ciniml/fpga_samples/README.md

# FPGA Samples

GOWIN LittleBeeなどの小規模FPGA向けのサンプルやライブラリ

## 内容

### rtl

SystemVerilogで記述したモジュール

### src/main/scala

Chisel3で記述したモジュール

### src/test/scala

Chisel3で記述したモジュールのテスト

## ライセンス

Boost Software License 1.0
