ciniml/fpga_samples/rtl/displayport/doc/edp_typec_altmode.md

# eDP 対応 / USB Type-C DP Alt Mode 対応の検討

現行資産 (DP 1.2 Source, RBR 1.62Gbps / 1レーン, Tang Primer 25K + Pmod DP,
FemtoRV32 FW によるリンクポリシー) を出発点に、(1) eDP パネル直結、
(2) USB Type-C DP Alternate Mode ソース、それぞれに必要な回路上の課題と
論理回路構成の変更を整理する。

---

## 1. eDP 対応

eDP はプロトコル的には DP のサブセット+拡張であり、メインリンク/AUX/8b10b/
フレーミングはそのまま流用できる。差分は主に「パネルは常時接続の既知デバイス」
であることに由来する。

### 1.1 回路上の課題

| 項目 | 内容 |
|---|---|
| コネクタ | eDP パネルは 30/40 ピン FPC (I-PEX 20453/20455 系など)。Pmod DP からの変換基板が必要。レーン数/ピン配置はパネルデータシート依存 |
| 電源シーケンス | パネル VDD (3.3V) → AUX/メインリンク → バックライトの順序と T1〜T12 タイミング制約 (eDP 規格 §T-parameters)。違反するとパネルが応答しない/劣化する。電源イネーブル用 FET スイッチと GPIO 制御が必要 |
| バックライト | LED ドライバ (昇圧、定電流) が別途必要。調光は PWM ピンまたは AUX (DPCD 0x720 系 backlight control) |
| 信号振幅 | eDP は低振幅スイング (200mV 級) が既定。現行 TLVDS_OBUF の振幅 (約350mV) はレシーバ耐性的には通常問題ないが、パネルによっては上限確認が必要 |
| HPD | パネルの HPD は「パネル準備完了」通知 (ホットプラグではない)。プルダウン/レベルは現行回路のままで可 |
| AUX プルアップ/ダウン | 現行 Pmod と同じ (AUX は 1Mbps Manchester、変更なし) |

### 1.2 論理回路 (RTL) の変更

1. **ASSR (Alternate Scrambler Seed Reset)** — 最重要。多くの eDP パネルは
   ASSR 必須 (eDP セキュリティ要件)。SR 受信時のスクランブラシード初期値を
   0xFFFF → **0xFFFE** に切り替える。
   - `scrambler.veryl`: シード定数を入力ポート化 (1 ビット選択で十分)
   - `main_link_tx_lane` 経由で CPU レジスタ (MAIN_LINK CTRL の空きビット) に接続
   - FW: DPCD 0x0000D (eDP_CONFIGURATION_CAP) を読み、0x0010A
     (eDP_CONFIGURATION_SET) bit0 で ASSR 有効化してからトレーニング
   - CDC: 準静的 (トレーニング前に設定) なので既存の 2FF 同期+false path 方式
2. **Fast Link Training / No-AUX training (任意)** — パネルが
   NO_AUX_HANDSHAKE_LINK_TRAINING に対応する場合、AUX 応答を待たず固定時間で
   TPS1→TPS2→通常動作に遷移できる。RTL 変更は不要 (パターン切替は既存レジスタ)
   で、FW のシーケンス追加のみ
3. **中間リンクレート (任意)** — eDP 1.4 の 2.16/2.43/3.24Gbps 等は PLL/OSER の
   再設計になるため当面対象外。RBR/1 レーンで一般的な HD 未満のパネルを駆動する
   場合は変更不要 (帯域: RBR 1 レーンで 1366x768@60 8bpp は不可、1024x600@60 等
   は可 — パネル選定に制約)
4. **バックライト/電源 GPIO** — cpu_io_out の空きビットをトップレベルで
   パネル電源/バックライトイネーブルに割当て (RTL は配線のみ)。PWM 調光を
   FPGA で行うなら小さな PWM モジュールを追加

### 1.3 FW の変更

- 電源シーケンサ (T1〜T12 のタイマ、GPIO 制御)
- ASSR 設定 → (Fast) リンクトレーニング → 映像有効化
- EDID が無いパネルへの対応 (タイミングを FW 定数で保持 — 現行の
  VideoConfig 方式そのままで適合)
- バックライト制御 (PWM duty または DPCD 0x720 系)

### 1.4 まとめ (eDP)

RTL 差分は実質 **ASSR のシード切替 1 点**。残りは基板 (電源シーケンス、
バックライト、コネクタ) と FW。現行アーキテクチャの半レートモード
(27Mpix) / フルレート (54Mpix) の制約内で駆動できるパネルを選ぶのが現実的。

---

## 2. USB Type-C DP Alternate Mode (ソース側)

Alt Mode は「DP 信号を Type-C コネクタのピンに載せ替える」仕組みで、
メインリンク/AUX のプロトコル自体は不変。課題のほぼ全てが
**USB PD (Power Delivery) ネゴシエーションと物理的なレーン切替** にある。

### 2.1 回路上の課題

| 項目 | 内容 |
|---|---|
| PD PHY | CC ライン上の BMC 変調 PD 通信は FPGA 直結不可 (1.2V 系アナログ)。PD PHY チップが必須。選択肢: (a) FUSB302B (I2C, PD スタックはホスト側=FW 実装)、(b) CYPD3125/STUSB4500 系スタンドアロン PD コントローラ (Alt Mode VDM まで自律処理する品種は限られる)、(c) TI TPS65982 等フル機能 PD+mux 統合 (BGA、入手性難) |
| 表裏反転 (orientation) | Type-C は表裏どちらでも挿せる。DP レーンを CC 判定結果に応じて物理的に入れ替える **SS mux (例: TI HD3SS460, PI3USB30532)** が必要。FPGA の出力ピンを 2 組用意して論理側で切り替える案は、82ns 級の高速差動を 2 系統引き回すことになり基板設計負荷が大きい → mux チップ推奨 |
| ピンアサイン | DP Alt Mode Pin Assignment C (4 レーン DP) / D (2 レーン DP + USB3)。現行 1 レーンでも「C の Lane0 のみ駆動」で成立する (シンク側は Configure で通知されたアサインの Lane0 から使う) |
| AUX の配線 | Type-C では AUX は SBU1/SBU2 に割当て。orientation で SBU も入れ替わるため、SS mux か専用 SBU スイッチ (例: HD3SS3220 内蔵、または FSA4159 級アナログ SW) が必要 |
| HPD | 物理ピンが存在しない。シンク→ソースの HPD/IRQ は **PD の Attention/Status Update VDM** で通知される。PD コントローラ経由で FW に伝える |
| VBUS/VCONN | ソースとして最低 5V VBUS 供給 (Rp 提示)。VCONN (E-Marker ケーブル給電) も規格上必要 |

### 2.2 論理回路 (RTL) の変更

1. **メインリンク/AUX: 変更ほぼ不要**。1 レーン RBR のままなら信号は現行と同一。
   将来 2 レーン (Pin Assignment D) に広げる場合はレーン複製 (roadmap の
   マルチレーン項目) が先行課題
2. **HPD の仮想化** — 現行 `hpd_in` は物理ピン前提。Alt Mode では PD
   コントローラからの通知 (I2C 読出し or 割込み) を FW が受け、
   仮想 HPD として扱う必要がある。
   - 案: SYSTEM レジスタに「FW が書ける仮想 HPD ビット」を追加し、
     `aux_ch_subsystem` の HPD 検出器の入力を `hpd_in | hpd_virtual`
     (または選択 mux) にする — 小規模な RTL 変更
   - HPD パルス幅分類 (IRQ/unplug) は PD の Attention メッセージ側で
     判別済みなので、仮想 HPD では分類器をバイパスするレジスタ経路が素直
3. **I2C マスタ** — PD PHY (FUSB302 等) 制御用。FemtoRV32 のレジスタ空間に
   I2C マスタペリフェラルを追加 (ソフト I2C を cpu_io_out の GPIO ビットで
   実装する手もあり、PD のタイミング要件的には HW マスタ推奨)
4. **レーン極性/順序反転 (保険)** — mux チップを使わず基板で反転を吸収する
   構成を選ぶ場合、10b シンボルのビット順反転・P/N 反転オプションを
   シリアライザ手前に入れる (数行の組合せ回路)。HD3SS460 採用なら不要

### 2.3 FW の変更 (最大の作業項目)

- **USB PD スタック**: Source ポリシー (Rp 提示、Source Capabilities、契約成立)
- **VDM シーケンス**: Discover Identity → Discover SVIDs (0xFF01 = DisplayPort)
  → Discover Modes → Enter Mode → DP Status Update → **DP Configure**
  (ピンアサイン C を指定) → mux/orientation 設定 → 以降は通常の DP ブリングアップ
- Attention 受信 → 仮想 HPD/IRQ_HPD への反映
- FUSB302 採用時は PD スタックを自前実装 (数千行規模、ただし
  ソース固定・Alt Mode 固定に絞れば大幅に削減可能)。
  スタンドアロン PD コントローラ採用ならレジスタ設定のみに縮む

### 2.4 段階案

1. **Step 0 (回路PoC)**: 市販の「Type-C → DP 変換基板 (シンク方向)」を逆用は
   不可 (方向が逆) — ソース用には PD コントローラ+mux 搭載の自作基板か、
   Alt Mode ホスト評価ボードが必要。まず FUSB302B + HD3SS460 + Type-C
   レセプタクルの小基板を起こすのが現実的
2. **Step 1**: 仮想 HPD レジスタ + I2C マスタを RTL に追加 (eDP とは独立、
   シミュレーションで検証可能)
3. **Step 2**: PD スタック FW (Source 固定、PD2.0 レベルで可) + VDM
4. **Step 3**: 実機で Configure 後に既存 DP ブリングアップへ接続

### 2.5 まとめ (Type-C)

RTL 差分は **仮想 HPD と I2C マスタの追加程度**で小さい。支配的なのは
(a) PD PHY / SS mux を載せた回路 (Pmod では完結しない、専用基板が必要) と
(b) PD/VDM の FW スタック。スタンドアロン PD コントローラを選べば FW も
大幅に軽くなるが、Alt Mode ソースを自律処理できる石の選定が鍵。

---

## 3. 共通の示唆

- どちらも**メインリンク RTL は現行のまま通用**する (eDP は ASSR のみ追加)。
  現在の 480p 半レートモード/タイミングクローズ資産はそのまま活きる
- 先行して入れておくと両対応が楽になる RTL 変更:
  1. スクランブラシード選択 (ASSR) — 1 ビット
  2. 仮想 HPD レジスタ経路 — SYSTEM レジスタ 1 ビット+mux
  3. I2C マスタペリフェラル (PD PHY 用、eDP でも外部 EEPROM/センサ流用可)
- 帯域は RBR×1 レーンが上限 (有効 1.296Gbps ≒ 54Mpix @24bpp)。eDP パネルや
  Alt Mode モニタで実用解像度を出すにはマルチレーン化 (roadmap 既載) が
  中期課題になる

---

## 4. 4レーン対応後の再評価 (2026-07-20 追記)

RBR×4レーン (コミット 1f6a060 で実機1080p60動作確認済み) を前提に、
両対応の見通しを更新する。

### 4.1 帯域とモードの整理

| 構成 | 有効帯域 | 24bpp での上限例 |
|---|---|---|
| RBR×1 | 162 MB/s | 480p/576p (27MHz) |
| RBR×2 | 324 MB/s | ~1600x900RB (97.75MHz=293MB/s) |
| RBR×4 | 648 MB/s | 1080p60 (148.5MHz) 実証済み |

### 4.2 「整数モードフィッティング」— eDPパネル駆動の鍵

現アーキテクチャの制約は「TU充填数 tu_active が整数」かつ
「line_symbols = htotal × LS/pclk が整数」。これは任意の tu_active =
k (1..64) に対して

    pclk = 162MHz × lanes × k / (64 × 3)

の**離散グリッド**のピクセルクロックをサポートすることを意味する:

- 4レーン: 3.375 MHz 刻み (k=42 → 141.75MHz, k=44 → 148.5MHz, ...)
- 2レーン: 1.6875 MHz 刻み
- 1レーン: 0.84375 MHz 刻み

eDPパネルは native タイミング固定ではなく、データシートに pclk と
ブランキングの許容範囲を持つ (典型: pclk ±5〜10%、htotal/vtotal に
min/max)。グリッド刻みが十分細かいため、**ほぼ任意のパネルを
「範囲内の整数フレンドリな pclk + htotal 調整 (LS/pclk = N/D の D の
倍数に選ぶ)」で駆動できる**。分数TU充填 (M/N計測ハードウェア) を
実装しなくても実用になる見込み。LINE_SYMBOLS/ACTIVE_WINDOW が
FWレジスタ化済みなので、この適合計算は全てFW側で完結する。

例: 1080p eDPパネル (pclk許容 130〜150MHz):
k=42 → pclk 141.75MHz、LS/pclk = 8/7 → htotal を7の倍数 (例 2058)、
vtotal 2058×?…refresh = 141.75M/(htotal×vtotal) を60Hz近傍に調整。

### 4.3 新たに見えた作業項目

1. **2レーンモード (中規模RTL)** — 現在 1/4 レーンのみ。eDPパネルの
   多数派 (30ピン2レーン品) と Type-C Pin Assignment D に必要。
   - フレーマ: ヘッダ (VB-ID,Mvid,Maud)×2/レーン、MSA 2レーン配置
     (21シンボル/レーン、Fig 2-18 — 仕様抽出済み)
   - ピクセルステアリング: pixel 2N→lane0, 2N+1→lane1
   - FIFO: quad の 2ピクセル語版 (または quad を2レーン読みに縮退)
   - 検証は quad TB の流用で低リスク
2. **ASSR (小規模RTL)** — スクランブラシード 0xFFFF→0xFFFE 切替 1ビット。
   共有LFSR化済みなので変更箇所は1定数+レジスタ1ビットのみ
3. **仮想HPDレジスタ (小規模RTL)** — Type-CのHPD-over-PD用
4. **I2Cマスタ (小規模RTL)** — PD PHY (FUSB302B) 制御用
5. (任意) 分数TU充填 — 4.2 の適合で足りないパネルが出た場合のみ

### 4.4 Type-C 側の更新

- **Pin Assignment C (4レーンDP) が実力で使える**ようになったため、
  USB-Cモニタへの1080p60出力は基板 (PD PHY + HD3SS460 mux + SBU SW +
  VBUS) と PD/VDM FW だけが残作業
- Assignment D (2レーンDP+USB3) は上記 2レーンモード実装後に対応可
- 4 OSER10 + 810MHz クロック網はタイミングクローズ済み構成をそのまま
  流用できる (162.3MHz)

### 4.5 推奨着手順序

1. ASSR + 仮想HPD + I2Cマスタ (すべてシミュレーションのみで検証可能、
   基板不要)
2. 2レーンモード (RTL+TB、基板不要)
3. Type-C 小基板設計 (FUSB302B + HD3SS460 + Type-Cレセプタクル) と
   PD Source FWスタック
4. eDPパネル選定 (40ピン4レーン品 or 2レーン品+2レーンモード) と
   変換基板・電源シーケンス回路

---

## 5. Type-C基板 具体構成案 (2026-07-21)

**採用方針: FUSB302B (PD PHY) + TI HD3SS460 (Alt Mode mux) の2チップ構成。**
HD3SS460は4レーンSSクロスポイントとSBU低速クロスポイントを1チップに
内蔵し、制御もピン(AMSEL/POL/EN)のみでFW負荷が最小。価格も安く、
FUSB340×2+SBUスイッチの分担構成(下記5.1〜、比較のため残す)より
部品点数・配線とも簡単になる。

### 5.0 HD3SS460構成

```
FPGA ML0..3 --100nF AC結合--> HD3SS460 (4レーンSS + SBUクロス) --> USB-C
FPGA AUX± (TLVDS_IOBUF+バイアス) --> HD3SS460 SBU側低速ポート
FPGA I2C <---> FUSB302B <---> CC1/CC2 (+VCONN)
FPGA GPIO: HD3SS460 {AMSEL(4レーンDPモード固定可), POL(向き), EN} + VBUS EN
5V --> 電流制限ロードスイッチ --> VBUS
```

- AMSELは4レーンDP固定でよい (Assignment C専用機として設計)。将来
  Assignment D対応時にFW制御へ昇格
- POLはFUSB302Bの向き判定結果をFWがGPIOで反映
- 追加部品はVBUSロードスイッチ・ESD・AC結合・AUXバイアスのみ
  (SBUスイッチ不要)

### 5.1 (比較対象) FUSB340×2の役割と個数

### 5.1 FUSB340の役割と個数

FUSB340はUSB3.1向けの表裏反転スイッチで、コモン側2差動ペア↔コネクタ側
4差動ペア(TX1/RX1/TX2/RX2)の2:1muxを1個で構成する。**DP Alt Mode
Assignment C (4レーン) にはSSペア4組すべてにDPレーンを載せる**ため、
2個使いにする:

- FUSB340 #A: コモン側 = ML0, ML1 → 正転時 TX1/RX1、反転時 TX2/RX2
- FUSB340 #B: コモン側 = ML2, ML3 → 正転時 TX2/RX2、反転時 TX1/RX1
- 両者のSELをFW GPIOで相補制御 (CC判定結果に従う)

パッシブ双方向muxなので「RX位置にソースのTXを流す」DPの使い方でも
問題ない。帯域10Gbps級でRBR 1.62Gbpsは余裕。

### 5.2 ブロック図

```
FPGA ML0..3 --100nF AC結合×4ペア--> FUSB340 x2 --> USB-C SS1/SS2ペア
FPGA AUX± (TLVDS_IOBUF+バイアス) --> SBUクロスバSW --> SBU1/SBU2
FPGA I2C (実装済みマスタ) <--------> FUSB302B <---> CC1/CC2 (+VCONN)
FPGA GPIO(cpu_io_out) ------------> FUSB340 SEL x2 / SBU SW SEL / VBUS EN
5V --> 電流制限ロードスイッチ --> VBUS
```

### 5.3 追加で必要な部品

| 部品 | 役割 | 候補 |
|---|---|---|
| SBUクロスバスイッチ | AUX±をSBU1/2へ、反転時は入替え | TS3USB221 / FSUSB42 / NX3L2267 等 (1MHz Manchesterなので低速品で可) |
| VBUSロードスイッチ | ソースとして5V供給 (電流制限付き) | AP22653, TPS25200 等 |
| ESD保護 | SS/SBU/CC | TPD4E05U06 等 |
| AC結合コンデンサ | MLレーン4ペア (DP規格必須) | 100nF 0201/0402 ×8 |
| AUXバイアス | AUX+ 100kΩプルダウン / AUX- 100kΩプルアップ (ソース側規定) | — |

### 5.4 FUSB302B側の留意点

- Rp提示・アタッチ検出・BMC PD送受・VCONN供給まで1チップで担える
- INT_Nは配線しておくが、FWは当面**I2Cポーリング**で十分 (現RTLに
  入力GPIOが無いため。必要になればSYSTEMレジスタに入力ビットを追加)
- HPDは物理線なし: PDのAttention/Status VDMをFWが受けて**実装済みの
  仮想HPDレジスタ (SYSTEM HPD bit4)** に反映する

### 5.5 FWドライバの作業分解 (FUSB302B)

1. 初期化: SW_RES → 電源/測定ブロック設定 → Rp提示 (Source)
2. アタッチ検出: CC測定 → 向き判定 → FUSB340 SEL/SBU SEL設定
3. PD契約: Source_Capabilities (5V固定で可) → Request受理 → Accept →
   PS_RDY
4. VDM: Discover Identity → Discover SVIDs (0xFF01確認) →
   Discover Modes (**UFP_DピンアサインマスクでC対応を確認**) →
   Enter Mode → DP Status Update → DP Configure (Assignment C, 4レーン)
5. Attention受信 → 仮想HPD更新 → 以降は既存のDPブリングアップへ合流
6. (省略可) SOP'ケーブルe-marker確認、PD3.0対応、Sink役割

### 5.6 未決事項

- 基板はPmod 2口分の高速ピンを使うか、専用ドーターか (MLペア4+AUX+
  I2C+GPIO×4+5Vで、現Pmod DPのピン割当を流用しつつ拡張が必要)
- USB2.0 D+/D-は未接続で可 (映像専用。Billboardデバイス非搭載だと
  Alt Mode失敗時にホスト側へ通知されないが、ソース用途では不問)

## 実機開通記録 (2026-08-06)

Tang Primer 25K + 自作Type-C基板(FUSB302B+HD3SS460) → XREAL Air 2 で
1080p60表示に成功。ブリングアップで確定した要点:

1. HD3SS460のEN/AMSEL/POLは3値ピン(H≥VCC-0.4V)。2.5Vバンクからは
   オープンドレイン駆動+基板10kプルアップ(3.3V)でHを作る(top.svは
   明示IOBUF)。4レーンDP = AMSEL=H, EN=H, POLは向き
2. シンクがプラグ(AMA/キャプティブケーブル)の場合、Mode VDOのピン
   アサインはbits15:8を読む(bit6=receptacle判定)
3. SourceCapは5V/3A広告(0.9AではCapability Mismatchでパネル起動保留)
4. Enter Mode NAK時はExit Mode→再Enter(前セッションのモード残留対策)
5. HPDはConfigure後のAttention/Status VDOで受ける。Air 2は約20秒かかる
   ので必ず待つ(HPD前にリンクを張るとレシーバが巻き込まれ停止)
6. **Air 2は映像アクティブ中にAUXが約1秒無通信だとHPDを落として切断**
   (キープアライブ)。モニタループは100ms間隔でstatusポーリング
