ciniml/fpga_samples/eda/csi_capture/hw/Pmod_RPiCamera/fab/Pmod_RPiCamera_schematic.pdf

1 | 2 | 3 | 4 | 5 | 6
1 | 2 | 3 | 4 | 5 | 6

AB

C

D

AB

C

D Date: 2026-10-12

Size: A4 | Rev: A
KiCad E.D.A. 10.0.6 | Id: 1/1

## Title: Pmod RPi Camera (MIPI CSI-2)

File: Pmod_RPiCamera.kicad_sch

Sheet: /

fpga_samples / eda/csi_capture

Raspberry Pi Camera v2 (IMX219) and other 15-pin 2-lane CSI-2 cameras GND

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
J1 Pmod (host) | GND 1 | D0_N 2 | D0_P 3 | GND 4 | D1_N 5 | D1_P 6 | GND 7 | CLK_N 8 | CLK_P 9 | GND 10 | CAM_GPIO 11 | CAM_CLK 12

SCL 13
SDA 14
3V3 15 | MP MP

J2

SFW15R-1STE1LF R2

2.2k | +3V3R3

10k +3V3 R1

2.2k +3V3 | GND

# GND +3V3 PWR_FLAG

PWR_FLAG | +3V3

F1
500mA hold GND

C1

10u | +3V3 +3V3_CAM CAM_SDA | CAM_GPIO

CSI_CLK_P

CAM_SDA | CAM_SCL | CSI_D1_N

CAM_SCL +3V3_CAM

GND

# CAM_SDA GND +3V3

CSI_CLK_N

CSI_D0_N +3V3 GND

CSI_D1_N | +3V3_CAM

CSI_D0_P

GND

GND

CSI_CLK_N +3V3 | CAM_GPIO

CAM_SCL CSI_CLK_P

GND

CSI_D1_P

CSI_D1_P

CSI_D0_P
GND

CSI_D0_N

CAM_GPIO (camera power enable) pulled up: the camera powers with the Pmod. CAM_CLK not used. J2: Amphenol SFW15R-1STE1LF (bottom contact, pin 1 as in FCI JSA95855), the same part as J1 of the Camera Module 2. The standard RPi camera cable has its contacts on opposite faces at the two ends: pin n meets pin n. F1 limits a wrong cable. Soft D-PHY receiver: FPGA LVDS inputs with on-chip 100R termination, no LP receivers

(eda/csi_capture, rtl/csi2). Lanes are DC coupled: no series R, no AC coupling, no bias. CSI pairs: 100 ohm differential, routed on F.Cu over solid B.Cu ground, no vias. Pmod RPi Camera: Raspberry Pi camera (15-pin FFC, 2-lane MIPI CSI-2) on one Pmod. | GND

J2
SFW15R-1STE1LF GND 1 | D0_N 2 | D0_P 3 | GND 4 | D1_N 5 | D1_P 6 | GND 7 | CLK_N 8 | CLK_P 9 | GND 10 | CAM_GPIO 11 | CAM_CLK 12

SCL 13
SDA 14
3V3 15 | MP MP
