ciniml/fpga_samples/eda/ethernet_hub75/README.md

# ethernet_hub75 — Ethernet / UDP 映像入力 → HUB75 LED マトリクス (Veryl)

PC から UDP で送った映像 (RGB565) を受けて HUB75 パネルに表示する。RTL はすべて Veryl で書いた。
プロトコルは Chisel 版 (`eda/ethernet_video`、`EthernetVideoSystem`) と互換で、送信側は既存の
`util/udpvideosend` / `util/play_video.sh` をそのまま使う。

| ボード | PHY | パネル | 状態 |
|---|---|---|---|
| Tang Primer 20K (Dock) | RTL8201F、RMII 100M | HUB75 ×2 系統 (各 64x64 ×2 枚のチェーン) = 128x128 | シミュレーション・配置配線 OK、実機未確認 |
| DK_LED-RXCARD_GW3A-LV20UG324S_V2.1 (Arora III) | RTL8211E、RGMII 10/100/1000M | HUB75 J4〜J9 に 64x64 を 1 枚ずつ、横 2 × 縦 3 = 128x192 (`PANEL_ROWS=2` で上 4 枚 128x128)。DDR2 版は J4〜J19 の 16 枚 (横 4 × 縦 4 = 256x256) まで | ソフト版 6 枚 / 4 枚、DDR2 フレームバッファ版 6 枚は実機で表示 OK (1000M)。GMT 版 (4 枚) と 16 枚構成はシミュレーション・配置配線 OK、実機未確認 |

```
PC (udpvideosend) ── UDP 10004 ──► PHY ─ RmiiRx ─ EthRxMac ─(PktFifo: PHY clk → sys)─► EthService ─► UdpVideoWriter
                 ◄── 0xdeadbeef ──      RmiiTx ─ EthTxMac ◄─(PktFifo: sys → PHY clk)──┘   ARP / ICMP     │ 色テーブル
                                                                                                         ▼ lane / addr / RGB666
                                                       Hub75Lanes: ダブルバッファ (sys 書き込み / 表示読み出し)、6 bit BCM
                                                                                                         ▼
                                                                                         HUB75 ×N レーン (CLK / LAT / OE / A–E 共通)
```

## ソースの構成

| 場所 | モジュール | 内容 |
|---|---|---|
| `rtl/eth_mac` | `Crc32Pkg` `PktFifo` | riscv-veryl から無変更でコピー (Tang Primer 20K の実機で動作済み)。`PktFifo` はデュアルクロックのストア＆フォワード FIFO で、受信は FCS の正しいフレームだけを読み手に見せる |
| | `EthRxMac` `EthTxMac` | PHY に依存しない MAC の受信 / 送信。riscv-veryl の `EthMac` の RX / TX エンジンを、CPU バスのレジスタ部を外して切り出した。PHY アダプタとは「SFD 後のバイト列」と「バイト要求 (`i_ce`)」でつなぐ |
| | `RmiiRx` `RmiiTx` | RMII アダプタ (100M) |
| | `RgmiiRx` `RgmiiTx` | RGMII アダプタ (10/100/1000M)。DDR の入出力レジスタ (ベンダのプリミティブ) はボードのトップに置き、その出力 / 入力だけを扱う。送信は全速度を 125 MHz 1 本で回す |
| | `RgmiiSpeedMeter` `MdioMaster` | RXC の周波数からリンク速度を判定 (MDIO のポーリング不要) / clause 22 の MDIO |
| `rtl/hub75` | `Hub75Lanes` | `Hub75` (dvi_hub75 と共通) の BCM 走査をそのまま使い、データ側を N レーン + デュアルクロックのフレームバッファにしたもの。`Hub75` 自体は変更していない |
| | `Hub75Planes` | `Hub75Lanes` のフレームバッファをビットプレーン形式 (1 ワード = 1 色 1 プレーンの 32 画素分) にしたもの。GMT 版で使う |
| | `Hub75RowLanes` | `Hub75Lanes` のフレームバッファを、レーンごとのピンポン行バッファ (2 × 64 画素) と「次の行をくれ」のハンドシェイクにしたもの。DDR2 版で使う |
| `rtl/ddr2` | `Ddr2Ctrl` `Ddr2PhyGw3a` | DDR2 コントローラ (x16、BL8、開いた行 1 本、読出の自動キャリブレーション) と GW3A の IOLOGIC (OSER8 / IDES8) による PHY。`rtl/ddr2/README.md` |
| `src/common` | `EthService` | ARP 応答、ICMP echo (TX FIFO に入る大きさまで)、UDP の振り分け。映像の送信元を覚えておき、表示切り替えのたびに ack を返す |
| | `UdpVideoWriter` | オフセット付きのバイト列 → 画素 → 色テーブル → レーン / アドレス。フレームの最終バイトで表示切り替えを要求する |
| | `GmtCornerTurn` | GW3A の GMT ハードブロック (`GMT_DB`) で 32 画素 × RGB666 を転置し、プレーンワードにして `Hub75Planes` に書く |
| | `DdrFb` `FbAfifo` | DDR2 版のフレームバッファ: UDP のバイト列を 16 B のワードにして DDR2 クロックへ渡し (async FIFO)、表示側の行要求に応じて DDR2 から行を読み、色テーブルを通して行バッファに書く。起動時のメモリテストとクリアもここ |
| | `EthernetHub75Core` | 上をつないだボード非依存のコア。クロックは PHY 受信 / PHY 送信 / システム / 表示の 4 系統 (同じでもよい)、DDR2 版はそれに DRAM の系統。`HUB75_IMPL` で出力段を選ぶ (0 = `Hub75Lanes`、1 = `GmtCornerTurn` + `Hub75Planes`、2 = `DdrFb` + `Hub75RowLanes`) |
| `src/tangprimer20k` | `TangPrimer20kTop` | PLL (27 → 49.5 MHz)、リセット、RMII アダプタ、ピン、LED |
| `src/dk_led_rxcard_gw3a20` | `DkLedRxcardTop` `Rtl8211eInit` | PLLB (50 → 125 / 50 / 333.3 MHz)、RGMII (IDDR / ODDR / IODELAY)、PHY の RGMII 遅延設定 (MDIO)、DDR2 (コントローラ + PHY)、ステータス、ピン、LED |

Veryl のプロジェクトはこのディレクトリ (`Veryl.toml`) で、`rtl/eth_mac`、`rtl/hub75`、`rtl/ddr2` をパス依存で取り込む
(生成される SV のモジュール名は `eth_mac_EthRxMac` のように依存先の名前が前に付く)。

## プロトコル (Chisel 版と互換)

- **映像:** UDP 宛先ポート 10004。ペイロード = 2 バイトのバイトオフセット (ビッグエンディアン) + データ。
  データは RGB565 リトルエンディアン、画面全体を行優先 (128x128 なら 32768 B。udpvideosend は 1024 B ずつ 32 パケット)
- **64 KB を超えるフレーム (追加):** 256x256 (128 KB) などではオフセットを 2 バイト単位で数える (最大 128 KB)。
  受信側はフレームの大きさから自動で切り替え、udpvideosend / `tools/testcards.py` も同じ規則で送る。64 KB 以下は元のまま
- **表示切り替え:** フレームの最終バイト (オフセット 32767) を書いたら切り替えを要求し、パネルの次のフレーム境界で切り替える
  (ティアリングなし)。切り替わったら、最後に映像を送ってきた送信元 (MAC / IP / ポート) に 4 バイトの `de ad be ef` を返す。
  udpvideosend はこの返信でペースを取る (返信がなければ 100 ms で次へ進む)。切り替え待ちの間に届いた映像データは捨てる
- **アドレス:** 192.168.10.2、MAC 11:22:33:44:55:66 (どちらも Chisel 版と同じ既定値、`EthernetHub75Core` のパラメータ)。
  この MAC は先頭バイトのグループ (マルチキャスト) ビットが立っている。Chisel 版ではこれで動いていたので互換のために残したが、
  PC 側で ARP が解決しないときは `02:…` などのローカル管理アドレスに変える
- **ARP / ICMP:** ARP 要求 (宛先ブロードキャストまたは自分) に応答、ICMP echo に応答 (`ping 192.168.10.2`)
- **色テーブル (追加):** UDP 宛先ポート 10005。ペイロード = チャネルマスク 1 バイト (bit0 R、bit1 G、bit2 B) + 8 bit 値
  (エントリ 0 から。R / B は RGB565 の 5 bit 値で引く 32 エントリ、G は 6 bit 値で引く 64 エントリ)。上位 `COMPONENT_BITS` bit を使う。
  リセット後は恒等 (ビット複製で 6 bit に伸ばす = Chisel 版と同じ見え方)。ホストからは `tools/send_lut.py gamma 2.2` など
- **ステータス (追加):** UDP 宛先ポート 10006 に何か送ると、送信元へ 48 バイトの状態を返す (DDR2 の初期化・キャリブレーション・
  読出位置の調整結果、メモリテストのエラー数 (パス別・ビット別)、リンク速度、表示したフレーム数など。中身は
  `src/dk_led_rxcard_gw3a20/top.veryl` の冒頭)。ホストからは `tools/fbstat.py`
- **制御 (追加、DDR2 版の診断用):** UDP 宛先ポート 10007。DDR2 の読出位置の上書きとメモリテストの再実行 (フレームバッファは
  消える)。`tools/ddr2sweep.py` は RD_LAT × RD_SEL を総当りして読出の目を測る
- **Chisel 版からの変更点:** 表示切り替えの 20 Hz 上限をなくした (パネルのフレーム境界で切り替え)。ポート 10000 (ループバック)、
  10001 (GPIO)、10002 / 10003 (音声) は持たない。色テーブルのポート 10005 を足した

帯域は 128x128 × 16 bit × 60 fps でペイロード 15.7 Mbps、ヘッダ込みで約 16.5 Mbps なので、100M で足りる。
udpvideosend は 1 フレーム分 (32 パケット) を間を空けずに送るので、GbE では受信側がワイヤレート (125 MB/s) で
処理し続ける必要がある。Arora 版はそのためシステムクロックを 125 MHz にしている (1 バイト / クロック)。
オフセットが 16 bit なので、元の形式で送れるのは 64 KB (128x256 相当) まで。それより大きいフレームは上の 2 バイト単位で送る。

## Tang Primer 20K

- **PHY:** Dock の RTL8201F (RMII)。50 MHz の基準クロックは PHY から来る (`rmii_txclk` = A9)。PHY はリセット中に
  クロックを止めるので、PHY のリセットピンはシステムクロック側で約 21 ms 駆動し、RMII 側のリセットはクロックが
  動き出してから外れるよう、その倍の時間かける
- **パネル:** `mod/pmod_hub75` + `mod/pmod_hub75_2` (eda/ethernet_video と同じピン)。2 系統は CLK / LAT / OE / A–E が共通で、
  各系統に 64x64 パネルを 2 枚チェーン (128x64、1/32 スキャン)。レーン 0–3 = 系統 1 の R1 / R2、系統 2 の R1 / R2 で、
  表示の行 0–31 / 32–63 / 64–95 / 96–127 に当たる
- **クロック:** システム・表示とも 49.5 MHz (27 MHz × 11 / 6)。HUB75 CLK = 49.5 / 3 = 16.5 MHz (Low 2 + High 1 クロック、
  dvi_hub75 の実機で通った 16.7 MHz とほぼ同じ)
- **LED (Active Low):** 0 = パネルのフレームごとに点滅 (約 1.4 Hz)、1 = 映像パケット受信、2 = ARP / ICMP 応答、
  3 = FCS 不良フレーム、4 = 表示切り替え、5 = PLL ロック

### 結果 (Gowin 1.9.12.03、GW2A-LV18PG256C8/I7)

| 項目 | 値 |
|---|---|
| 論理 | 2923 / 20736 (15%) — LUT 2440、ALU 273、SSRAM 35 |
| レジスタ | 1426 / 16173 (9%) |
| BSRAM | 44 / 46 — フレームバッファ 36 (レーンごとに 8K×2 bit ×9)、MAC の FIFO 8 (受信 8 KB、送信 2 KB) |
| Fmax | RMII 50 MHz 系 123.3 MHz、システム 49.5 MHz 系 119.9 MHz (違反なし。Arora 向けのレジスタ段追加後) |
| パネルのリフレッシュ | 356 Hz (6 bit BCM、16.5 MHz、シミュレーションで測定) |

BSRAM はほぼ埋まっている。パネルを大きくするなら、BCM のビット数を落とすか、フレームバッファを RGB565 のまま持って
読み出し側で色テーブルを引く形にする必要がある。

## ビルド

```
cd eda/ethernet_hub75
make                     # TARGET=tangprimer20k (既定)。veryl build → Gowin の合成 / 配置配線
make run                 # openFPGALoader で SRAM に書き込み (make deploy でフラッシュ)
make TARGET=dk_led_rxcard_gw3a20                  # Arora III、ソフト版 6 枚 128x192 (build/dk_led_rxcard_gw3a20)
make TARGET=dk_led_rxcard_gw3a20 PANEL_ROWS=2     # Arora III、ソフト版 上 4 枚 128x128 (build/dk_led_rxcard_gw3a20_4p)
make TARGET=dk_led_rxcard_gw3a20 HUB75_IMPL=gmt PANEL_ROWS=2   # Arora III、GMT 版 4 枚 (build/dk_led_rxcard_gw3a20_gmt_4p)
make TARGET=dk_led_rxcard_gw3a20 HUB75_IMPL=ddrplane PANEL_COLS=4 PANEL_ROWS=4   # 16 枚 256x256、8 bit (build/dk_led_rxcard_gw3a20_ddrplane_16p_c8)。展示で使っている構成
make TARGET=dk_led_rxcard_gw3a20 [...] run        # Gowin programmer_cli で SRAM に書き込み (変数はビルドと同じに)
make TARGET=dk_led_rxcard_gw3a20 CONN_ID=1         # 配線確認用: J4〜J19 にコネクタごとの単色 (build/dk_led_rxcard_gw3a20_connid)
make sim                 # テストベンチ (Verilator、Tang Primer 20K)
make -C test rxcard IMPL=soft|gmt|ddr|ddrplane|... [PROWS=2] [PCOLS=4 PROWS=4] [TXS=1]   # テストベンチ (Arora III、PROWS=2 は 4 枚、PCOLS=4 PROWS=4 は 16 枚、TXS=1 は TXC_SHIFTED 版)
```

gw_sh が PATH にないときは `make GW_SH="env LD_LIBRARY_PATH=$HOME/gowin/1.9.12.03/IDE/lib QT_QPA_PLATFORM=offscreen $HOME/gowin/1.9.12.03/IDE/bin/gw_sh"`
(1.9.12.03 の gw_sh は `IDE/lib` を先に読ませないと Qt のプラグインで落ちる)。Arora III のターゲットは
`eda/targets/dk_led_rxcard_gw3a20/target.mk` で 1.9.12.03 の gw_sh を直接指定している (GW3A-20A に対応するのは 1.9.12.03 のみ)。
`HUB75_IMPL` はビルドディレクトリに書き出すパッケージ `ethernet_hub75_cfg` 経由でトップのパラメータになる。
配置オプションは環境変数 `GW_PLACE_OPTION` / `GW_ROUTE_OPTION` で変えられる (Arora III の既定は place 2)。

## シミュレーション (Tang Primer 20K)

`make sim` (`test/tb_tp20k.sv`、Verilator 5): ボードのトップ (`TangPrimer20kTop`) をそのまま使い、RMII の向こう側の
ホストと HUB75 パネルモデルをつなぐ (PLL はシミュレーション用の置き換え、PHY リセットは短縮)。

1. ARP 要求 → 応答のフィールドを照合
2. ICMP echo 64 B / 1000 B → チェックサム (IP / ICMP)、ペイロード、長さを照合
3. FCS を壊したフレーム → 応答しない (捨てる)
4. 映像 1 フレーム (udpvideosend と同じ 32 パケット、乱数の画素) → ack を照合 → パネルモデルの 2 フレーム後の表示を全画素照合
5. 色テーブルを書き換えてから 2 フレーム目 → テーブルどおりの値になっているか全画素照合
6. もう一度 ARP (映像のあとも応答するか)

パネルモデルは CLK の立ち上がりでシフト、LAT ごとにビットプレーンを取り込み (行が変わったら MSB から)、
各プレーンの OE パルス長 (2 × 16 × 2^bit クロック) も検査する。チェーンの向きを反転させたビルドでは全画素が
不一致になることを確認済み (検査が効いていることの確認)。

## 実機の確認手順 (Tang Primer 20K)

1. HUB75 の配線は eda/ethernet_video と同じ (Dock の Pmod に HUB75 ベースボード 2 枚、各系統に 64x64 を 2 枚チェーン)
2. `make run` で書き込む。LED 5 (PLL ロック) が点灯、LED 0 が約 1.4 Hz で点滅すること
3. PC の有線 LAN を 192.168.10.1/24 にして Dock の RJ45 とつなぐ。`ping 192.168.10.2` が返り (LED 2 が点灯)、
   `ip neigh` に 11:22:33:44:55:66 が載ること
4. テストパターン: `cd util/udpvideosend && RUST_LOG=debug cargo run --release -- --width 128 --height 128 --test-pattern`。
   横縞のグラデーションが流れ、LED 1 と 4 が点灯していること。ログの fps が 100 を大きく超えていれば ack でペースが
   取れている (ack が返らないと 1 フレームごとに 100 ms 待つので、10 fps 前後に落ちる)
5. 動画: `cd util && VIDEO_FILE=<動画ファイル> ./play_video.sh` (128x128 に縮小して 20 fps で送る。同時に送られる音声
   (ポート 10002) は受け手がないので捨てられる)
6. 向きの確認: 左右が逆なら `CHAIN_REVERSE` を 1 に (トップのパラメータ)、上下や系統の入れ替わりはレーンの割り当てを見直す
7. ガンマ: `tools/send_lut.py gamma 2.2` / `tools/send_lut.py identity`

## Arora III (DK_LED-RXCARD_GW3A-LV20UG324S_V2.1)

資料: DBUG1298 (このボードのユーザーガイド、中国語版のみ)、DS1351、UG1353 / UG1354 (ピン)、UG311 (GMT)、UG313 (UBM)、
UG317 (クロック)、UG318 (GPIO)。いずれも `https://cdn.gowinsemi.com.cn/<文書番号>.pdf` (英語版は末尾に `E`) から
ログインなしで取れる。回路図そのものは公開されていない。

- **PHY:** RTL8211E ×2 (RGMII)。使うのは U43 ("PHY1": RXC が GCLKT_15 の H4、RXD は IODELAY のあるバンク 6)。
  U42 ("PHY2") の RXC は K4 = GCLKC_13 (相補側) なので使わない。どちらの RJ45 が U43 かは資料に書かれていない
- **RGMII の遅延:** RXDLY / TXDLY のストラップ抵抗が不明なので、起動時に MDIO で全アドレスを走査し、RTL8211E
  (PHY ID 1 = 0x001C) が見つかったら拡張ページ 0xa4 レジスタ 0x1c の bit 13:11 を 111 (強制 + RX / TX 遅延オン) にして
  オートネゴシエーションをやり直す (`Rtl8211eInit`、Linux の realtek ドライバと同じレジスタ。ドライバの定義とコメントで
  bit 12 / 11 のどちらが RX かが食い違っているので、両方を同じにしている)。PHY が遅延を入れるので、TXC は TXD と同じ
  ODDR から位相そろえで出し、受信は RXC で IDDR に直接取り込む。予備として PLL の 270° 出力で TXD を遅らせる版 (`TXC_SHIFTED`) と
  受信データの IODELAY (`RX_DELAY`) をパラメータで用意してある
- **速度:** 10/100/1000M に対応。RXC の周波数 (125 / 25 / 2.5 MHz) で速度を判定し、送信は 125 MHz のまま
  1000M = 毎クロック 1 バイト (DDR)、10/100M = 50 / 5 クロックごとに 1 ニブル (TXC はニブルの中央で立ち上がる)
- **パネル:** HUB75 コネクタ 1 つに 64x64 を 1 枚ずつ (チェーンなし)、横 `PANEL_COLS` (2 / 4) × 縦 `PANEL_ROWS` 枚を
  左上から行優先に J4、J5、… の順で割り当てる。既定は横 2 × 縦 3 で、上段 J4 (左) / J5 (右)、中段 J6 / J7、下段 J8 / J9
  = 128x192。`PANEL_ROWS=2` は上 4 枚 (J4〜J7) で 128x128。`PANEL_COLS=4 PANEL_ROWS=4` は J4〜J7 / J8〜J11 / J12〜J15 /
  J16〜J19 の 16 枚で 256x256 (DDR2 版のみ)。使わないコネクタは 0 (黒) を出す。レーンは幅 64 × 32 行で、表示を行優先に
  切ったもの。パネル (段 p、列 c) の R1 / R2 はレーン 2·PANEL_COLS·p + c / 2·PANEL_COLS·p + PANEL_COLS + c。
  コネクタは 2 組 (J4〜J11、J12〜J19) で、それぞれ CLK / LAT / OE / A–E を 1 本ずつ共有する。2 組目は 9 枚以上のとき 1 組目と
  同じ信号を出し、それ以外は OE を High にして消灯。HUB75 は 74HC245 経由。ピンは DBUG1298 の表 3-6〜3-21
  (J12〜J19 の一部は SSPI / CPU / I2C 兼用ピンなので、`project.tcl` で GPIO として使う設定にしている)
- **クロック:** 50 MHz (B16) → PLLB (VCO 1000 MHz) → システム / RGMII 送信 125 MHz、表示 50 MHz
  (HUB75 CLK = 50 / 3 = 16.7 MHz、dvi_hub75 の実機で通った値)
- **LED (Active Low):** LED1 = PLL ロック中、パネルのフレームごとに点滅 (約 1.4 Hz)。LED2 = 映像 / ARP / ICMP の受信で点灯、
  MDIO で RTL8211E が 1 つも見つからなかったときは速い点滅。ボタン (J6) はリセット

### HUB75 向けハードブロック: GMT

GW3A の「LED 向け」ブロックは HUB75 のドライバそのものではなく、次の 2 つ (どちらも GW3A-20 に 1 個):

- **GMT (Generic Matrix Transpose、プリミティブ `GMT_DB`、UG311):** 32 × 32 ビットの行列転置器 ×4 コンポーネント。
  各コンポーネントにピンポンバッファ 2 面。書き込みは 1 クロック 1 行 (`WADDR[5]` = 面、`WADDR[4:0]` = 行、`WDATA0..3`、`WEN0..3`)、
  読み出しは 1 クロック 1 列 (`RADDR`、データは次のクロック)。書き込みクロック最大 250 MHz、同じアドレスの書き→読み 5 ns 以内。
  書き込み行の付け替え表 (remap、mDRP で設定) あり。パラメータは `WADDR_REMAP_EN`、`COMP_EN`
- **UBM (Universal Bit Mapping、`UBM_DB`、UG313):** 32 ビットの任意ビット並べ替え ×4。GMT の出力をそのまま入力にできる
  (`BIT_REMAP_EN`、`USE_GMT_CLK`)。出力ピンの並びを合わせる用途

LED 受信カードでは「画素ごとのデータ (階調値) → ビットプレーンごとのデータ」への変換 (コーナーターン) を GMT で行う。
32 画素の階調値を 32 行として書くと、列 k を読んだ 32 ビットが「32 画素のビット k」= そのままシフトアウトできる形になる。

### ソフト版と GMT 版

| | ソフト版 (`HUB75_IMPL=soft`) | GMT 版 (`HUB75_IMPL=gmt`) |
|---|---|---|
| フレームバッファ | レーンごとに 1 画素 = RGB666 18 bit のワード | レーン × 色ごとに 1 ワード = 1 プレーンの 32 画素 |
| 書き込み | 画素ごとに 1 ワード | 32 画素を GMT に書き、18 列 (6 プレーン × 3 色) を読み出してワード書き込み |
| 表示 (シフトアウト) | 画素ワードからプレーンのビットを選ぶ (レーン × 3 本の 6:1) | ワードから x % 32 のビットを選ぶ (レーン × 3 本の 32:1) |
| 走査・BCM・タイミング | 共通 (`Hub75` と同じエンジン) | 共通 |

結果 (Gowin 1.9.12.03、GW3A-LV20UG324SC1/I0、place option 2。どちらも Ethernet 部込みの全体)。以下の表は J4 / J6 に 2 枚チェーンを
2 本つないだ最初の構成 (レーン 4 本 × 幅 128) のもの。今のパネル構成 (レーン幅 64) の結果はその下:

| 項目 | ソフト版 | GMT 版 |
|---|---|---|
| LUT / ALU | 2749 / 327 | 3142 / 331 |
| レジスタ | 1723 | 1873 |
| CLS | 2278 / 11520 (20%) | 2633 / 11520 (23%) |
| BSRAM | 84 / 120 — フレームバッファ 72 (レーンごと 18)、MAC の FIFO 12 | 108 / 120 — フレームバッファ 96 (12 メモリ × 8)、FIFO 12 |
| GMT | 0 | 1 (コンポーネント 0 のみ) |
| Fmax (制約) | RXC 225 (125)、システム 125.4 (125)、表示 85.5 (50) MHz | RXC 225 (125)、システム 125.3 (125)、表示 89.0 (50) MHz |
| リフレッシュ | 359.5 Hz (シミュレーションで測定) | 359.5 Hz (同じ) |
| 階調 | 6 bit BCM (RGB666、色テーブル経由) | 同じ |
| 最大シフトクロック | 表示 Fmax / 2 = 42 MHz (`CLK_LOW_EXTRA=0`)、既定は / 3 = 16.7 MHz | 同じ (表示 Fmax / 2 = 44 MHz) |
| 最大パネル (ダブルバッファ、6 bit) | 128x128 (BSRAM で決まる。256x128 には 144 個必要) | 128x128 (256x128 には 192 個必要) |

今のパネル構成 (64x64 を 1 枚ずつ、レーン幅 64):

| 構成 | LUT / ALU | レジスタ | BSRAM | Fmax システム / 表示 (MHz) | リフレッシュ |
|---|---|---|---|---|---|
| ソフト版 6 枚 128x192 (12 レーン) | 3186 / 327 | 1839 | 120 / 120 (100%) | 126.8 / 77.0 | 489.2 Hz |
| ソフト版 4 枚 128x128 (8 レーン) | 2942 / 327 | 1777 | 84 / 120 | 128.0 / 93.1 | 489.2 Hz |
| GMT 版 4 枚 128x128 (8 レーン) | 3635 / 331 | 1991 | 108 / 120 | 125.7 / 89.1 | 489.2 Hz |
| GMT 版 6 枚 | — | — | 入らない (下記) | — | — |

チェーンが 128 → 64 に短くなったので、リフレッシュは 359.5 → 489.2 Hz に上がる (行ごとの固定の待ちがあるので 2 倍にはならない)。
ソフト版 6 枚は BSRAM をすべて使っていて余裕がない。GMT 版はプレーンのメモリ (レーン × 色ごとに 6 プレーン × 128 ワード = 768 ワード)
が 1024 ワード = BSRAM 4 個に切り上げられるので、6 枚では 12 × 3 × 4 = 144 個必要になり入らない (合成がメモリを LUT に回して
リソース超過になる。make はこの組み合わせをエラーにしている)。プレーンを 2 枚ずつ 256 ワードのメモリに分ければ 3 個ずつ = 108 個
(FIFO と合わせて 120 個) にできる見込み

- **このデザインでは GMT 版のほうが重い。** フレームバッファを内蔵 BSRAM に置き、レーンごとに別のメモリを持つ構成では、
  ソフト版は書き込みが画素単位のまま済み、表示側のプレーン選択も 6:1 のセレクタで済むので、転置そのものが要らない。
  GMT 版は転置の制御 (グループ単位の書き出し、表示切り替えの保留) と 32:1 のビット選択が増え、LUT が約 400、FF が約 150 多い
- **BSRAM の差 (+24) はメモリの深さの端数。** プレーンメモリは 1 つ 1536 ワード (6 プレーン × 2 面 × 32 行 × 4 ワード) で、
  Gowin が 2048 ワード分 (8 個) を割り当てる。ビット数はソフト版と同じ (589,824 bit) なので、プレーン数を 8 にそろえる
  (階調 8 bit) か色をまとめたアドレス割り付けにすれば 72 個まで減らせる見込み。リフレッシュ・階調・シフトクロックは
  同じエンジンなので差がない
- **GMT が効くのは、画素データを外部メモリ (このボードの DDR2) に置く構成。** DDR から行単位で画素を読み、GMT でプレーン形式に
  変えて小さな行バッファに置けば、BCM の各プレーンのたびにフレームバッファを読み直さずに済み、パネルの大きさが BSRAM で
  決まらなくなる。そのとき同じ転置をソフトでやると、32 × 32 ビットの転置 1 組に約 1000 個の FF とセレクタが要る。
  4 コンポーネントで 16 本の出力 (このボードは 1 組あたり 48 本、計 96 本) を並列に作れる。今回は内蔵 BSRAM の構成のまま
  比べたので、この利点は数字に出ていない
- 1000M のワイヤレート処理のため、MAC / FIFO / `EthService` に 125 MHz 向けのレジスタ段を足した
  (`PktFifo` のポインタのグレイ→バイナリ変換、残りバイト数、`EthService` の判定、ack のチェックサム)。
  余裕はほぼない (システム 125.3〜125.4 MHz)。place option 1 / 3 では 1 ns 弱届かない

### DDR2 フレームバッファ版 (`HUB75_IMPL=ddr`)

フレームバッファをボードの DDR2 (U46 W9725G6KB、256 Mbit x16、バンク 2 / 3 の 1.8 V) に置く版。コントローラは Gowin の IP を使わず
`rtl/ddr2` に新しく書いた (riscv-veryl の DDR3 コントローラと同じスロットベクタ方式の PHY 境界。詳細は `rtl/ddr2/README.md`)。

```
EthService ─ 映像バイト列 ─ DdrFb: 16 B ワード + フリップ印 ─ FbAfifo (sys 125 MHz → mclk 83.3 MHz) ─┐
                                                                                                  ├─ Ddr2Ctrl ─ Ddr2PhyGw3a ─ DDR2
   Hub75RowLanes ◄─ 行バッファ書き込み ◄─ 色テーブル ◄─ 1 px/clk 展開 ◄─ 読み出し FIFO ◄─ 行フェッチ ──┘   (OSER8 / IDES8、
   (disp 50 MHz)      (レーン × 2 × 64 px)                                                                 fclk 333.3 MHz)
```

- **フレームバッファ:** RGB565 (受け取ったバイト列そのまま) の 2 面。面 b はバーストアドレス b × 4096 (64 KB) から。書き込みは
  16 B ワード単位 (DM が FPGA に繋がっていないため)。udpvideosend は 1024 B ずつ送るので問題ない
- **表示切り替え:** フレームの最終ワードにフリップの印を付けて同じ FIFO を通すので、書き込みとの順序が保たれる。表示側が次の
  フレームの行 0 を要求したときに面を切り替え、ack を返す。切り替え待ちの間の映像を捨てるのも含め、ソフト版と同じ振る舞い
- **行フェッチ:** 走査行 r の表示中に次の行を読む。レーンごとに 64 画素 = 8 バースト (DRAM の同じ行) をまとめて読み、BSRAM の
  32 ワード FIFO に入れてから 1 画素 / クロックで色テーブルを通して行バッファへ。12 レーン分 768 画素で約 9.3 µs、1 行の表示時間
  (約 64 µs) に十分収まる。DRAM の帯域は書き込み (最大 125 MB/s) + 読み出し (約 24 MB/s) に対しピーク 667 MB/s
- **起動時:** DDR2 の初期化とキャリブレーションの後、32 MB 全体を 2 パス (アドレス由来のデータ / その反転・回転、後者は 2 回
  読む) 書いて読み比べ、フレームバッファ 2 面を黒でクリアしてから表示を始める (約 0.2 s)。それまでパネルは黒
- **読出位置の調整 (`DdrReadTune`):** PHY は 1 ビート (3 ns) を 2 回サンプルするだけで、キャリブレーション (1 パターン) は
  一致した 2 サンプルのうち前を選ぶ。実機ではその前のサンプルがデータの切り替わり際にあり、32 MB のテストで数百語化けた。
  そこで最初のメモリテストにエラーがあれば、1 スロット後ろでもう一度テストし、偶数 / 奇数ビートごとにエラーの少ない方を採る
  (同数なら他方に合わせる。どちらも同じ fclk のエッジでサンプルしているため)。結果を確かめる 3 回目のテストで終わる (計約 0.6 s)
- **LED1:** メモリテストが通ると約 1.4 Hz で点滅、メモリテストかキャリブレーションが失敗すると速い点滅
- **クロック:** PLLB の clkout3 = 333.3 MHz (fclk、CK 166.7 MHz)、CLKDIV / 4 = 83.3 MHz (mclk、コントローラと `DdrFb`)

結果 (6 枚 128x192、Ethernet 部込みの全体):

| 構成 | LUT / ALU | レジスタ | BSRAM | Fmax システム / 表示 / mclk (MHz) | リフレッシュ |
|---|---|---|---|---|---|
| ソフト版 6 枚 (BSRAM、ステータスポート込み) | 3455 / 375 | 2103 | 120 / 120 | 125.1 / 77.7 / — | 489.2 Hz |
| DDR2 版 6 枚 | 6459 / 640 | 4004 | 32 / 120 | 127.4 / 124.8 / 87.6 (mclk 83.3) | 489.0 Hz (シミュレーション) |

BSRAM は行バッファ、読み出し FIFO と映像 FIFO (各 4、どちらも 128 bit 幅で決まる)、MAC の FIFO (受信 8 + 送信 4)。
行バッファは最初レーンごとに 1 個 (12 個、1 個あたり 2304 bit しか使わない) だったが、6 bit 階調では 2 レーンを 1 個にまとめた
(書き込み 18 bit / 読み出し 36 bit の幅違い BSRAM を Gowin が RTL から推論する) ので 6 個、全体で 26 個
(この変更後: LUT 6988、レジスタ 4908、Fmax システム 125.1 / 表示 175.2 / mclk 92.1 MHz、実機でメモリテスト・表示とも OK)。
8 bit 階調は 2 画素が 48 bit で BSRAM の最大幅 36 bit を超えるのでレーンごとのまま。プレーン形式の行バッファ (DDR2 + GMT 版) は
表示側が 36 本 × 32 bit を同時に読むので、読み出し幅の点で 32 個より減らせない。フレームバッファが BSRAM から出たので、
パネルの大きさは BSRAM で決まらなくなった (行バッファは 1 レーン 1 個)。上限は 1 行の表示時間内に行を読み切ることで、
プロトコルのオフセット 16 bit (64 KB) は 2 バイト単位に広げた (16 枚の節)。LUT はコントローラ (読み出しの窓・書き込みの並べ替え) とフレームバッファの
データ路 (128 bit) の分だけ増える。最初は DDR3 版と同じ 64 スロット (8 pclk) の履歴から任意の位置を選んでいたが、DDR2 では
読み出しが固定遅延で返るので、粗い位置を RD_LAT (pclk 単位) に任せて窓を 3 pclk に縮め、コントローラの LUT を 4300 → 2200、
レジスタを 2540 → 1250 に減らした (そのときの mclk の Fmax は 84.7 → 99.6 MHz。ステータスポートを足した最終版は 87.6 MHz)。

### DDR2 版に GMT を入れた比較 (`HUB75_IMPL=ddrgmt`)

DDR2 版と同じパラメータ (6 枚 128x192、12 レーン × 64、6 bit) のまま、行フェッチで出てくる画素 (1 px / clk) を
`GmtCornerTurn` (GMT_DB 1 個) でプレーンワードに転置し、プレーン形式の行バッファ `Hub75RowPlanes` (レーン × 色ごとに
{プレーン, バッファ, x / 32} の 32 bit ワード) から出す版。最後の 32 画素分は最終画素の約 20 クロック後に GMT から
出てくるので、行の完了通知を 32 クロック遅らせている。シミュレーションは DDR2 版と同じ検査 (`+ddr_marginal` 含む) で PASS、
リフレッシュも同じ 489.0 Hz。実機は未確認。

配置配線 (同じソース、place option 2):

| | DDR2 版 (`ddr`) | DDR2 + GMT 版 (`ddrgmt`) | 差 |
|---|---|---|---|
| LUT / ALU (全体) | 7387 / 875 | 8121 / 879 | +734 LUT |
| レジスタ (全体) | 5301 | 5469 | +168 |
| CLS | 6206 (54%) | 6896 (60%) | +690 |
| BSRAM | 32 / 120 | 56 / 120 | +24 |
| GMT | 0 | 1 | |
| 出力段 (行バッファ + 表示エンジン) | `Hub75RowLanes`: REG 189、LUT 631、BSRAM 12 | `GmtCornerTurn` REG 62、LUT 15 + `Hub75RowPlanes` REG 288、LUT 1228、BSRAM 36 | |
| Fmax システム / 表示 / mclk (MHz) | 125.0 / 133.6 / 112.2 | 125.2 / 110.9 / 113.3 | 表示 −17% |

- **このパラメータでは GMT 版のほうが重い。** 転置そのもの (GMT 側) は LUT 15 個で済むが、表示側が「画素ワードから
  プレーンのビットを選ぶ 6:1 × 36 本」から「プレーンワードから x % 32 のビットを選ぶ 32:1 × 36 本」に変わり、LUT が倍になる。
  表示クロックの Fmax が下がったのも、BSRAM の出力からこの 32:1 選択までの経路が長くなったためと見ている (余裕が大きく、
  レポートの上位経路に出てこないので推定)。50 MHz の制約には十分間に合う
- **BSRAM の +24 は深さの端数。** プレーン形式の行バッファはレーン × 色で 36 個のメモリになり、どれも 24 ワード
  (6 プレーン × 2 面 × 2 ワード) しかないのに BSRAM を 1 個ずつ使う。ビット数は画素形式 (12 個) と同じ
- **転置の速さは効いていない。** 行フェッチは 1 px / clk で 1 行 768 画素を約 9 µs で書き、1 行の表示時間 (約 64 µs) より
  ずっと短い。ソフト版でも画素形式のまま行バッファに置けば転置が要らないので、GMT の 32 画素 / 18 クロックの処理能力を
  生かす場面がない。GMT が効くのは、プレーン形式でしか間に合わない構成 (階調を 8 bit 以上にして BCM のプレーン数が増える、
  チェーンを長くする、シフトクロックを上げて表示側の 32:1 ではなくワード単位の出力が必要になる、外部メモリ自体を
  プレーン形式で持つ、など)

### 行バッファなし: DDR2 にプレーン形式で置く版 (`HUB75_IMPL=ddrplane` / `ddrplanesoft`)

画素を書き込むときに転置して DDR2 にビットプレーン形式で置き、表示は走査行の 1 プレーンずつ DDR2 から取り出す版。
行バッファ (BSRAM) はなく、1 プレーン分のピンポン (2 × 2304 bit) を分散 RAM に持つだけ。

```
EthService ─ UdpVideoWriter (色テーブル) ─ GmtCornerTurn (GMT、プレーン順に B, G, R) ─ バースト ─ FbAfifo ─┐
                                                                                                  ├─ Ddr2Ctrl
   Hub75PlaneStream ◄─ プレーンバッファ (分散 RAM、レーンごと 24 bit × 16) ◄─ ニブル展開 ◄─ 読み出し FIFO ◄─┘
```

- **DDR2 の配置:** 1 バースト = ある走査行 r、レーン l、ワード w (= x / 32)、プレーン p の R / G / B 3 ワード + 空き 4 B。
  アドレス {面, r, l, w, p}。32 画素のグループを転置した 6〜8 バーストは同じページに連続して書ける (DM がないので
  ワード単位で書けず、1 / 4 は空き)。表示の 1 プレーン = 24 バースト (3 ページ)
- **表示:** `Hub75PlaneStream` は `Hub75RowLanes` のエンジンのまま、フェッチの単位を「行」から「行の 1 プレーン」に変えたもの。
  プレーン p を出している間に次のプレーンを要求し、DdrPlaneFb が 24 バーストを読んで 2 ニブル (8 画素分) ずつ書く
  (4 クロック / バースト、約 1.2 µs。プレーンのシフトは 3.84 µs。最初は 1 ニブルずつ (8 クロック / バースト) だったが、
  16 枚 (64 バースト) で間に合わないので広げた。下の表は 1 ニブル版の値)。シフトのたびに 12 bit を読み、2 bit で 1 本を選ぶだけ
- **書き込み:** 色テーブルを通した画素を GMT に入れ、列をプレーン順 (B, G, R) に読み出してバーストにする。フリップは最後の
  グループの後に「書き込みなしの印」として FIFO を通す。転置はシステムクロック (125 MHz) 側
- `ddrplanesoft` は転置を FF 配列で作る比較用 (`USE_GMT=0`)

配置配線 (6 枚 128x192、同じソース、place option 2) と DDR2 版 (画素形式の行バッファ) との比較:

| 構成 | 階調 | LUT / ALU | FF | CLS | BSRAM | SSRAM | Fmax システム / 表示 / mclk (MHz) | リフレッシュ |
|---|---|---|---|---|---|---|---|---|
| DDR2 (画素形式の行バッファ) | 6 bit | 6988 / 876 | 4908 | 5962 | 26 | 35 | 125.1 / 175.2 / 92.1 | 489.0 Hz |
| **プレーン形式・GMT** | 6 bit | 7059 / 863 | 4856 | 6152 | **19** | 107 | 125.1 / 141.3 / 113.1 | 488.3 Hz |
| プレーン形式・ソフト転置 | 6 bit | 7815 / 863 | 6040 | 7210 | 19 | 107 | 125.0 / 139.1 / 114.6 | 488.3 Hz |
| DDR2 (画素形式の行バッファ) | 8 bit | 7319 / 875 | 4958 | 6141 | 32 | | 126.1 / 116.2 / 95.8 | 432.7 Hz |
| **プレーン形式・GMT** | 8 bit | 6846 / 863 | 4862 | 5991 | **19** | 107 | 125.2 / 163.4 / 110.3 | 431.9 Hz |
| プレーン形式・ソフト転置 | 8 bit | 8228 / 865 | 6430 | 7620 | 19 | 107 | 125.1 / 150.7 / 94.5 | 431.9 Hz |

- **行バッファがなくなり BSRAM は 19 個** (MAC の FIFO 12、映像 FIFO 4、読み出し FIFO 3)。プレーンバッファは分散 RAM 72 個
  (SSRAM 35 → 107)。8 bit でも同じ (画素形式は 8 bit で行バッファが 2 レーンまとめられず 32 個に増える)
- **ロジックは画素形式とほぼ同じ (6 bit で +71 LUT、8 bit では −473 LUT)。** 書き込み側に転置とバースト組み立てが増えるが、
  表示側は「12 bit を読んで 2 bit で選ぶ」だけになり、画素形式の 6:1 / 8:1 プレーン選択と行フェッチの色テーブル (DDR2 側に
  2 系統目のテーブル読み出し) がなくなる
- **GMT とソフト転置の差は FF +1184 / +1568、LUT +756 / +1382、CLS +1058 / +1629。** ここでは転置が 125 MHz 側にあるので、
  ソフト版はシステムクロックの配置がより厳しくなる (今回は option 2 で通ったが、最初のビルドは 1 / 3 が要った)
- **DDR2 の読み出し帯域は約 36 MB/s** (24 バースト × 6 プレーン × 32 行 × 489 Hz)。画素形式の行バッファ版 (約 24 MB/s) と同程度で、
  表示のたびに読み直す方式でも帯域は問題にならない
- **実機:** 6 bit / GMT 版で、メモリテスト・テスト画像・udpvideosend (20 秒で 9714 フレーム = 約 486 fps) とも動作
  (2026-11-01)。シミュレーションは 6 枚 / 4 枚、6 / 8 bit、`+ddr_marginal` とも全画素一致で PASS

### 16 枚 (横 4 × 縦 4 = 256x256、J4〜J19)

ボードの HUB75 コネクタ 16 個すべてに 64x64 を 1 枚ずつつなぐ構成 (`PANEL_COLS=4 PANEL_ROWS=4`)。フレームバッファは
256x256 × 18 bit × 2 面 = 2.4 Mbit で BSRAM (120 × 18 Kbit = 2.1 Mbit) に入らないので、DDR2 版だけで作れる。

**見積もり (6 枚からの変化):**

- **リフレッシュ:** レーンは並列にシフトするので、チェーン長 (64) が同じなら変わらない (6 bit 488 Hz / 8 bit 432 Hz)。
  ただしプレーン形式では 1 プレーンのフェッチが 24 → 64 バーストに増える。1 ニブル / クロックの展開では 512 mclk = 6.1 µs で
  シフト時間 3.84 µs を超えるので、2 ニブル / クロック (256 mclk = 3.1 µs) にし、読み出し FIFO を 1 プレーン分 (64 バースト) に
  深くして読み出しを一気に出すようにした。画素形式の行バッファ版は 1 行 2048 画素 = 24.6 µs で 1 行の表示時間 64 µs に収まる
- **DDR2 の帯域:** プレーン形式の読み出しは 64 バースト × 6 プレーン × 32 行 × 488 Hz × 16 B = 96 MB/s (8 bit は 113 MB/s)、
  書き込みは 488 fps で 96 MB/s。合計でピーク 667 MB/s の約 3 割。画素形式は読み・書きとも約 64 MB/s
- **Ethernet:** 1 フレーム 128 パケット = ヘッダ込み約 140 KB で、GbE で 1.12 ms。パネルの 1 フレーム (2.05 ms) に収まるので、
  映像もリフレッシュと同じ約 488 fps まで出る
- **リソース:** 増えるのはレーンごとの部分 (プレーンバッファ = 分散 RAM、画素形式なら 2 レーン 1 個の BSRAM) と出力ピン
- **プロトコル:** 1 フレーム 128 KB でオフセット 16 bit (64 KB) を超えるので、64 KB を超えるフレームはオフセットを 2 バイト単位に
  した (上のプロトコルの節)
- **電源:** パネルの電流はボードの外の話だが、64x64 は全白で 1 枚数 A なので、16 枚では 5 V で数十 A になる

**結果 (配置配線、Gowin 1.9.12.03):**

| 構成 | 枚数 | 階調 | LUT / ALU | FF | CLS | BSRAM | SSRAM | I/O | Fmax システム / 表示 / mclk (MHz) | リフレッシュ (sim) |
|---|---|---|---|---|---|---|---|---|---|---|
| プレーン形式・GMT (2 ニブル展開) | 6 | 6 bit | 6841 / 863 | 4866 | 6057 | 19 | 107 | 116 | 125.2 / 152.7 / 113.8 | 488.3 Hz |
| **プレーン形式・GMT** | **16** | 6 bit | 7256 / 866 | 4938 | 6769 | **19** | 227 | 171 | 125.2 / 133.5 / 123.5 | 488.3 Hz |
| プレーン形式・GMT | 16 | 8 bit | 7277 / 866 | 4944 | 6902 | 19 | 227 | 171 | 125.0 / 145.8 / 103.9 (place 1) | 431.9 Hz |
| プレーン形式・ソフト転置 | 16 | 6 bit | 8215 / 867 | 6122 | 7950 | 19 | 227 | 171 | 125.1 / 103.5 / 104.6 (place 1) | 488.3 Hz |
| 画素形式の行バッファ (`ddr`) | 16 | 6 bit | 7510 / 875 | 5044 | 6288 | 36 | 35 | 171 | 125.5 / 119.4 / 105.5 | 489.0 Hz |

- **16 枚にしても LUT は +415、FF は +72、BSRAM は増えない (プレーン形式)。** 増えるのはプレーンバッファの分散 RAM
  (レーン 20 本分で SSRAM +120) で、ロジック全体は 42 % (9484 / 23040)。GW3A-20 にはまだ余裕がある
- 画素形式の行バッファ版は 16 枚で BSRAM 36 (行バッファ 16 個)。8 bit では 2 レーンまとめられず 52 個の見込み
- I/O は 171 / 238。J12〜J19 の一部 (R3、R5、T3、N5、P7、U5、V5、N6) は SSPI / CPU / I2C 兼用ピンで、`project.tcl` で GPIO として
  使う設定にした (設定は JTAG で書くので影響なし)
- 8 bit とソフト転置は place option 2 でシステムクロックがわずかに足りず (−0.018 ns / −34 ns)、option 1 で通った
- **シミュレーション:** 16 枚で 6 / 8 bit、GMT / ソフト転置、`+ddr_marginal`、画素形式とも全 65536 画素一致で PASS。
  既存の構成 (ソフト / GMT 4 枚 / ddr / ddrgmt / ddrplane 6 / 8 bit、Tang Primer 20K) も PASS
- **実機 (2026-11-01、パネルは 6 枚のまま):** 16 枚のビルドを書き込み、メモリテスト 0、udpvideosend 256x256 で 20 秒 9759 フレーム
  (約 488 fps、映像の取りこぼし 0)、`tools/testcards.py 256 256` も ack あり。4 × 4 の配置では J4〜J7 が上段、J8 / J9 が 2 段目の
  左 2 枚になる。パネルを J4 J5 / J8 J9 / J12 J13 につなぎ変えて 256x256 の左上 128x192 が想定どおり見えることを確認 (2 組目の
  J12 / J13 も動作)。J10 / J11 / J14〜J19 は未確認
- **デモ:** `tools/demo16.py [秒] [fps] [比較画面の秒]` は 256x256 で次の 4 画面を順に送る (既定 10 秒ずつ、比較画面は 25 秒)。
  左上 6 枚だけつないだ状態で、16 枚構成のデザインの一部を動かしていることが分かる
  1. 16 枚全面: パネル番号 1〜16、全面を横切る虹の帯とボール
  2. 左上 2 × 3 枚だけ: 128x192 のプラズマと枠、その中で跳ねるボール
  3. フレームレート: ack が返りしだい次を送り、実測 fps・フレーム番号・1 フレーム 1 マス進む印を出す。Python の送信では
     約 415〜435 fps (描画を ack 待ちの間に済ませても、ときどきパネルの 1 フレームを逃す。udpvideosend では 488 fps)
  4. GMT とソフト転置の比較: 16 枚・6 bit の LUT / FF / システムクロックの Fmax (この節の表の値)

### GMT とソフト転置の比較 (`HUB75_IMPL=ddrsoftturn`)

DDR2 + GMT 版と同じ構成で、`GmtCornerTurn` の GMT_DB だけをファブリックの同じ動作 (2 面 × 32 行 × 画素幅の FF 配列に行を
書き、列を 1 クロック遅れで読む、`USE_GMT=0`) に置き換えた版。転置器以外は同一なので、差がそのまま GMT が肩代わりしている分。
シミュレーションは表示タイミングまで GMT 版と同じで PASS。

| 階調 | 転置器 | LUT | FF | CLS | BSRAM | Fmax システム / 表示 / mclk (MHz) | システムが通った place option |
|---|---|---|---|---|---|---|---|
| 6 bit | GMT | 7987 | 5118 | 6683 | 56 | 125.2 / 109.7 / 112.2 | 2 (既定) |
| 6 bit | ソフト | 8764 (+777) | 6302 (+1184) | 7932 (+1249) | 56 | 125.2 / 97.4 / 97.8 | 1 (2 は −20 ns) |
| 8 bit | GMT | 7866 | 5126 | 6758 | 56 | 125.5 / 97.5 / 93.0 | 1 (2 は −0.03 ns) |
| 8 bit | ソフト | 8841 (+975) | 6694 (+1568) | 7900 (+1142) | 56 | 127.4 / 121.0 / 95.8 | 3 (2 / 1 は −3.2 / −0.8 ns) |

- FF の差 (+1184 / +1568) は FF 配列 (64 × 18 / 64 × 24 bit) そのもの、LUT の差は列を選ぶ 32:1 のセレクタ 32 本
- いちばん効くのは配置: CLS が約 1200 (全体の 1 割) 増え、余裕のないシステムクロック (125 MHz、Ethernet 側) が既定の
  place option では大きく外れる。転置器は mclk 側にあるが、場所を取ることで 125 MHz 側が崩れる
- ソフトの転置をメモリとして素直に書くと、Gowin は 32 行を同時に読むために同じメモリを 32 個複製して BSRAM を 32 個使う。
  FF にするには `syn_ramstyle="registers"` が要る
- 転置器 1 個 (GMT の 1 コンポーネント) でこの差なので、4 コンポーネントを全部使う規模ではファブリックの負担は約 4 倍。
  ただしこのパネル構成では、画素形式の行バッファ (DDR2 版、LUT 6988 / FF 4908 / BSRAM 26) がどちらのプレーン形式よりも小さい

### 階調 8 bit 版 (`COLOR_BITS=8`)

`COLOR_BITS` (6 / 7 / 8) で BCM のプレーン数を変える。既定は DDR2 版 (`ddr` / `ddrgmt` / `ddrsoftturn` / `ddrplane` /
`ddrplanesoft`) で 8、BSRAM 版 (soft / gmt) と Tang Primer 20K で 6 (ビルドディレクトリ名は 6 以外のとき `_c<n>`)。色テーブルの 8 bit 値の上位 `COLOR_BITS` bit を使う
(恒等テーブルは 5 / 6 bit 値のビット複製)。OE の単位 `BASE_OE_CYCLES` は 16 >> (`COLOR_BITS` − 6) にして、OE の合計
(= 明るさ) とリフレッシュをほぼ保つ (8 bit: LSB プレーンの OE は 8 表示クロック = 160 ns)。BSRAM にフレームバッファを置く
ソフト版 / GMT 版は 8 bit だと 6 枚に入らないので 4 枚 (`PANEL_ROWS=2`) で比べた (make はその組み合わせをエラーにする)。
シミュレーションは 4 方式とも全画素一致で PASS、リフレッシュは 6 bit の 489 Hz に対し 432.8 Hz (シフトのプレーン数が増える分)。
**実機 (2026-11-02):** 16 枚・プレーン形式・GMT の 8 bit (`build/dk_led_rxcard_gw3a20_ddrplane_16p_c8`) で、メモリテスト 0、
表示 OK。暗い部分の階調が 6 bit より目に見えて滑らかなので、DDR2 版の既定を 8 bit にした。udpvideosend の実測は 431.8 fps
(シミュレーションの 431.9 Hz どおり。SRAM に書き込んだ直後の 1 回目は 418.7 fps だったが、フラッシュから起動し直した後は
この値)。フラッシュへは `make TARGET=dk_led_rxcard_gw3a20 HUB75_IMPL=ddrplane PANEL_COLS=4 PANEL_ROWS=4 deploy`
(外付け SPI フラッシュ、programmer_cli の操作 9。ftdi_sio が掴んでいるときは先に外す)。ガンマは色テーブルで 8 bit の値を引く形にすると効く
(`util/hub75_games` は起動時にガンマ 1.5 のテーブルを送る)。

配置配線 (同じソース、place option 2。DDR2 + GMT の 8 bit だけ option 1 — option 2 で sys が 0.03 ns 足りなかった):

| 方式 | 枚数 | 階調 | LUT / ALU | レジスタ | BSRAM | Fmax システム / 表示 / mclk (MHz) | リフレッシュ |
|---|---|---|---|---|---|---|---|
| ソフト (BSRAM) | 4 | 6 bit | 3205 / 375 | 1996 | 84 | 128.8 / 80.3 / — | 489.2 Hz |
| ソフト (BSRAM) | 4 | 8 bit | 3164 / 375 | 2004 | 108 | 125.8 / 105.3 / — | 432.8 Hz |
| GMT (BSRAM) | 4 | 6 bit | 3822 / 379 | 2210 | 108 | 125.4 / 92.7 / — | 489.2 Hz |
| GMT (BSRAM) | 4 | 8 bit | 3836 / 379 | 2218 | 108 | 125.9 / 91.9 / — | 432.8 Hz |
| DDR2 | 6 | 6 bit | 7172 / 875 | 4950 | 32 | 125.2 / 123.2 / 107.6 | 489.0 Hz |
| DDR2 | 6 | 8 bit | 7319 / 875 | 4958 | 32 | 126.1 / 116.2 / 95.8 | 432.7 Hz |
| DDR2 + GMT | 6 | 6 bit | 7987 / 879 | 5118 | 56 | 125.2 / 109.7 / 112.2 | 489.0 Hz |
| DDR2 + GMT | 6 | 8 bit | 7866 / 879 | 5126 | 56 | 125.5 / 97.5 / 93.0 | 432.7 Hz |

(6 bit の数字は、48 バイトのステータスを `hdr` に積まず送信時に `i_status` から直接出すように直した後のもので、上の表より
少し小さい。この変更でシステムクロックの違反がなくなった)

- **ロジックはどの方式もほぼ変わらない (±150 LUT 程度、配置ごとの揺れと同じ大きさ)。** 階調はデータ幅 (18 → 24 bit) と
  BCM のプレーン数に効くだけで、制御は同じ。GMT の転置も 24 列 (8 プレーン × 3 色) になるだけで GMT 1 個に収まる
- **BSRAM が増えるのはソフト版 (BSRAM) だけ (84 → 108)。** 画素ワードが 18 → 24 bit になり、レーンごとのメモリの幅が
  増えるため。GMT 版 (BSRAM) はプレーンメモリが 6 プレーン × 256 ワード = 1536 → 8 × 256 = 2048 ワードになるが、もともと
  2048 ワード (BSRAM 4 個) に切り上げられていたので増えない (= 端数がちょうど埋まった)。DDR2 の 2 方式は行バッファが小さく
  (画素形式 128 × 24 bit、プレーン形式 32 ワード)、どちらも 1 メモリ 1 BSRAM のまま
- **6 枚で 8 bit を出せるのは DDR2 の 2 方式だけ。** BSRAM の方式は 6 枚 6 bit でもう満杯 (ソフト 120 / 120、GMT は入らない)
- **Fmax は配置の揺れが大きく、8 bit で必ず下がるわけではない。** どれも制約 (システム 125、表示 50、mclk 83.3 MHz) を満たす。
  mclk は 8 bit で 96〜93 MHz に下がった (行フェッチの色テーブルが 8 bit 出力になる分) が、まだ 10% 以上の余裕がある
- **このボードの構成では 8 bit でも GMT の利点は出ない。** GMT が効くには、表示側の 32:1 の選択がボトルネックになる
  (シフトクロックを上げる) か、外部メモリ側の帯域が足りなくなる構成が要る

### 音声出力 (I2S、`AUDIO=1`、既定)

UDP で送った音声を、J19 (16 番目の HUB75 コネクタ) のピンから I2S で出す。M5Stack Atom SPK Base (NS4168、I2S 入力の
モノラル D 級アンプ) をつなぐ想定。このボードには汎用の拡張ヘッダがなく (MCU との SPI 4 本は基板内で MCU に直結)、
HUB75 コネクタの R1〜B2 はコネクタごとの専用ピンなので、J19 の 3 本を使う。J19 にはパネルを出さなくなる
(16 枚構成の右下 1 枚。`AUDIO=0` で元どおり、ビルドディレクトリに `_noaud`)。

| J19 のピン | 元の信号 | FPGA | I2S | Atom SPK Base (回路図の番号) |
|---|---|---|---|---|
| 1 | R1 | U16 | BCLK (1.536 MHz) | P3/P4 の 2 番 (P1 の 2 番) |
| 2 | G1 | V16 | LRCK (48 kHz) | P3/P4 の 3 番 (P2 の 1 番) |
| 3 | B1 | U15 | DATA | P3/P4 の 1 番 (P2 の 2 番) |
| 4 | GND | — | GND | P2 の 4 番 |
| J23 の 1 番 | 3.3 V | — | 電源 | P3/P4 の 4 番 (+3.3V) |
| J23 の 9 番 | GND | — | GND | P2 の 4 番 |

- Atom SPK Base にはレギュレータがなく、NS4168 の VDD と CTRL は +3.3V (普段は Atom 本体から来る)。5 V (P2 の 3 番) は
  Base 上ではどこにもつながっていないので不要。3.3 V はボードの J23 (MCU の AT-LINK) の 1 番から取る
- 信号は 74HC245 を通る。74HC245 の電源 (= High レベル) は資料にないので、つなぐ前に J19 の 1 番の High を測ること
  (3.3 V なら直結、5 V なら分圧。NS4168 は 3.3 V 動作)
- **実機 (2026-11-02):** 直結では鳴るが正弦波がノイジーで、J19 と Base の間にレベル変換 (3.3 V 側へ) を入れたら
  きれいになった (NS4168 の入力の絶対最大定格は VDD = 3.3 V。J19 の 74HC245 は 5 V 振幅と見てよい)。I2S の形式は
  NS4168 のデータシートどおり (標準 I2S、LRCK 0 が左、BCLK 立ち上がりで取り込み、CTRL = 3.3 V なので右チャンネルを鳴らす)。
  上の配線で音階と 440 Hz が鳴った。振幅によらず同じ音量で鳴る症状は配線 (信号の入れ替わり) が原因だった。
  2026-11-03 にこの音声付きビルド (16 枚、8 bit、J19 は音声) をフラッシュに書き込み、フラッシュからの起動で表示と音声を確認。
  切り分けは、無音で DATA が 0 V、値 -1 を送り続けると DATA だけ 3.3 V (BCLK / LRCK は約 1.6 V) になるのをテスターで見る。滝のデモ (60 fps) と同時に送っても映像・音声とも落ちず、
  返事のバッファ量は平均 1908/2048、送信ペースは 48 kHz
- **プロトコル (Chisel 版と互換):** UDP 宛先ポート 10002、ペイロード = 16 bit ステレオ (リトルエンディアン、左が先)、48 kHz。
  受信側は送信元を覚え、パケットごとと再生 256 フレームごとに 5 バイト {5, バッファ量 (2 バイト), 最大 2048 (2 バイト)}
  (ビッグエンディアン) を返す。`util/udpaudiosend` はこれを見て、空きがあるときだけ送る
- **FPGA 側 (`AudioI2s`、システムクロック 125 MHz):** 2048 フレームの FIFO (BSRAM 4)、1024 フレームたまったら再生開始、
  空になったら無音にして再びためる。満杯のときに来たフレームは捨てる。BCLK = 32 fs は 125 MHz の位相アキュムレータで作る
  (分周比 81.4 の端数は 8 ns の揺れになるだけで、平均は 48 kHz ちょうど。NS4168 は MCLK 不要で BCLK に同期する)。
  I2S (Philips 形式、LRCK Low が左、MSB は LRCK の変化の 1 BCLK 後、16 bit スロット (ESP32 が Atom SPK に送るのと同じ。LSB は LRCK の変化と同時))。NS4168 は片側の
  スロットしか鳴らさないので、両スロットに (L + R) / 2 を出す
- **送り方:** `ffmpeg -i <音声ファイル> -f s16le -ar 48000 -ac 2 - | util/udpaudiosend/target/release/udpaudiosend`、
  試験音は `udpaudiosend --frequency 440` (のこぎり波)。`util/play_video.sh` も 48 kHz ステレオに変換して送るようにした
- **シミュレーション:** `make -C test rxcard IMPL=ddrplane CBITS=8 AUD=1` は、音声パケット 6 個 (1536 フレーム、乱数) を
  送って返事の中身 (長さ、ポート、バッファ量、最大値) を照合し、J19 の I2S を受ける模型で全フレームが順番どおり
  ((L + R) / 2) 出ることと、再生中の定期報告を確かめる

### DDR2 版の実機の結果 (2026-11-01)

- DDR2 の初期化・キャリブレーション成功 (RD_LAT 11、RD_SEL 0 / 奇数 2)。ところが最初のメモリテストで数百〜千語の
  エラーが出た。パス 0 は 0、パス 1 と同じデータの読み直し (パス 2) で件数が変わる (515 / 413) ので読出側、化けるのは
  ほぼ奇数ビートの 1 拍目 (beat 1) で、残りは beat 3 / 7 の DQ0
- `ddr2sweep.py` (RD_LAT 10〜12 × RD_SEL 0〜9) でエラー 0 になったのは RD_LAT 11 / RD_SEL 1 (奇数 3) だけ。RD_SEL 0 は
  境界 (3 パスで約 1400 語)、それ以外は全滅。1 ビートの 2 サンプルのうち後ろが目の中、前がデータの切り替わり際
- キャリブレーション値 (0 / 2) のまま 20 回テストすると、奇数を 3 に直しても偶数 (beat 0 の DQ0) が 13 語化けた。
  1 / 3 では 20 回 (約 1.3 億語) で 0
- 読出位置の調整を入れた版: 起動時に 1 回目 1088 語 → 1 / 3 に移動 → 確認テスト 0。その後さらに 20 回でエラー 0
- 表示: `testcards.py` (パネル番号・カラーバー・格子・ボール) と udpvideosend のテストパターンがソフト版と同じに出る。
  udpvideosend は 10 秒で 4888 フレーム (488.8 fps = パネルのリフレッシュ)。約 3 分流し続けて映像ワードの取りこぼし 0
- 配置配線 (最終版): LUT / ALU 7387 / 875、レジスタ 5301、BSRAM 32 / 120、Fmax システム 125.0 / 表示 133.6 / mclk 112.2 MHz
  (診断ポートと読出調整の分だけ上の表より増えた。メモリテストの比較は 2 段にパイプライン化)

### シミュレーション (Arora III)

`make -C test rxcard IMPL=soft|gmt` (`test/tb_rxcard.sv`): GW3A のプリミティブ (PLLB、IDDR / ODDR、IODELAY) と `GMT_DB` は
`test/gw3a_sim.sv` の振る舞いモデル (`GMT_DB` は Gowin がモデルを出していないので UG311 の記述から書いた)。
RTL8211E 役の MDIO スレーブ (アドレス 1) と、RGMII の向こう側のホスト (PHY の遅延込みのタイミング) をつなぎ、

1. MDIO: PHY が 1 個見つかり、拡張ページ 0xa4 / 0x1c が bit 13:11 = 111 (他のビットは保持)、ページが 0 に戻り、BMCR が 1 回書かれること
2. 1000M (RXC 125 MHz) で Tang Primer 20K と同じ 1〜6 (ARP、ICMP 64 / 1000 B、FCS 不良、映像 2 フレームの全画素照合、色テーブル、ARP)。
   映像はフレーム間 12 バイトの詰めた送り方 (ワイヤレート)
3. RXC を 25 MHz にして速度判定が 100M に切り替わり、ARP と ICMP がニブル形式で通ること

`TXS=1` は `TXC_SHIFTED=1` のトップに対して、PHY 役が TX 遅延なし (TXC のエッジで TXD を取る) で同じ検査をする。

`IMPL=ddr` は DDR2 の PHY を `test/ddr2_phy_sim.sv` (`rtl/ddr2/test/ddr2_model.sv` をスロットベクタに直接つないだもの) に
置き換え、電源投入の待ちを 20 µs、起動時のメモリテストを 4096 バーストに縮めて同じ検査をする。メモリテストとクリアの完了、
キャリブレーション成功、最初のフレームまでパネルが黒であることも確かめる。どの構成でもステータスポート (10006) の返信を検査し、
DDR2 版では制御ポート (10007) で読出位置を上書きしてメモリテストを再実行する。`MARG=1` (`+ddr_marginal`) はモデルが各ビートの
前のサンプルをときどき化けさせ (実機と同じ状況)、読出位置の調整が後ろのサンプルに移ることを確かめる。

ソフト版・GMT 版 (それぞれ 6 枚 / 4 枚)・TXS=1 (ソフト版)・DDR2 版 (6 枚 / 4 枚) とも PASS (6 枚は 128x192 = 24576 画素、48 パケット)。GMT 版では最初、GMT 側の保留が解けてから `Hub75Planes` が busy を出すまでの 1 クロックに busy が
落ち、ack が 2 回出ていた (検査で見つかり修正済み)。

### 実機の結果 (Arora III、2026-10-31)

ソフト版、64x64 ×6 枚 (J4〜J9) と上 4 枚 (`PANEL_ROWS=2`):

- リンク 1000M 全二重。既定の `PHY_DLY=on` (RTL8211E の RX / TX 遅延を MDIO で強制オン) のまま ping・ARP が通った
  (RTT 0.17 ms)。`TXC_SHIFTED` / `RX_DELAY` の切り分けビルドは不要だった
- udpvideosend のテストパターン: 4 枚 (128x128、32 パケット)、6 枚 (128x192、48 パケット) とも 489 fps で、パネルの
  リフレッシュ (489.2 Hz) と一致 (毎フレーム ack が返り、パネルのフレーム境界で切り替わっている)
- `tools/testcards.py` (パネル番号・矢印、カラーバーと 32 段グレー、8 px 格子とパネル境界、跳ねるボール) で、並び・向き・
  色の順・パネル間の位置ずれがないことを確認。ボールは送信側 (Python で描画) の速さで約 162 fps
- 右列が映らなかった最初の不具合はケーブルのつなぎ間違いだった。切り分けに使った `CONN_ID=1` のビルドは、J4〜J11 に
  コネクタごとの単色 (J4 赤、J5 緑、J6 青、J7 黄、J8 シアン、J9 マゼンタ、J10 白、J11 上赤 / 下青) を出す
- 書き込み: ボードの USB-JTAG は FT232H (0403:6014)。Linux の `ftdi_sio` が掴んでいると `programmer_cli` が
  `Cable failed to open via the channel` で失敗する。`sudo modprobe -r ftdi_sio` (make run が実行) で外すか、
  `openFPGALoader -c ft232 --detect` を一度実行すると (GW3A は未対応でエラーになるが) その際にドライバが外れて書き込めるようになる。
  充電専用の USB ケーブルでは FT232H 自体が見えない

### 実機の確認手順 (Arora III)

1. パネル: 64x64 を J4〜J9 に 1 枚ずつ、上段 J4 (左) / J5 (右)、中段 J6 / J7、下段 J8 / J9。4 枚だけなら J4〜J7 で
   `PANEL_ROWS=2` のビルドを使う
2. ボードの Type-C (J20) を PC に。`make TARGET=dk_led_rxcard_gw3a20 run` (4 枚は `PANEL_ROWS=2`、GMT 版は 4 枚のみで
   `HUB75_IMPL=gmt PANEL_ROWS=2`) で SRAM に書き込む。
   `programmer_cli` が FT232 を掴めないときは `ftdi_sio` を外す (make run が自動で外す)。ケーブルの指定が要るときは
   `PROGRAMMER_CABLE=...` (`make scan-cables` で確認)
3. LED1 が約 1.4 Hz で点滅すること (PLL ロックとパネル走査)。パネルは起動直後は黒 (フレームバッファの初期値)
4. LED2 が速く点滅し続ける場合は MDIO で PHY が見つかっていない (遅延設定が入っていない)。その場合は知らせてほしい
5. PC の有線 LAN を 192.168.10.1/24 にして、どちらかの RJ45 とつなぐ。リンク LED が点かない / ping が通らなければ反対側の
   RJ45 に差し替える (U43 がどちらか資料にない)。`ping 192.168.10.2` が返り、`ip neigh` に 11:22:33:44:55:66 が載ること。
   `ethtool <if>` でリンク速度 (1000Mb/s が期待値) も見てほしい
6. テストパターン / 動画 / 向き / ガンマは Tang Primer 20K の 4〜7 と同じだが、6 枚では画面サイズを 128x192 にする:
   `cargo run --release -- --width 128 --height 192 --test-pattern`、動画は `VIDEO_WIDTH=128 VIDEO_HEIGHT=192 VIDEO_FILE=... ./play_video.sh`
   (4 枚は 128x128 のまま)。静止画のテストは `tools/testcards.py [幅] [高さ] [秒] [周回]` (既定 128 192 8 秒)。各パネルの左右が逆なら `CHAIN_REVERSE`、パネルの位置が入れ替わっていればつなぎ先を知らせてほしい。
   GbE では udpvideosend の fps が Tang Primer 20K より上がるはず (上限はパネルのフレーム境界での切り替え待ち)
7. 4 枚構成で、ソフト版と GMT 版の表示が同じであること
8. DDR2 版: 次の節
9. ping が通らない場合は、RGMII のタイミングを変えたビルドを順に試す (make 変数、既定以外の値はビルドディレクトリ名に付く)。
   各ビルドで ping と `ethtool -S <if>` の受信エラー (rx_crc_errors など)、`ip -s link` の RX/TX カウンタを見てほしい

   | 変数 | 値 | 意味 |
   |---|---|---|
   | `PHY_DLY` | `on` (既定) | PHY の RX / TX 遅延を MDIO で強制オン (拡張ページ 0xa4 レジスタ 0x1c bit 13:11 = 111) |
   | | `strap` | 強制を外し、ボードのストラップ抵抗の設定に任せる (bit 13 = 0) |
   | | `off` | RX / TX 遅延を強制オフ (FPGA 側の受信はこれに対応していないので切り分け用) |
   | | 4 桁の 16 進 | bit 13:11 を直接指定。`3000` / `2800` はどちらか片方の遅延だけオン (どちらが RX かはドライバの記述が食い違う) |
   | `TXC_SHIFTED` | `1` | TXD / TX_CTL を PLL の 270° 出力の ODDR から出し、TXC がデータより 2 ns 遅れる形にする (GW3A のファブリックには立ち下がりの FF がないので TXC 側は動かさない)。PHY の TX 遅延がオフのときに使う |
   | `RX_DELAY` | 0〜255 | 受信の RXD / RX_CTL に IODELAY (1 段 12.5 ps) を入れる。PHY の RX 遅延がオンで微調整したいとき |

   試す順番の目安:
   1. `make TARGET=dk_led_rxcard_gw3a20 PHY_DLY=strap run` (MDIO の書き込み自体が悪さをしている場合)
   2. `make TARGET=dk_led_rxcard_gw3a20 PHY_DLY=3000 TXC_SHIFTED=1 run`
   3. `make TARGET=dk_led_rxcard_gw3a20 PHY_DLY=2800 TXC_SHIFTED=1 run`
      (2 と 3 は「RX 遅延だけ PHY、TX は FPGA 側でずらす」の 2 通りの解釈)
   4. ping の応答はあるが取りこぼす / 受信エラーが出る場合は `RX_DELAY=40` (0.5 ns)、`RX_DELAY=80` (1 ns) を足す

### DDR2 版の実機確認手順

1. パネルとケーブルはソフト版と同じ (6 枚)。`make TARGET=dk_led_rxcard_gw3a20 HUB75_IMPL=ddr run`
   (4 枚は `PANEL_ROWS=2` も付ける)。ビルドは `build/dk_led_rxcard_gw3a20_ddr`
2. 書き込み後 0.2 s ほどで LED1 が約 1.4 Hz の点滅になれば、DDR2 の初期化・キャリブレーション・32 MB のメモリテストが通っている。
   速い点滅はメモリテストかキャリブレーションの失敗、消えたままは初期化が終わっていない
3. `python3 tools/fbstat.py` で状態を読む (返ってこなければ ping から)。`calibrated yes`、`memory test errors 0` (調整後の
   最終テスト)、`memory test runs` (調整が働くと 3)。読出の目を測るときは `python3 tools/ddr2sweep.py 10 12`
4. パネルは起動直後は黒。`tools/testcards.py` と udpvideosend のテストパターン (`--width 128 --height 192`) がソフト版と同じに
   見えること、udpvideosend が 489 fps 前後で回ること
5. しばらく (数分) 動画かボールを流し続けて、表示の乱れ (ノイズ・ずれ) がないこと。その後もう一度 `fbstat.py` で
   `video words lost` が 0 のままか見る
