ciniml/fpga_samples/eda/dvi_loopback/README.md

# dvi_loopback — Tang Primer 25K DVI 1080p60 TX→RX ループバック

1 枚の Tang Primer 25K で DVI を送受信し、1920x1080p60 (ピクセルクロック 148.5MHz、
1.485Gbps/レーン) で `rtl/dvi_in` がビットパーフェクトに受けられるかを確かめる。

## 接続

Pmod を 2 枚使い、HDMI ケーブルでつなぐ。スロット名は `eda/targets/tangprimer25k/pmod_ports.csv` の番号
(ボードのシルクと食い違うことがあるので、FPGA ピン名で確認する)。

| 役割 | スロット | ピン (P 側、N は +6) | 備考 |
|---|---|---|---|
| RX | pmod0 | CLK=H5, D0=H8, D1=G7, D2=F5 | LVDS25 + 内蔵 100Ω 終端 (バンク 1) + CTLE。**FPGA 側にバイアス抵抗のある Pmod DVI** を挿す |
| TX (`TX_SLOT=PMOD1`、動作確認済み) | pmod1 | CLK=L5, D0=K11, D1=E11, D2=A11 | ELVDS_OBUF、LVPECL33E DRIVE=16。送信専用の Pmod HDMI (バイアス抵抗なし) で可 |
| TX (既定) | pmod2 | CLK=C11, D0=B11, D1=D11, D2=G11 | 同上 |
| dbg | TX に使っていない方 (pmod1 / pmod2) | pin1〜4 | [0] 不一致フレーム (約 110us パルス), [1] デコードエラー, [2] RX DE, [3] RX VSYNC |

送信専用の Pmod HDMI (バイアス抵抗なし) を RX 側に使うと、720p でもレーン 1/2 で孤立ビットが落ちる。

- LED: B2 = ワードロック、C2 = 直近約 0.1 秒に不一致フレームかデコードエラーあり
- UART: USB Debugger (FT2232 if01)、115200 8N1
- TX と RX は別の HCLK グループ (バンク 6/7 とバンク 1) なので、FCLK はそれぞれ独立

## 構成

```
50MHz ─ pll_27 ─ 27MHz ─ pll_tx_1080p ─ 148.5 / 742.5MHz
          loop_pattern → dvi_out → OSER10 x4 → ELVDS_OBUF → PMOD2 ──HDMI──┐
                 └ frame_sum (TX 基準)                                     │
PMOD0 → TLVDS_IBUF ─ CLK → pll_rx_1080p (148.5 → 148.5 / 742.5MHz)  ←──────┘
                    └ D0-2 → dvi_in_phy (IODELAY + IDES10 + dvi_in, dvi_capture と共用)
                                 → loop_check (frame_sum を TX 基準と比較、カウンタ)
                                 → loop_report (UART、50MHz ドメイン)
```

- PLL: DS1103 Table 3-36 の制約 (PFD ≤ 87.5MHz、VCO 700〜1400MHz) により、
  TX は 27MHz × 27.5 (分数 MDIV)、RX はケーブルクロック ÷2 × 10 で、どちらも VCO = 742.5MHz、ODIV1 = 1
- パターン (`loop_pattern.sv`) は座標だけで決まる静的画像。3 チャネルがすべてのバイト値を
  別々の並びで通るので、TMDS データシンボルと DC バランスの両分岐を使い、R/G を入れ替えると和が変わる
- `frame_sum`: 1 フレームのアクティブ画素について s1 += 画素、s2 += s1 と画素数を計算する。
  RX はフレームごとに TX の値と比べる。CRC32 は 148.5MHz で閉じなかったので加算型にした

## 実機結果 (2026-09-26、`TX_SLOT=PMOD1`)

| 構成 | 結果 |
|---|---|
| `RATE=720P CTLE=OFF` | ビットパーフェクト (B=0、E=0、N=000E1000) |
| 1080p `CTLE=HIGH`、共通オフセットのみ | 画素 BER 1.4e-4 (O=28)。データのアイは 1〜3 タップ幅 |
| 1080p `CTLE=HIGH`、O=5C + レーン別トリム (B 0 / G 0 / R −7) | 30 秒 (1740 フレーム) で B = 5.8e-8、G = 4.5e-6、R = 2.8e-5、ロック喪失 0。まだ全フレームに誤りがある |
| 1080p `RX_TERM=OFF` (CTLE HIGH / MEDIUM) | レーン 0 の窓がどの位相にもない (内蔵終端は必要) |
| 1080p `CTLE_D2=MEDIUM` | R の最小 3.0e-5、窓 6 タップ (HIGH は 2.7e-5、9 タップ)。改善なし |
| 1080p `CTLE=MEDIUM` / `LOW` / `OFF` | どの位相でもほぼ全画素が不一致 |
| 1080p TX `LVCMOS33D_16` / `LVPECL33E_8` | 最良 8.8e-4 / 全滅 |

- アイの周期は約 0x34 タップ (= 1 UI)。良い位相は O = 28, 5C, F8 付近
- レーンごとに最適位相が違う (R だけ −7 タップずれる)。R のアイが最も小さく、全体の BER を決めている
- `dvi_in` は同期シンボルを「前後どちらかの隣接ワードと一致したとき」だけ採用する。
  CTRL_01 と CTRL_11 は bit 9 だけが違うので、1 ビットの誤りで偽の VSYNC が出て 1 フレーム丸ごと
  ずれていた (3 レーン同時に約 200 万画素の誤りとして見えた)
- デコードエラー (E) はブランキング (0101 交番) しか見ておらず、データのアイより広く見える。
  評価は画素 BER (X / Y / Z) で行う。CTLE=HIGH が最良なのも画素 BER での判断
- 真の LVDS 出力 (`TLVDS_OBUF` / LVDS25) は Pmod 経由ではロックしなかった (振幅不足)
- TX の LVCMOS33D DRIVE=8 は 1.485Gbps で孤立ビットが落ちる。LVPECL33E DRIVE=16 と RX CTLE=HIGH は
  `eda/easycdr_bert` の 1.4875Gbps 測定の結果に合わせた

## 変種

| 変数 | 値 | 内容 |
|---|---|---|
| `RATE` | `720P` | 1280x720p60 (74.25MHz / 742.5Mbps)。ループバック自体の確認用 |
| `TX_SLOT` | `PMOD1` | TX を pmod1 に置き、dbg を pmod2 に移す |
| `CTLE` | `OFF` / `LOW` / `MEDIUM` / `HIGH` (既定) | RX イコライザ |
| `TX_IO` | `<IO_TYPE>_<DRIVE>` (既定 `LVPECL33E_16`) | TX パッド |
| `TX_CLK` | `ODDR` | クロックレーンを OSER10 でなく ODDR (ピクセルクロック) で出す |
| `RX_TERM` | `OFF` | RX の内蔵 100Ω 差動終端を外す |
| `CTLE_CLK` / `CTLE_D0` / `CTLE_D1` / `CTLE_D2` | `OFF` / `LOW` / `MEDIUM` / `HIGH` | ペア単位で CTLE を上書きする |

ビルドディレクトリは `build/tangprimer25k_<変種>` に分かれる。

## ビルド・書込み

```sh
DISPLAY= QT_QPA_PLATFORM=offscreen make GW_SH=~/gowin/1.9.12/IDE/bin/gw_sh
make run OPENFPGA_LOADER_DEVICE_OVERRIDE="--busdev-num <bus:dev>"
make sim    # 論理ループバックのシミュレーション (Verilator、PHY はモデル化しない)
```

`rtl/dvi_in` と `rtl/dvi_out` の Veryl は Makefile が必要に応じて `veryl build` する。
合成結果 (Gowin 1.9.12): tx_pclk 180.6MHz、rx_pclk 179.8MHz (制約 148.5MHz)、LUT 10%。

## UART

1 秒ごとに累積カウンタを出す。

```
R L1 F00000E10 B00000000 E00000000 E0000000 E1000000 E2000000 U0001 N001FA400 O20 P1 C8D2F3A10
```

| 欄 | 意味 |
|---|---|
| L | ワードロック (1/0)。RX クロックが無い (スナップショットに応答しない) ときは X |
| F / B | TX と比較したフレーム数 / うち不一致 |
| E | デコードエラーのあったクロック数 |
| U | ワードロック喪失の回数 |
| N | 最後に比較したフレームのアクティブ画素数 (1080p は 001FA400 = 2073600) |
| O | IODELAY オフセット (DLYSTEP = 24 + O) |
| E0 / E1 / E2 | レーン別のデコードエラー (下位 24 bit) |
| X / Y | パターンと違った画素数 / 誤りビット数。BER = Y / (F × N × 24) |
| Z0 / Z1 / Z2 | レーン別の誤りビット数 (0 = B、1 = G、2 = R)。レーン BER = Zn / (F × N × 8) |
| K / T | レーン別トリム (レーン 0, 1, 2 の順に 1 バイトずつ) / 調整対象 (a = 共通、0〜2 = レーン) |
| P / C | RX 復元 PLL のロック / RX クロックの累積サイクル数 (行ごとの差分が周波数) |

R 行の全体:

```
R L1 F… B… E… E0… E1… E2… U… N… O… P… C… X… Y… Z0… Z1… Z2… K… T…
```

合わせ込みの手順: 共通オフセットを `s` で粗く見て、レーン 0 (B) の誤りが最小の点に置く
→ `2` `s`、`2` `f` でレーン 2 のトリムを詰める → レーン 1 も同様。

コマンドは受信 FIFO (16 文字) に入り、行の送信中に届いたものも失われない。
コマンド (1 文字): `a` / `0` / `1` / `2` で調整対象を選ぶ (共通オフセット / レーン別トリム)。
`+` / `-` で対象 ±4、`>` / `<` で ±1、`d` でオフセットを既定値 (0x20) にしトリムを 0 に戻す、
`c` でカウンタクリア、`s` で対象の粗いスキャン (0x00〜0xFC、4 刻み)、`f` で対象 −16〜+15 の 1 刻みスキャン、生ワード (3 レーン × 12 個、16 進、bit 0 = 最初に届いたビット) は `w` がレーン 0 のコントロールシンボルから、
`v` がランの開始 (コントロール → データ) の 6 ワード前から、`x` がレーン 0 はコントロールなのにレーン 1/2 が
そうでないワードの 6 ワード前から、`e` が dvi_in のレーン 1/2 デコードエラーの周辺。
`G<mask><512 桁の 16 進>` / `i` は色テーブルの更新 / 恒等化 (eda/dvi_hub75 用、他では何もしない)。
ホスト側スクリプトは `host/loopctl.py` (`status` / `scan` / `fine` / `words` / `send`)。
スキャンは O = 00, 04, … FC の各点で 60ms 待ってから
250ms (約 15 フレーム) 計測し、差分を `S` 行で出す。終わるとオフセットを元に戻す。

1.485Gbps の 1UI は約 48 タップ (約 14ps/タップ)。720p で求めた既定値 0x20 (実効 56) が
そのまま使えるとは限らないので、最初にスキャンしてアイの位置を確かめる。GW5A の IODELAY は
遅延を大きくするほど付加ジッタで悪化したので (dvi_capture での知見)、クリーンな区間が
複数あるときは最も小さい値を選ぶ。

## 判定の目安

- `N001FA400` かつ `B` が増えない: 画素・DE・レーン順すべて一致
- `F` が増えない: ロックはしているのに VSYNC が取れていない (レーン 0 と 2 の取り違えなど)
- `B` が毎フレーム増える: 系統的なずれ (R/G の取り違え、ビット順など)
- `E` だけが増える: ブランキング中のシンボル誤り (720p では無終端バンクの ISI がこの形で出た)
