ciniml/fpga_samples/eda/easycdr_bert/README.md

# EasyCDR BERT (Tang Primer 25K)

ExtEasyCDR モジュール + USB-C ケーブルの 1Gbps リンク用ビット誤り率テスタ。
`rtl/bert` のコアを EasyCDR IP (生データ 16bit) と OSER8 に接続し、
ブラウザ (`host/bert.html`, Web Serial/WebUSB) から制御・表示する。

| 項目 | 内容 |
|---|---|
| TX | PrbsGen 8bit @125MHz → 非同期 FIFO → OSER8 (専用 PLL 500MHz, BANK1) → G7/G8 (pmod0 L1) |
| RX | G11/G10 (pmod2 L0) → **自前 CDR** (`oscdr_phy_gw5a.v`: TLVDS_IBUF → OSIDES32 (DELAY 0/21 **静的**、DYN_DLY_EN=FALSE 必須、DHCE ゲート) → `rtl/oscdr` OsCdr → ギアボックス) → PrbsChk。`USE_EASYCDR_IP=1 make -B synthesis` で純正 IP 版 (どちらも RX bit-reverse OFF) |
| アイスキャン | EXT_CTRL0 (0x30): bit0 = RX 位相凍結, bit1 = TX PLL PSDIR, bit2 = PSPULSE (125ps/パルス)。`host/eyescan.py` またはブラウザの Eye scan |
| ホスト | UART C3/B3 115200 → BertHost。ブラウザ UI は 1 秒毎に SNAP → 24 バイト読出し |
| 観測ピン | B2 = PRBS ロック、C2 = 誤りパルス (~8ms 引き伸ばし)、E1 = RX 活性 |

## 2 ボード構成 (Tang Nano 9K 送信源、別水晶)

`TARGET=tangnano9k_pmod` は PRBS7 を 999Mbps (27MHz 水晶 → rPLL 499.5MHz) で pmod0 L1 (26/25) に
送る TX 専用ビットストリーム (S2 で 1 ビット誤り注入、S1 でリセット)。モジュールを Nano9K pmod0 と
25K pmod2 に挿して USB-C で結ぶと、25K の自前 CDR が −1000 ppm のプレシオクロナス受信を行う
(約 4 スリップ / 1000 UI)。25K 側の TX (pmod0) は使わない。

## 使い方

```sh
cd rtl/bert && veryl build                 # 生成 .sv を合成が参照
cd eda/easycdr_bert
DISPLAY= QT_QPA_PLATFORM=offscreen make synthesis GW_SH=~/gowin/1.9.12/IDE/bin/gw_sh
make run [OPENFPGA_LOADER_DEVICE_OVERRIDE="--busdev-num <bus:dev>"]
```

### レート変種 (純正 IP 版のみ、`build/tangprimer25k_ip_<rate>/`)

GW5A-25 の GPIO 受信経路 (IDES 上限 1600Mbps、DS1103 Table 3-31) がどこまで持つかを BER で測る変種。
`make USE_EASYCDR_IP=1 RATE=<rate>`。RX 4 相 PLL と TX PLL (OSER8 FCLK) を同じ MDIV/ODIV で組み、
IP の `DELAY_1` (UI/4 のタップ数、12.5ps/段) と SDC を project.tcl のテーブルから生成する。

| RATE | 線速 | FCLK / pclk | PLL (50MHz 入力) | DELAY_1 |
|---|---|---|---|---|
| (既定) | 1.0 Gbps | 500 / 125 MHz | VCO 1000 (MDIV 20), ODIV 2 | 21 |
| `1200M` | 1.2 Gbps | 600 / 150 | VCO 1200 (MDIV 24), ODIV 2 | 18 |
| `1400M` | 1.4 Gbps | 700 / 175 | VCO 1400 (MDIV 28), ODIV 2 | 15 |
| `1487M5` | 1.4875 Gbps (1080p60 の 1.485 に +0.17%) | 743.75 / 185.9 | VCO 743.75 (MDIV 14 + 7/8), ODIV 1 | 14 |
| `1600M` | 1.6 Gbps (IDES の仕様上限、DP RBR 1.62 の −1%) | 800 / 200 | VCO 800 (MDIV 16), ODIV 1 | 13 |

- 4 相の 90° は PLLA の PE_FINE (VCO 周期 / 8) で ODIV 2 なら 4 ステップ、ODIV 1 なら 2 ステップ (ラッパで自動計算)
- **実機 BER (2026-09-26、25K 自己ループ pmod0→pmod2、USB-C ケーブル、`host/ber_run.py --dwell 30 --prbs 4`)**:

  | RATE | PRBS31 30 s | PRBS7 10 s | 備考 |
  |---|---|---|---|
  | 1G (IP) | 3.0e10 bit、誤り 0、アンロック 0 | — | 自前 CDR 版も誤り 0 |
  | 1200M | BER 1.5e-8 (誤り 526、アンロック 25) | 誤り 0 | 10 s ×2 でも 1.2e-8 / 9.4e-9 と再現 |
  | 1400M | BER 1.0e-2、アンロック 1.4e7 | BER 1.7e-2 | 実質リンク不成立 |
  | 1487M5 | BER 4.6e-2、ロックせず | — | |
  | 1600M | ロックせず (bit 計数ほぼ 0) | — | |

  追加 (同日): `RATE=1300M` (VCO 1300、DELAY_1 16) は PRBS7 1.3e-5 / PRBS31 1.4e-4。
  **DELAY_1 掃引** (`make USE_EASYCDR_IP=1 RATE=... DELAY1=<taps>`、PRBS31 10 s):

  | RATE | DELAY_1 | BER |
  |---|---|---|
  | 1200M | 12 / 18 / 24 | 1.2e-8 / 1.5e-8 / 1.3e-8 (差なし) |
  | 1300M | 0 / 8 / 16 / 32 | ロックせず / 2.1e-4 / 1.4e-4 / 4.8e-3 |
  | 1400M | 5 / 10 / 15 / 20 / 25 / 30 | 4.7e-3 / 6.5e-3 / 9e-3 / 1e-2 / 4.2e-3 / 1.1e-2 (全滅) |

  DELAY_1 は効いている (0 では位相が重なりロックせず、32 = 0.5 UI で悪化) が、8〜24 の範囲は平坦で、
  1.4 Gbps はどの位相でも 1e-2 台。→ サンプル位相ではなくアイが閉じている (1.2 → 1.3 → 1.4 Gbps で 1e-8 → 1e-4 → 1e-2 と連続的に悪化)。
  この経路 (pmod0 LVPECL33E DRIVE=16 → USB-C ケーブル → pmod2 CTLE=HIGH、EasyCDR IP) では 1.2 Gbps が限界。
  DP TX (LVDS25、実機シンク側にイコライザあり) が 1.62 Gbps で通ることとは矛盾しない: 限界は GPIO の速度ではなく
  このループバック経路のアイ。GPIO 受信の真の上限を知るには、短い直結ケーブル/別ケーブル、または TX 側の
  プリエンファシス相当の工夫で再測定が要る。
- **直結ループ** (`TX_DIRECT=1`: TX を pmod0 pin 1/7 = F5/G5 に移し、モジュール/USB-C なしでジャンパ線で pmod2 pin 1/7 へ)
  (2026-09-26、PRBS7 / PRBS31 各 10 s):

  | 経路 | 1G | 1200M | 1300M | 1400M |
  |---|---|---|---|---|
  | モジュール + USB-C 10cm、LVPECL33E (基準) | 0 / 0 | 0 / 1.5e-8 | 1.3e-5 / 1.4e-4 | 1.7e-2 / 9e-3 |
  | 直結ジャンパ、LVPECL33E | 0 / 0 | 1.6e-6 / 2.0e-4 | 1.1e-2 / 1.7e-2 | ロックせず |
  | 直結ジャンパ、真 LVDS (`TX_TLVDS=1`) | 1.6e-9 / 8.5e-9 | 8.2e-3 / 5.2e-2 | — | ロックせず |
  | モジュール + USB-C、真 LVDS | 0 / 5.6e-8 | 0 / 2.0e-4 | — | 2.5e-2 / 2.8e-2 |

  ジャンパ直結 (終端なし) はインピーダンスが崩れて USB-C 経路より悪い。真 LVDS は振幅で負ける。
- **終端抵抗付きの直結配線** (同日、ユーザーが用意、TX_DIRECT=1 + LVPECL33E) で様子が一変:

  | RATE | PRBS7 / PRBS31 (10 s) | DELAY_1 掃引 (PRBS31) |
  |---|---|---|
  | 1G | 0 / 0 | |
  | 1200M | 0 / 0 | |
  | 1300M | 0 / 0 | |
  | 1400M | 2.0e-8 / 1.8e-7 | 12: 1.3e-7、15: 1.8e-7、18: 3.5e-7 |
  | 1487M5 | 2.4e-4 / 4.8e-4 (DELAY_1 14) | 8: 2.8e-3、9: 1.1e-4、10: 1.3e-4、11: 5.6e-3、12: 3.3e-3、14: 4.8e-4、17: 6.1e-4 (9〜10 と 14 に谷、間が悪い非単調) |
  | 1600M | 6.5e-3 / 1.3e-2 | |

  → 経路さえ良ければ GPIO + EasyCDR IP は 1.3 Gbps まで誤りなし、1.4 Gbps で 1e-7、1.4875 Gbps (1080p60) は 1e-4 台。
  RX CTLE (`make ... CTLE=LOW|MEDIUM|HIGH`、1487M5、終端付き直結): LOW ロックせず (1e-1)、MEDIUM 8e-3、HIGH 2.4e-4 →
  直結でも HIGH が最良 (過補償ではない)。
  これまでの「1.2 Gbps 上限」は経路 (モジュール + USB-C、終端なしジャンパ) の限界だった。1487M5 は ODIV 1 の 4 相
  (PE_FINE 2/4/6) を使っており、DELAY_1 に対して非単調なのは位相精度の影響かもしれない (未確認)。
- 合成結果 (2026-09-25): 1200M / 1400M / 1487M5 はタイミング違反なし (pclk Fmax 193MHz)。1600M は pclk 200MHz に
  対し IP 内ギアボックス −0.16ns、64bit 誤り計数器 −0.08ns が残る (BER 測定には支障ない程度だが要注意)。
  LED 状態ピンと PRBS の sel マルチプレクサは変種のためにパイプライン化した (bert_core/prbs_gen/prbs_chk の `sel_q`)
- 自前 CDR (`oscdr_phy_gw5a.v`) は 1Gbps 固定タップなので RATE との併用は project.tcl がエラーにする
- アイスキャン (`host/eyescan.py --step-ps`) の 1 ステップは VCO 周期 / 8: 1200M 104ps、1400M 89ps、1487M5 168ps、1600M 156ps
  (ただしアイスキャンは自前 CDR の位相凍結が前提なので IP 版では BER のみ)

Chrome/Edge で `host/bert.html` を開き Connect (Serial)。接続時に `I` で識別、
設定を Apply しカウンタをクリアして計測開始。表示: ロック、ビット数、誤り数、
BER、95% 信頼上限 (誤り 0 のとき 3/N)、アンロック回数、経過時間、累積 BER の
時系列 (誤り発生と非ロック区間をティック表示)。

- **Inject 1 error**: TX 側で 1 ビット反転 → errors が 1 増えれば計数経路が正しい
- ケーブルを抜くとロックが落ちアンロック回数が増える。全ゼロでは偽ロックしない
- TX invert / RX invert / RX bit-reverse でリンク極性・ビット順の実験ができる
- BER 1e-12 を 95% 信頼で言うには 3e12 ビット = 1Gbps で **50 分**

## アイスキャン

```sh
python3 host/eyescan.py --steps 24 --dwell 0.1 [--csv eye.csv]   # serial-bridge 経由
```
RX CDR を凍結し、TX PLLA の出力位相を 125ps ずつ進めながら各点の誤りを数える (終了後に戻す)。
実測: 8 ステップ周期 (= 1 UI) のバスタブ、開口 ≈ 0.5 UI。詳細と制約は `rtl/oscdr/README.md`。

## 次の候補

- CTLE / DRIVE の自動 A/B (要再合成のためビットストリーム変種で)
- 2 ボード構成 (別水晶) での ppm 差耐性測定
- 純正 IP と自前 CDR の BER 比較 (`USE_EASYCDR_IP` 変種)
