ciniml/fpga_samples/rtl/nvme/TCP_ENGINE.md

# TcpEngine — 現行設計の記録とベンチマーク (改良版比較用ベースライン)

`rtl/nvme/tcp_engine.veryl`。NVMe/TCP ターゲット用に書いた軽量 TCP サーバ
エンジン。将来ほかの用途にも使えるよう、構成・利点・欠点・実測速度を
ここに固定しておき、改良版と比較できるようにする。

計測日 2026-09-06 / Tang Nano 9K Pmod + LAN8720 / 100BASE-TX 直結 /
50MHz RMII ドメイン / ネームスペースは内蔵 PSRAM (54MHz, 512B ライン
キャッシュ)。改良版も**同一条件**で測ること。

## 構成

2 コネクション固定 (NVMe/TCP は 1 キュー = 1 コネクション: admin + I/O)。
`LOCAL_PORT` へのパッシブオープンのみ。全体が RMII の 50MHz 単一ドメイン。

### 受信 (RX)

- MAC からの 1 バイト/サイクル AXIS を `rx_pos` 駆動のパーサで解析
  (Ethernet/IPv4/TCP ヘッダをオフセット固定で拾う)。
- **インオーダのみ**: `seq == rcv_nxt` の payload だけ受理し、それ以外は
  破棄して重複 ACK を返す。再組み立てはしない。
- payload は 2KiB の RX FIFO へ。**FIFO の空き = 広告ウィンドウ**なので
  ピアがオーバランできない。アプリが吸い出したらウィンドウ更新 ACK。
- コミットは 2 段パイプライン (`cm_*` → `cm2_*`): tlast でフレームを
  ラッチ → シーケンス演算を前計算 → 状態適用。FCS が良のフレームのみ
  コミット (RX 側は TCP チェックサム検証を省略、MAC の FCS を信頼)。

### 送信 (TX)

- アプリのバイトは 2KiB のリングへ。**このリングが Go-back-N の再送
  バッファ (`snd_una..wr_seq`) を兼ねる**。
- セグメントは **1024 バイトで分割**、またはアプリのストリームが
  ~10µs アイドルしたらフラッシュ (`idle_cnt >= 512` サイクル)。
- フレーム生成は 1 バイト源関数への 2 パス: パス 1 で IPv4/TCP
  チェックサム積算 (擬似ヘッダ込み)、パス 2 でバイト出力 (60 バイト
  最小長へパディング)。SYN-ACK は MSS=1460 オプション付き。
- 再送: RTO (25M サイクル = 0.5s) で `snd_nxt` を `snd_una` に戻す
  (Go-back-N)。ファストリトランスミットなし。

### コネクション

`Closed → SynRcvd → Estab → LastAck`。インオーダ FIN で ACK し
`conn_active` を落とし (NVMe/TCP パーサをリセット)、リング枯渇後に自分の
FIN を送って最終 ACK で Closed。RST は即 Closed。

## 利点

- **小さい**: TcpEngine 単体で約 2,000 LUT / 900 ALU / 1,600 FF、BRAM は
  RX FIFO + TX リング (2KiB×2×2 = 4 BSRAM 相当)。9K に 2 コネクション分
  が収まる。
- **単一クロック**・バックプレッシャ少なめで組み込みやすい。
- RX チェックサム省略 (MAC FCS 前提) で軽い。
- ARP/ICMP は別モジュール (`eth_ip.veryl`)、TX 多重化は `eth_tx_mux.veryl`
  と分離。アプリ側は 16 ビット (2 レーン) の valid/ready バイトストリーム
  だけ見ればよい。

## 欠点 (改良版で潰したい点)

1. **インフライト上限 2KiB** — リングが再送バッファ兼用で 2KiB 固定。
   ピアの広告ウィンドウを見ずに「最大 2KiB しか飛ばさない」。これが
   ストップ・アンド・ゴーを生み、スループットの主因。
2. **ピアウィンドウ非追跡** — 相手の rwnd を無視 (小さいので実害は出て
   いないが、正しくない)。
3. **セグメント 1024B 固定** — MSS (1460) 未満。フレーム数が増える。
4. **フラッシュタイマ依存** — 1024B に満たないデータは ~10µs 待って
   から送るため、レイテンシに下駄。
5. **Go-back-N のみ** — ロス時に snd_una から全再送。ファスト
   リトランスミット/SACK なし。RTO も 0.5s と粗い。
6. **インオーダ RX のみ** — 順序が乱れると破棄 + dup ACK。
7. **1 コマンド = 1 往復に近い**直列性 (QD を上げても伸びない)。

## 実測ベースライン (改良版と比較する数値)

`spdk_nvme_perf`、-t 6〜10 秒、PSRAM ネームスペース。

### ランダム (レイテンシ寄り)

| 条件 | IOPS | MiB/s | 平均レイテンシ |
|---|---|---|---|
| 4KiB randread QD1 | 330 | 1.29 | 3.03 ms |
| 4KiB randread QD4 | 469 | 1.83 | 8.54 ms |
| 4KiB randwrite QD4 | 305 | 1.19 | 13.1 ms |
| 512B randread QD4 | 2636 | 1.29 | 1.52 ms |

### シーケンシャル (スループット寄り) ← 改良の主戦場

| 条件 | IOPS | MiB/s | 平均レイテンシ |
|---|---|---|---|
| 4KiB read QD1 | 332 | 1.30 | 3.01 ms |
| 4KiB read QD8 | 484 | 1.89 | 16.5 ms |
| 32KiB read QD4 | 62 | 1.95 | 64.7 ms |
| 128KiB read QD1 | 14.5 | 1.81 | 69.3 ms |
| 128KiB read QD4 | 16.2 | 2.02 | 254 ms |
| 128KiB write QD1 | 10.5 | 1.31 | 96.2 ms |

**要点**: ブロックサイズや QD を上げても **約 2 MiB/s で頭打ち**。
100BASE-TX の実効 (~11.8 MiB/s) の **約 16%** しか使えていない。
上限はインフライト 2KiB の窓 (欠点 1)。RTT ~1ms 相当ごとに 2KiB しか
送れない = 約 2 MiB/s、と整合する。

参考: BRAM ネームスペース版 (PSRAM レイテンシ無し) の 4KiB randrw QD4 は
999.8 IOPS だったが、これも ~4 MiB/s 級で頭打ち傾向は同じ。

## 改良版の目標

- ピアの広告ウィンドウを追跡し、**インフライトを rwnd (数十 KiB) まで**
  引き上げてストップ・アンド・ゴーを解消 (最優先)。
- MSS (1460B) セグメント化。
- フラッシュタイマ依存を減らし、送れるものは即送る。
- できれば RTO の適正化 / 重複 ACK ベースのファストリトランスミット。
- 目標スループット: 100BASE-TX の **> 70% (> 8 MiB/s)**。
- 安定性最優先: マルチキュー + 連続再接続で smoke/SPDK が安定して通る
  こと (前回の試作はここで不安定化して revert した)。

検証は `rtl/nvme/sim` の根なしフルチェーンシム (`eth_tap_bridge` の
`unix:<path>` 転送 + `sim_host.py`) と実機の両方で行う。

## 改良版 第1段: インフライト窓の拡大 (2026-09-06)

最小・低リスクの変更で頭打ちの主因 (欠点 1) を緩和:

- TX リング (再送バッファ兼用) を 2KiB → **8KiB/コネクション**に拡大。
  ホスト向けリード (c2h) のインフライトが 4 倍。
- RX FIFO (= 受信ウィンドウ) も 2KiB → **8KiB**。ホストからのライト
  (h2c) のインフライトが 4 倍。
- セグメントを 1024B → **MSS 1460B**。
- タイミング用に受信シーケンス加算の `rcv_nxt` を前段でレジスタ化
  (`cm_rcv`)。制御フローは変えていないので安定性は維持。

実機結果 (同一条件、smoke 3/3・SPDK 安定):

| 条件 | 改良前 | 改良後 | 倍率 |
|---|---|---|---|
| 128KiB read QD1 | 1.81 MiB/s | 3.55 MiB/s | 2.0x |
| 128KiB read QD4 | 2.02 MiB/s | 3.90 MiB/s | 1.9x |
| 128KiB write QD1 | 1.31 MiB/s | 1.96 MiB/s | 1.5x |
| 128KiB write QD4 | ~1.3 MiB/s | 2.03 MiB/s | 1.6x |
| 4KiB randread QD4 | 469 IOPS | 640 IOPS | 1.4x |
| 4KiB randrw QD4 | 361 IOPS | 510 IOPS | 1.4x |

リソース: Logic 84%、BSRAM **81% (21/26)**、Fmax 50.8MHz。

**残る頭打ちと次段**: リード ~3.9 MiB/s (100BASE-TX の ~33%) で再び頭打ち。
8KiB のインフライトでも 1 RTT あたり 8KiB しか送れず、ACK/ウィンドウ更新の
往復と (小さい転送では) フラッシュタイマ待ちが律速。さらに伸ばすには
(a) ピアの広告ウィンドウを追跡してインフライトを rwnd (数十 KiB) まで
上げる、(b) ACK 折り返しの短縮、(c) フラッシュタイマ依存の除去、が必要。
ただし 9K は BSRAM 81% で**これ以上バッファを増やせない** — 8KiB 超の
インフライトには Primer 20K などより大きい FPGA か、再送バッファを PSRAM に
逃がす設計が要る。第1段は「9K に収まる範囲で 2 倍」が到達点。

## 律速の切り分け (2026-09-07)

根なしフルチェーンシム (`sim_host.py SIM_BULK=64`、32KiB リード反復) で
TcpEngine 内部を計測 (`eth_nvme_top.sv` の PROF、`+define+DBG_APP`)。
`eth_tap_bridge` のフレームログにサイクルタイムスタンプ (`cyc=`) を追加。

150 万サイクル累積:

| 指標 | 値 | 意味 |
|---|---|---|
| dready_idle | ~0 (111) | 送れるデータがあるのにTXが遊ぶサイクル ≈ 0 |
| ringfull | 17% | インフライトが 8KiB に達しACK待ちのサイクル |
| dready | 53% | unsent >= MSS のサイクル |

**結論**:
- **エンジンは送れるデータがあれば遊ばない** (dready_idle≈0)。送信スケジュー
  リングに削れる無駄はない。以前の「1セグメント/RTT」はバグではなく、
  8KiB のウィンドウが 1 ワイヤ時間で埋まってホストの ACK を待つ、
  **window/RTT 律速の原理そのもの**。ウィンドウ 2→8KiB で実機 2 倍に
  なった事実がこれを裏付ける。
- したがって実機の ~3.9 MB/s は **9K の実用上限**。BSRAM 81% で
  ウィンドウをこれ以上増やせない。
- シムは ACK が速い (ringfull わずか 17%) ので、別の天井 = **c2h アプリ
  経路 + 送出が約 0.1 B/cyc ≈ 5〜6 MB/s** で見える。これは実機では
  window 律速の下に隠れているが、ウィンドウを増やせる環境では次の
  ボトルネックになる。

**次の一手 (優先度順)**:
1. **Primer 20K など BRAM の多い FPGA へ移行**し、ウィンドウを数十 KiB
   に拡大 (実機の window 律速を解く唯一の道)。ピア広告ウィンドウ追跡も
   そこで入れる。
2. 移行後、c2h アプリ経路 (NvmeTcpTarget のギアボックス/PDU 化) の
   ~0.1 B/cyc を改善して次の天井を上げる。
3. 9K に留まるなら、RX FIFO を縮めて TX リングに寄せる非対称配分で
   リードだけ少し伸ばす余地はある (ライトは犠牲)。

計測ツールは `rtl/nvme/sim` に常設: `SIM_BULK=<blocks>` で
`sim_host.py` がバルクリードを流し、ブリッジの `cyc=` ログと
`eth_nvme_top.sv` の PROF 行で送出/ACK のケイデンスとエンジン状態を測れる。

## 改良版 第2段: 1 バイト/サイクル書き込み器 + Tang Primer 20K (2026-09-11)

### 発見: 単一ストリームの天井は「アプリ書き込み器」
シムのプロファイルで、ターゲットが提示したバイトの 67% を TCP 側が拒否していた
(窓は空いている)。原因は `TcpEngine` のアプリ TX 書き込み器が **1 バイトに
3 サイクル** (arm → 書き込み+相手へ RR → 相手が無効で戻す) かけていたこと。
同一サイクルで適格コネクションを選んで即書き込む 1 バイト/サイクルの書き込み器に
置き換えた (`aw_g0/aw_g1`)。あわせて:
- `TX_RING_BYTES` / `RX_FIFO_BYTES` をパラメータ化 (`$clog2` で幅導出)。
- リング/FIFO を明示的な 2 ポート RAM (`tcp_byte_ram`) に。1 つの always 内で
  read/write する配列は read-before-write RAM として抽出され、Gowin BSRAM では
  信頼できない。ストール中は読み出し**アドレス**を保持してバイトを保つ。

### 9K では着地できない (Gowin 高使用率の挙動不良)
Logic 84〜85% / BSRAM 81〜89% で STA が通っていても余裕 0.01〜0.07% のビルドは
QD1 ハングやデータ化けを起こした。ready をレジスタのみから生成する変形 (登録
済み調停器 + 入力段) で 9K のタイミングは収まるが、**実機のリードが 6 倍遅く
なる** (20K で 5.6 → 0.93 MiB/s、シムでは再現しない、原因未特定)。よって
書き込み器は同一サイクル・組み合わせ grant のままとし、9K は BSRAM 81% の
第1段構成 (58bf4d6) に据え置く。

### Tang Primer 20K ターゲット (`eda/nvme_ethernet/src/tangprimer20k`)
- GW2A-18: Logic 33%、BSRAM 77% (TX 16KiB / RX 8KiB ×2 conn + 16KiB BRAM
  ネームスペース)、Fmax 82〜85MHz @ 50MHz RMII。
- ドック搭載 PHY は **RTL8201**。MDIO で page 7 / reg16 = 0x0FFE (CRS ピンを
  CRS_DV に) を書かないと link up でもフレームが 1 つも来ない
  (`rtl8201_init.sv`、Sipeed の TangPrimer-20K-example と同じ手順)。
- 書き込み直後は PHY のリンク再交渉で数秒不安定 (smoke が identify で止まる
  ことがある)。安定してから計測する。

### 実測 (Primer 20K、smoke 3/3、probe TOTAL diffs 0)

| 条件 | 9K (第1段) | 20K 旧書き込み器 | **20K 新書き込み器** |
|---|---|---|---|
| 4K read QD1 | 1.85 MiB/s | 5.60 | **6.08 MiB/s (0.64ms)** |
| 4K read QD8 | 2.94 | 6.97 | **8.05** |
| 4K randread QD4 | 640 IOPS | – | **2025 IOPS** |
| 16K read QD1 / QD4 | – | 6.50 / – | **7.38 / 8.14** |
| 4K write QD1 | 1.05 | – | **4.32** |
| 16K write QD1 / QD4 | – | 6.32 / – | **6.33 / 6.84** |
| 4K randrw QD4 | 510 IOPS | – | **1664 IOPS** |

100BASE-TX 実効 (~11.8 MiB/s) の **約 69%** に到達。9K 比でリード 3〜4 倍、
IOPS 3.2 倍。9K が遅かった主因の一つは PSRAM ネームスペース (512B ラインの
入れ替えでストリームが細切れになる) だったことも、20K + BRAM で旧書き込み器が
5.6 MiB/s 出たことから分かった。

### 次段
- 残り 30%: ワイヤ側は 7575 cyc/セグメント (1518B×4 + チェックサムパス) で
  シムでは飽和。実機の差はホスト側 (コマンド間の往復、遅延 ACK)。QD を上げる
  か、チェックサムを書き込み時に累積してパス 1 を消す。
- ピア広告ウィンドウ追跡、20K の DDR3 ネームスペース。
