ciniml/fpga_samples/eda/csi_capture/hw/Pmod_RPiCamera/fab/Pmod_RPiCamera_bottom.png

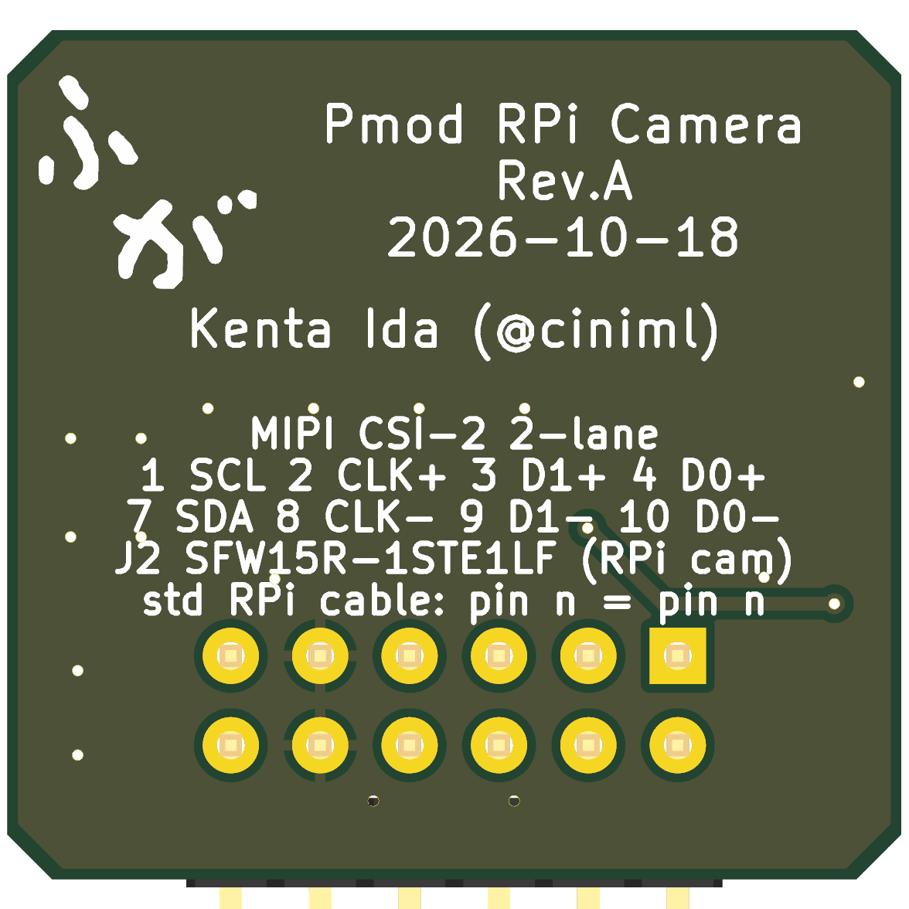
eda/csi_capture/hw/Pmod_RPiCamera/fab/Pmod_RPiCamera_bottom.png
