ciniml/fpga_samples/eda/pmod_100base_tx/kicad/out/render_iso.png

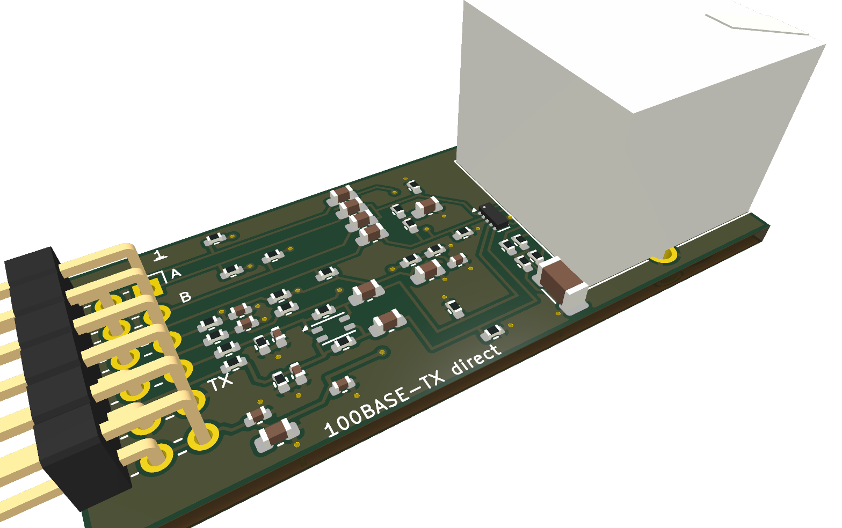
eda/pmod_100base_tx/kicad/out/render_iso.png
