ciniml/fpga_samples/eda/pmod_100base_tx/kicad_magjack/out/render_top.png

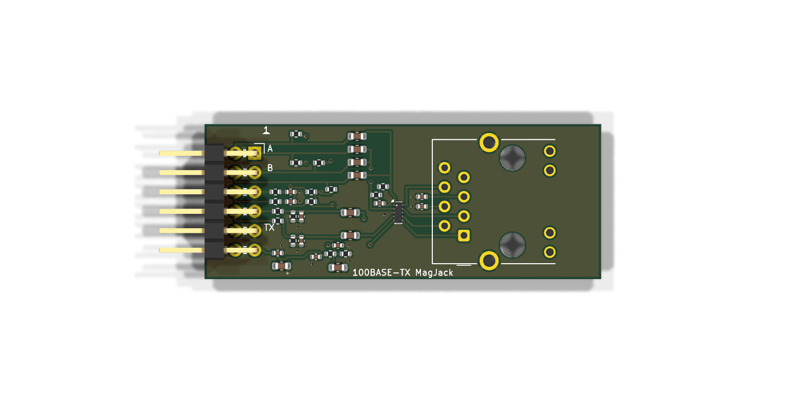
eda/pmod_100base_tx/kicad_magjack/out/render_top.png
