ciniml/fpga_samples/eda/pmod_usb_hs/hw/Pmod_USB_HS_Single/fab/Pmod_USB_HS_Single_bottom.png

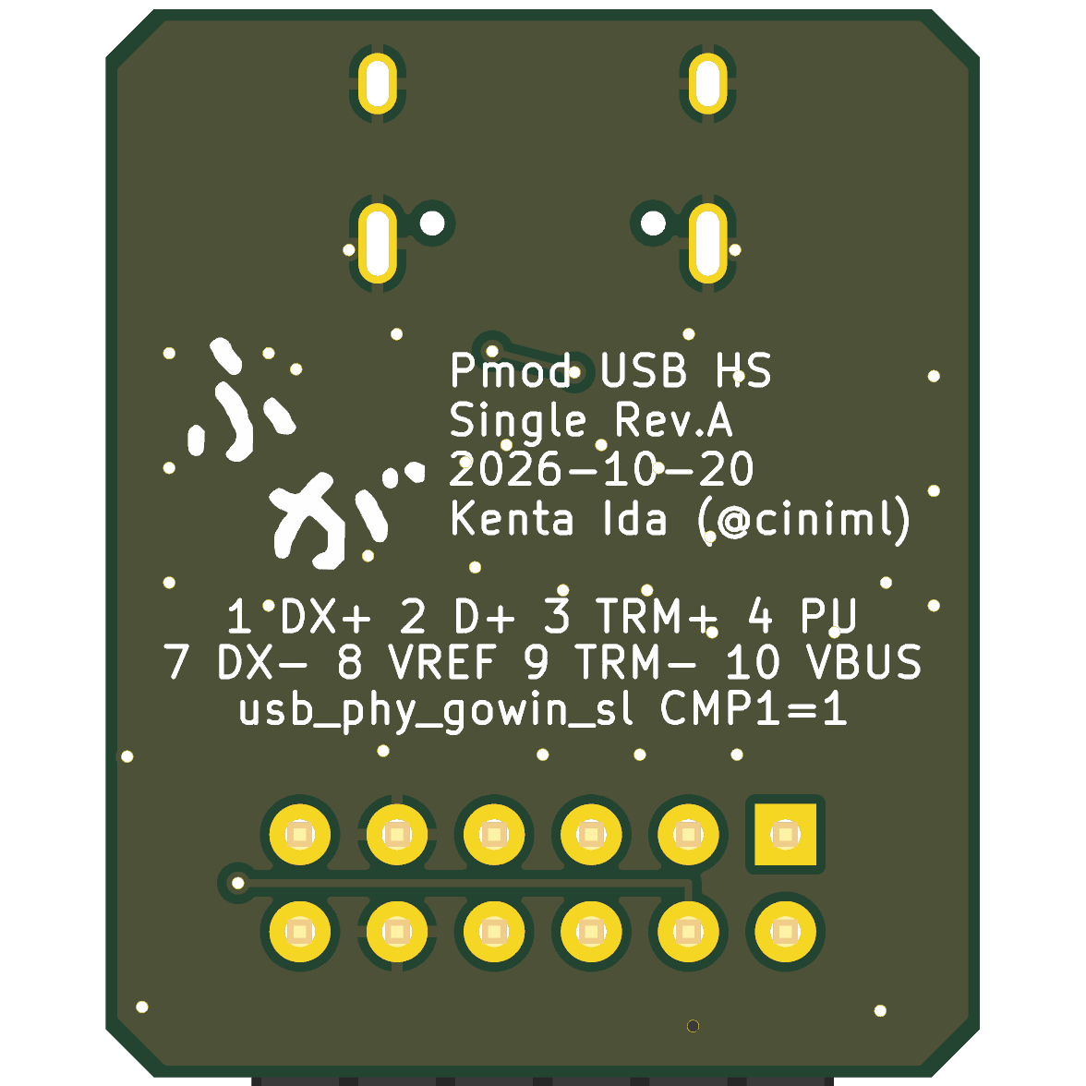
eda/pmod_usb_hs/hw/Pmod_USB_HS_Single/fab/Pmod_USB_HS_Single_bottom.png
