ciniml/fpga_samples/eda/targets/tangprimer25k/hw/DE0Header_PmodAdapter/fab/DE0Header_PmodAdapter_bottom.png

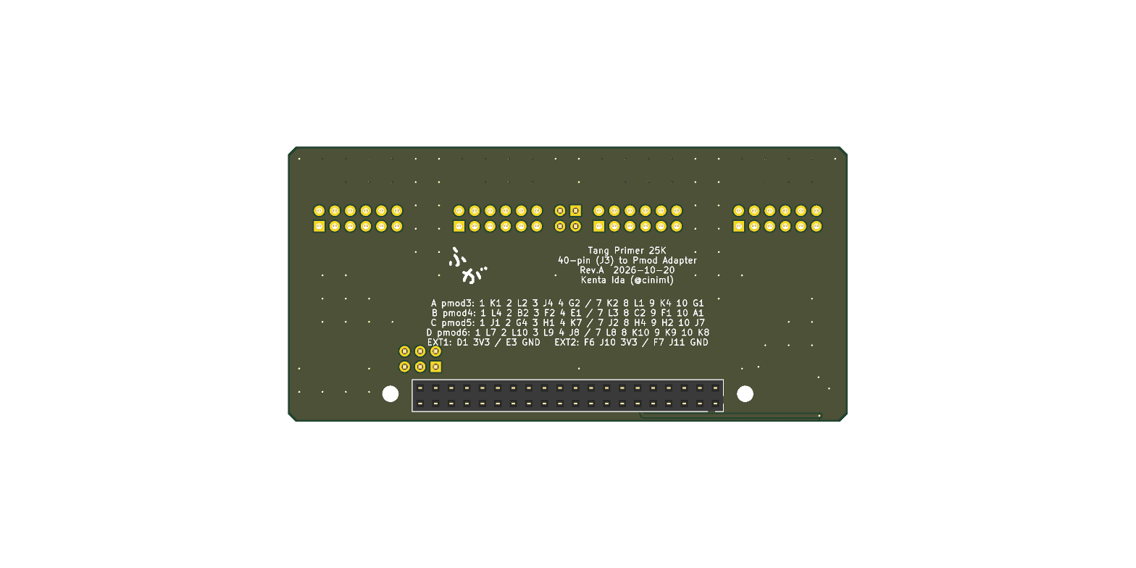
eda/targets/tangprimer25k/hw/DE0Header_PmodAdapter/fab/DE0Header_PmodAdapter_bottom.png
