ciniml/fpga_samples/eda/pmod_100base_tx/kicad/out/pmod_100base_tx_bom.csv

Refs | Value | Footprint | MPN | Manufacturer | Description | Qty | DNP
C1,C2 | 47p | Capacitor_SMD:C_0402_1005Metric | GRM1555C1H470JA01D | Murata | Cr C0G 50V, edge rate tune | 2
C3,C4,C6-C9 | 0.1u/100V | Capacitor_SMD:C_0603_1608Metric | GRM188R72A104KA35D | Murata | Ca tap,TX series C, X7R 100V | 6
C5 | 10n/100V | Capacitor_SMD:C_0603_1608Metric | GRM188R72A103KA01D | Murata | Ct termination midpoint, X7R 100V | 1
C10,C14 | 10u | Capacitor_SMD:C_0603_1608Metric | GRM188R61A106KE69D | Murata | X5R 10V | 2
C11,C15,C16 | 0.1u | Capacitor_SMD:C_0402_1005Metric | GRM155R71C104KA88D | Murata | X7R 16V | 3
C12,C13 | 1u | Capacitor_SMD:C_0402_1005Metric | GRM155R61A105KE15D | Murata | X5R 10V | 2
C17 | 1n/2kV | Capacitor_SMD:C_1206_3216Metric | C1206C102KGRACTU | KEMET | Bob Smith cap, X7R 2kV (optional) | 1
J1 | Pmod 2x6 R/A male | pmod_100base_tx:Pmod_Peripheral_2x06_P2.54mm_Horizontal | TSW-106-08-G-D-RA | Samtec | Pmod peripheral plug, 2x6 2.54mm right angle male, Type 1-6 top / 7-12 bottom | 1
J2 | RJ45 8P8C no magnetics | Connector_RJ:RJ45_Amphenol_RJHSE5380 | RJHSE-5380 | Amphenol ICC | Shielded 8P8C, no magnetics, no LED, THT right angle | 1
L1 | CMC 90R@100MHz | pmod_100base_tx:L_CommonModeChoke_2012Metric_FlowThrough | ACM2012-900-2P-T002 | TDK | Optional TX CMC (DNP in first build, R5/R6 0R fitted instead) | 1 | DNP
R1,R2 | 62 | Resistor_SMD:R_0402_1005Metric | RC0402FR-0762RL | Yageo | Rs, tune for 0.95-1.05 V diff | 2
R3,R4 | 120 | Resistor_SMD:R_0402_1005Metric | RC0402FR-07120RL | Yageo | Rp | 2
R5,R6 | 0 | Resistor_SMD:R_0402_1005Metric | RC0402JR-070RL | Yageo | CMC bypass (remove when L1 fitted) | 2
R7,R8 | 49.9 | Resistor_SMD:R_0402_1005Metric | RC0402FR-0749R9L | Yageo | RX termination | 2
R9-R12 | 2.2k | Resistor_SMD:R_0402_1005Metric | RC0402FR-072K2L | Yageo | Rb | 4
R13 | 270 | Resistor_SMD:R_0402_1005Metric | RC0402FR-07270RL | Yageo | VB divider (1.32 V) | 1
R14 | 180 | Resistor_SMD:R_0402_1005Metric | RC0402FR-07180RL | Yageo | VB divider | 1
R15,R17 | 3.3k | Resistor_SMD:R_0402_1005Metric | RC0402FR-073K3L | Yageo | PWM filter (2.7k widens range) | 2
R16,R18 | 1k | Resistor_SMD:R_0402_1005Metric | RC0402FR-071KL | Yageo | PWM filter | 2
R19-R22 | 75 | Resistor_SMD:R_0402_1005Metric | RC0402FR-0775RL | Yageo | Bob Smith (optional) | 4
R23-R26 | 1M | Resistor_SMD:R_0402_1005Metric | RC0402FR-071ML | Yageo | Line-side bleed to GND | 4
U1 | TPD4E02B04 | Package_SON:USON-10_2.5x1.0mm_P0.5mm | TPD4E02B04DQAR | Texas Instruments | 4ch bidirectional ESD, 0.25 pF, +/-3.6 V, flow-through (NC pads carry the line) | 1
