ciniml/fpga_samples/eda/dvi_hub75/hw/Pmod_StereoDAC/fab/Pmod_StereoDAC_bom.csv

Reference | Value | Footprint | QUANTITY | LCSC | MPN | Description
C1,C11 | 3.3n | Capacitor_SMD:C_0603_1608Metric | 2 | C107048 | YAGEO CC0603JRNPO9BN332 | 3.3 nF 50 V C0G 5% 0603
C2,C12 | 330p | Capacitor_SMD:C_0603_1608Metric | 2 | C1664 | Samsung CL10C331JB8NNNC | 330 pF 50 V C0G 5% 0603
C3,C13 | 1u | Capacitor_SMD:C_0805_2012Metric | 2 | C28323 | Samsung CL21B105KBFNNNE | 1 uF 50 V X7R 10% 0805 (DC block)
J1 | Pmod (host) | local:Conn_Pmod_Spec_B_Thin | 1 |  | 2x6 2.54 mm right-angle pin header (hand soldered) | Pmod 2x6 right angle (Digilent Pmod Type 1A / spec B)
J2 | PJ-313D | local:Jack_3.5mm_SHOUHAN_PJ-313D_Horizontal | 1 | C668608 | SHOU HAN PJ-313D | 3.5 mm stereo jack, SMD (SHOU HAN PJ-313D): tip = L, ring = R, sleeve = GND
J3 | L / GND / R | Connector_PinHeader_2.54mm:PinHeader_1x03_P2.54mm_Vertical | 1 | C49257 | BOOMELE 2.54-1*3P | 1x03 2.54 mm pin header, vertical: 1 = L, 2 = GND, 3 = R (line out, after the DC block)
R1,R11 | 1k | Resistor_SMD:R_0603_1608Metric | 2 | C21190 | UNI-ROYAL 0603WAF1001T5E | 1 kOhm 1% 0603
R2,R12 | 10k | Resistor_SMD:R_0603_1608Metric | 2 | C25804 | UNI-ROYAL 0603WAF1002T5E | 10 kOhm 1% 0603
R3,R13 | 100k | Resistor_SMD:R_0603_1608Metric | 2 | C25803 | UNI-ROYAL 0603WAF1003T5E | 100 kOhm 1% 0603
