ciniml/fpga_samples/eda/pmod_usb_hs/hw/Pmod_USB_HS_Single/fab/Pmod_USB_HS_Single_bom.csv

Reference | Value | Footprint | QUANTITY | LCSC | MPN | Description
C1,C5 | 1u | Capacitor_SMD:C_0402_1005Metric | 2 | C52923 | Samsung CL05A105KA5NQNC | 1 uF 10 V X5R 0402 (VBUS),1 uF 10 V X5R 0402 (VREF)
C3 | 10u | Capacitor_SMD:C_0603_1608Metric | 1 | C19702 | Samsung CL10A106KP8NNNC | 10 uF 10 V X5R 0603
C4 | 100n | Capacitor_SMD:C_0402_1005Metric | 1 | C307331 | Samsung CL05B104KB54PNC | 100 nF 16 V X7R 0402
D1,D2 | TPD1E05U06DPY | Package_SON:Texas_DPY0002A_0.6x1mm_P0.65mm | 2 | C436349 | TI TPD1E05U06DPYR | 1-channel ESD protection, 0.42 pF, X1SON-2
J1 | Pmod (host) | local:Conn_Pmod_Spec_B_Thin | 1 |  |  | Pmod 2x6 right angle (Digilent Pmod Type 1A / spec B)
J2 | USB_C_Receptacle_USB2.0_16P | Connector_USB:USB_C_Receptacle_HRO_TYPE-C-31-M-12 | 1 | C165948 | HRO TYPE-C-31-M-12 | USB Type-C receptacle, USB 2.0 (16 pin)
R1 | 1.5k | Resistor_SMD:R_0402_1005Metric | 1 | C25867 | UNI-ROYAL 0402WGF1501TCE | 1.5k 1% 0402 (D+ pull-up, soft connect)
R2,R3 | 36 | Resistor_SMD:R_0402_1005Metric | 2 | C57678 | UNI-ROYAL 0402WGF360JTCE | 36R 1% 0402 (HS termination, D+),36R 1% 0402 (HS termination, D-)
R6,R7 | 100 | Resistor_SMD:R_0402_1005Metric | 2 | C25076 | UNI-ROYAL 0402WGF1000TCE | 100R 1% 0402 (dx series, D+),100R 1% 0402 (dx series, D-)
R8 | 1.8k | Resistor_SMD:R_0402_1005Metric | 1 | C25871 | UNI-ROYAL 0402WGF1801TCE | 1.8k 1% 0402 (VREF ~130 mV)
R9 | 75 | Resistor_SMD:R_0402_1005Metric | 1 | C25133 | UNI-ROYAL 0402WGF750JTCE | 75R 1% 0402 (VREF)
R10,R11 | 5.1k | Resistor_SMD:R_0402_1005Metric | 2 | C25905 | UNI-ROYAL 0402WGF5101TCE | 5.1k 1% 0402 (CC1 Rd),5.1k 1% 0402 (CC2 Rd)
R12 | 100k | Resistor_SMD:R_0402_1005Metric | 1 | C25741 | UNI-ROYAL 0402WGF1003TCE | 100k 1% 0402 (VBUS divider, 5 V -> 3.0 V)
R13 | 150k | Resistor_SMD:R_0402_1005Metric | 1 | C25755 | UNI-ROYAL 0402WGF1503TCE | 150k 1% 0402 (VBUS divider)
