ciniml/fpga_samples/eda/csi_capture/hw/Pmod_RPiCamera/fab/Pmod_RPiCamera_bom.csv

Reference | Value | Footprint | QUANTITY | LCSC | MPN | Description
C1 | 10u | Capacitor_SMD:C_0805_2012Metric | 1 | C15850 | Samsung CL21A106KAYNNNE | 10 uF 25 V X5R 0805
F1 | 500mA hold | Fuse:Fuse_0805_2012Metric | 1 | C20978 | RUILON SMD0805P050TF (alt. Littelfuse 0805L050WR, C207022) | Resettable fuse, 6 V, I_hold 0.5 A, 0805
J1 | Pmod (host) | local:Conn_Pmod_Spec_B_Thin | 1 |  |  | Pmod 2x6 right angle (Digilent Pmod Type 1A / spec B)
J2 | SFW15R-1STE1LF | local:Amphenol_SFW15R-1STE1LF_1x15-1MP_P1.0mm_Horizontal | 1 | C3168538 | Amphenol ICC (FCI) SFW15R-1STE1LF | 15-pin 1.0 mm FFC ZIF, bottom contact; the connector of the Raspberry Pi Camera Module 2 itself
R1,R2 | 2.2k | Resistor_SMD:R_0402_1005Metric | 2 | C25879 | UNI-ROYAL 0402WGF2201TCE | 2.2k 1% 0402
R3 | 10k | Resistor_SMD:R_0402_1005Metric | 1 | C25744 | UNI-ROYAL 0402WGF1002TCE | 10k 1% 0402
