ciniml/fpga_samples/eda/targets/tangprimer25k/hw/DE0Header_PmodAdapter/fab/DE0Header_PmodAdapter_bom.csv

Reference | Value | Footprint | QUANTITY | LCSC | MPN | Description
C1 | 10u | Capacitor_SMD:C_0805_2012Metric | 1 | C15850 | Samsung CL21A106KAYNNNE | 10 uF 25 V X5R 0805 (LDO input)
C2 | 22u | Capacitor_SMD:C_0805_2012Metric | 1 | C45783 | Samsung CL21A226MAQNNNE | 22 uF 25 V X5R 0805 (LDO output)
C3,C4,C5,C6 | 100n | Capacitor_SMD:C_0402_1005Metric | 4 | C1525 | Samsung CL05B104KO5NNNC | 100 nF 16 V X7R 0402 (Pmod 3.3 V)
J1 | 2x20 female 2.54 (to Dock J3) | Connector_PinSocket_2.54mm:PinSocket_2x20_P2.54mm_Vertical | 1 | C5124634 | BOOMELE 2.54-2*20P | 2x20 2.54 mm female socket, 8.5 mm, mounted on the bottom side
J2 | PMOD A (pmod3) | Connector_PinSocket_2.54mm:PinSocket_2x06_P2.54mm_Horizontal | 1 | C22373932 | Hong Cheng HC-PM254-8.5H-2x6PW | Pmod host: 2x6 2.54 mm right-angle female socket
J3 | PMOD B (pmod4) | Connector_PinSocket_2.54mm:PinSocket_2x06_P2.54mm_Horizontal | 1 | C22373932 | Hong Cheng HC-PM254-8.5H-2x6PW | Pmod host: 2x6 2.54 mm right-angle female socket
J4 | PMOD C (pmod5) | Connector_PinSocket_2.54mm:PinSocket_2x06_P2.54mm_Horizontal | 1 | C22373932 | Hong Cheng HC-PM254-8.5H-2x6PW | Pmod host: 2x6 2.54 mm right-angle female socket
J5 | PMOD D (pmod6) | Connector_PinSocket_2.54mm:PinSocket_2x06_P2.54mm_Horizontal | 1 | C22373932 | Hong Cheng HC-PM254-8.5H-2x6PW | Pmod host: 2x6 2.54 mm right-angle female socket
J6 | EXT1 2x2 | Connector_PinHeader_2.54mm:PinHeader_2x02_P2.54mm_Vertical | 1 | C66690 | BOOMELE 2.54-2*2PPin | 2x2 2.54 mm pin header
J7 | EXT2 2x3 | Connector_PinHeader_2.54mm:PinHeader_2x03_P2.54mm_Vertical | 1 | C65114 | BOOMELE 2.54-2*3PPin | 2x3 2.54 mm pin header
U1 | AMS1117-3.3 | Package_TO_SOT_SMD:SOT-223-3_TabPin2 | 1 | C6186 | AMS AMS1117-3.3 | 3.3 V 1 A LDO (5 V from the header pin 11)
