ciniml/fpga_samples/eda/csi_capture/hw/Pmod_RPiCamera/fab/jlc/Pmod_RPiCamera_jlc_bom.csv

Comment | Designator | Footprint | LCSC Part #
10u | C1 | C_0805_2012Metric | C15850
500mA hold | F1 | Fuse_0805_2012Metric | C20978
SFW15R-1STE1LF | J2 | Amphenol_SFW15R-1STE1LF_1x15-1MP_P1.0mm_Horizontal | C3168538
2.2k | R1,R2 | R_0402_1005Metric | C25879
10k | R3 | R_0402_1005Metric | C25744
