ciniml/fpga_samples/eda/pmod_100base_tx/kicad_magjack/out/lcsc/pmod_100base_tx_magjack_lcsc_5pcs.csv

LCSC Part Number | Quantity | Manufacture Part Number | Manufacturer | Designator | Qty per board | Needed (5 boards + spares) | LCSC min. order | Unit price (USD) | Ext. price (USD) | LCSC stock | Note
C1567 | 100 | 0402CG470J500NT | FH | C1,C2 | 2 | 10 | 100 | 0.0082 | 0.82 | 160900
C14663 | 50 | CC0603KRX7R9BB104 | YAGEO | C3,C4,C6-C9 | 6 | 30 | 50 | 0.0109 | 0.55 | 6925800
C15195 | 100 | CL05B103KB5NNNC | Samsung Electro-Mechanics | C5 | 1 | 5 | 100 | 0.0041 | 0.41 | 1771100
C19702 | 20 | CL10A106KP8NNNC | Samsung Electro-Mechanics | C10,C14 | 2 | 10 | 20 | 0.0273 | 0.55 | 1205040
C307331 | 100 | CL05B104KB54PNC | Samsung Electro-Mechanics | C11,C15-C18 | 5 | 25 | 100 | 0.0095 | 0.95 | 2389000
C326568 | 50 | CC0402KRX5R8BB105 | YAGEO | C12,C13 | 2 | 10 | 50 | 0.0220 | 1.10 | 133200 | C52923 (CL05A105KA5NQNC) out of stock at LCSC (0), equivalent ordered
C12074 | 6 | HR911105A | HANRUN(Zhongshan HanRun Elec) | J2 | 1 | 6 | 1 | 1.9972 | 11.98 | 7593
C2909376 | 100 | FRC0402F62R0TS | FOJAN | R1,R2 | 2 | 10 | 100 | 0.0014 | 0.14 | 300300
C25079 | 100 | 0402WGF1200TCE | UNI-ROYAL | R3,R4 | 2 | 10 | 100 | 0.0034 | 0.34 | 6000
C25120 | 100 | 0402WGF499JTCE | UNI-ROYAL | R7,R8 | 2 | 10 | 100 | 0.0023 | 0.23 | 396000
C25879 | 100 | 0402WGF2201TCE | UNI-ROYAL | R9-R12 | 4 | 20 | 100 | 0.0012 | 0.12 | 2485100
C25104 | 100 | 0402WGF3300TCE | UNI-ROYAL | R13 | 1 | 5 | 100 | 0.0012 | 0.12 | 1256600
C25091 | 100 | 0402WGF2200TCE | UNI-ROYAL | R14 | 1 | 5 | 100 | 0.0035 | 0.35 | 1418400
C25890 | 100 | 0402WGF3301TCE | UNI-ROYAL | R15,R17 | 2 | 10 | 100 | 0.0036 | 0.36 | 793300
C11702 | 100 | 0402WGF1001TCE | UNI-ROYAL | R16,R18 | 2 | 10 | 100 | 0.0013 | 0.13 | 8928100
C106794 | 5 | TPD4E02B04DQAR | TI | U1 | 1 | 5 | 5 | 0.3342 | 1.67 | 26895
C41417354 | 6 | HX PZ2.54-2x6P WC-A | hanxia | J1 | 1 | 6 | 5 | 0.0962 | 0.58 | 4135 | hand soldered; check pin length / body against the Pmod footprint before use
