ciniml/fpga_samples/eda/pmod_usb_hs/hw/Pmod_USB_HS_Single/fab/Pmod_USB_HS_Single_schematic.pdf

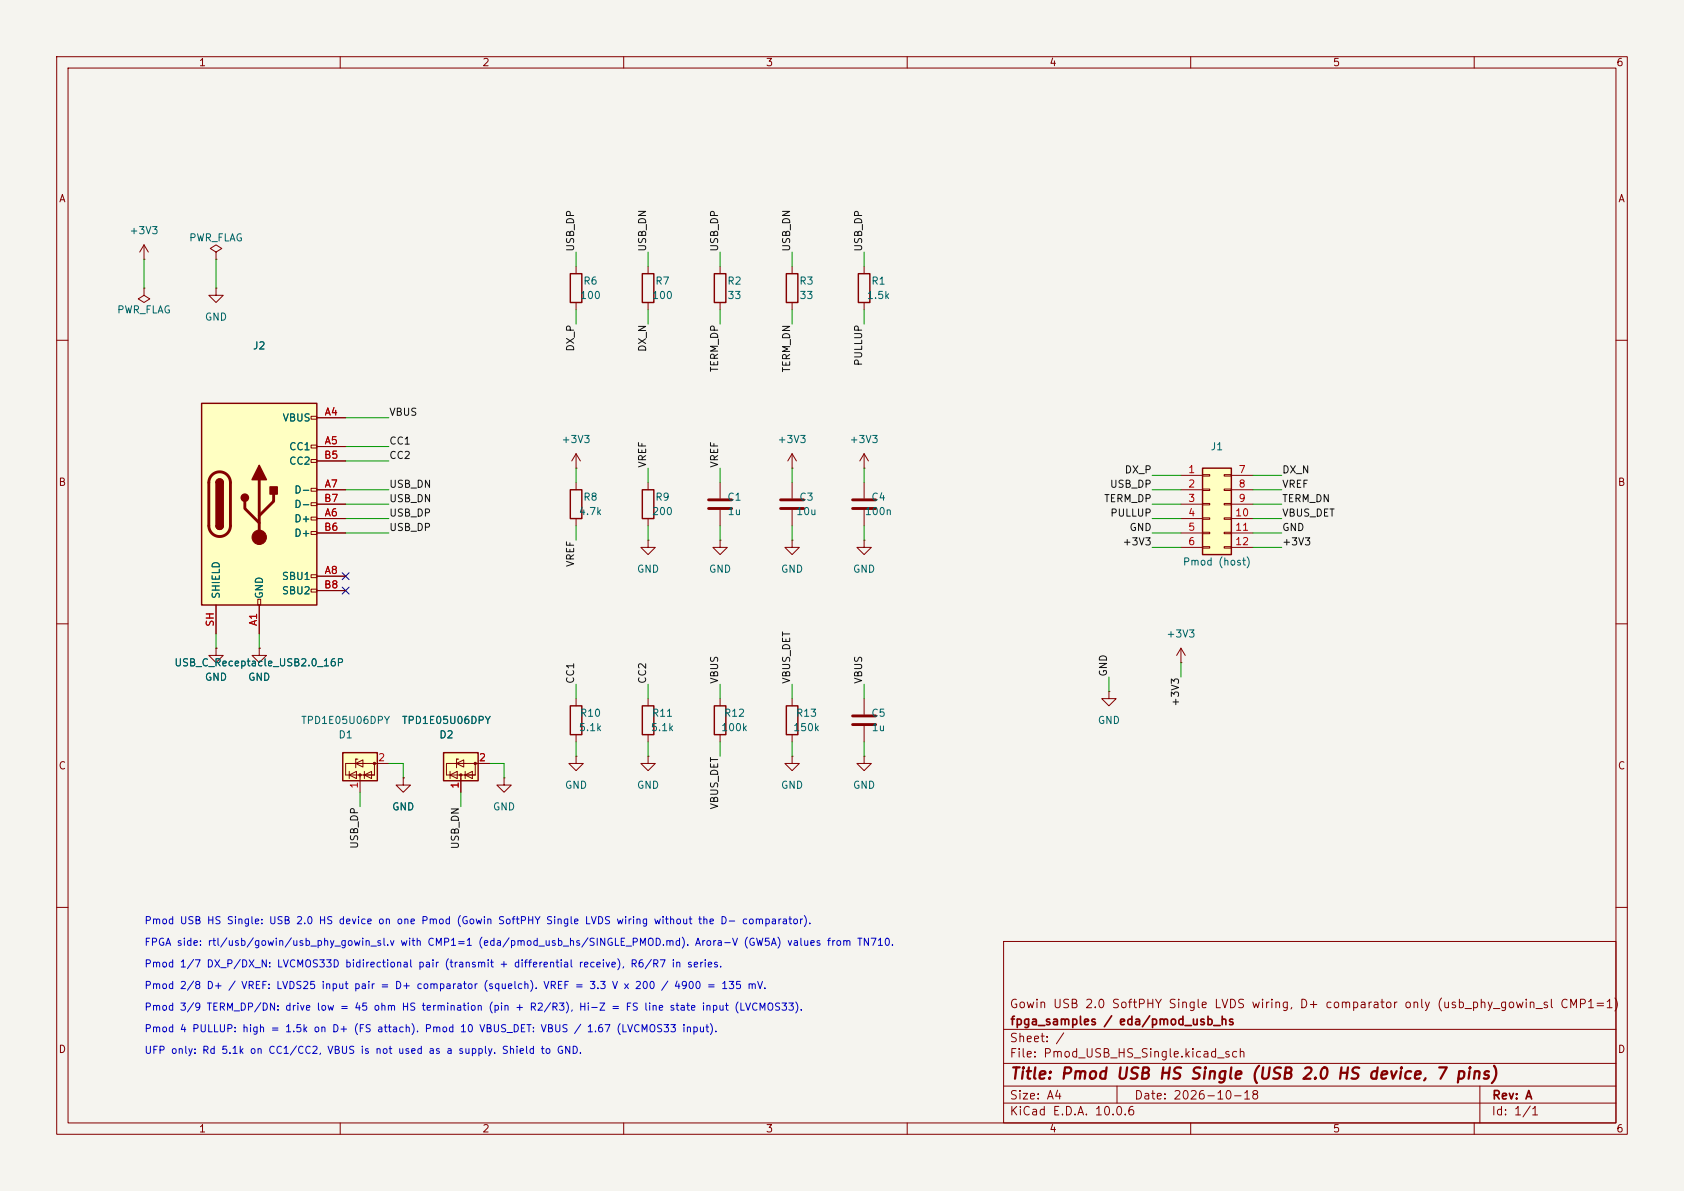
[picture p12: page 1]

fpga_samples / eda/pmod_usb_hs
Sheet: /
File: Pmod_USB_HS_Single.kicad_sch
Title: Pmod USB HS Single (USB 2.0 HS device, 7 pins)

Size: A4 | Rev: A
KiCad E.D.A. 10.0.6 | Id: 1/1
