ciniml/fpga_samples/eda/dvi_hub75/hw/Pmod_StereoDAC/fab/Pmod_StereoDAC_schematic.pdf

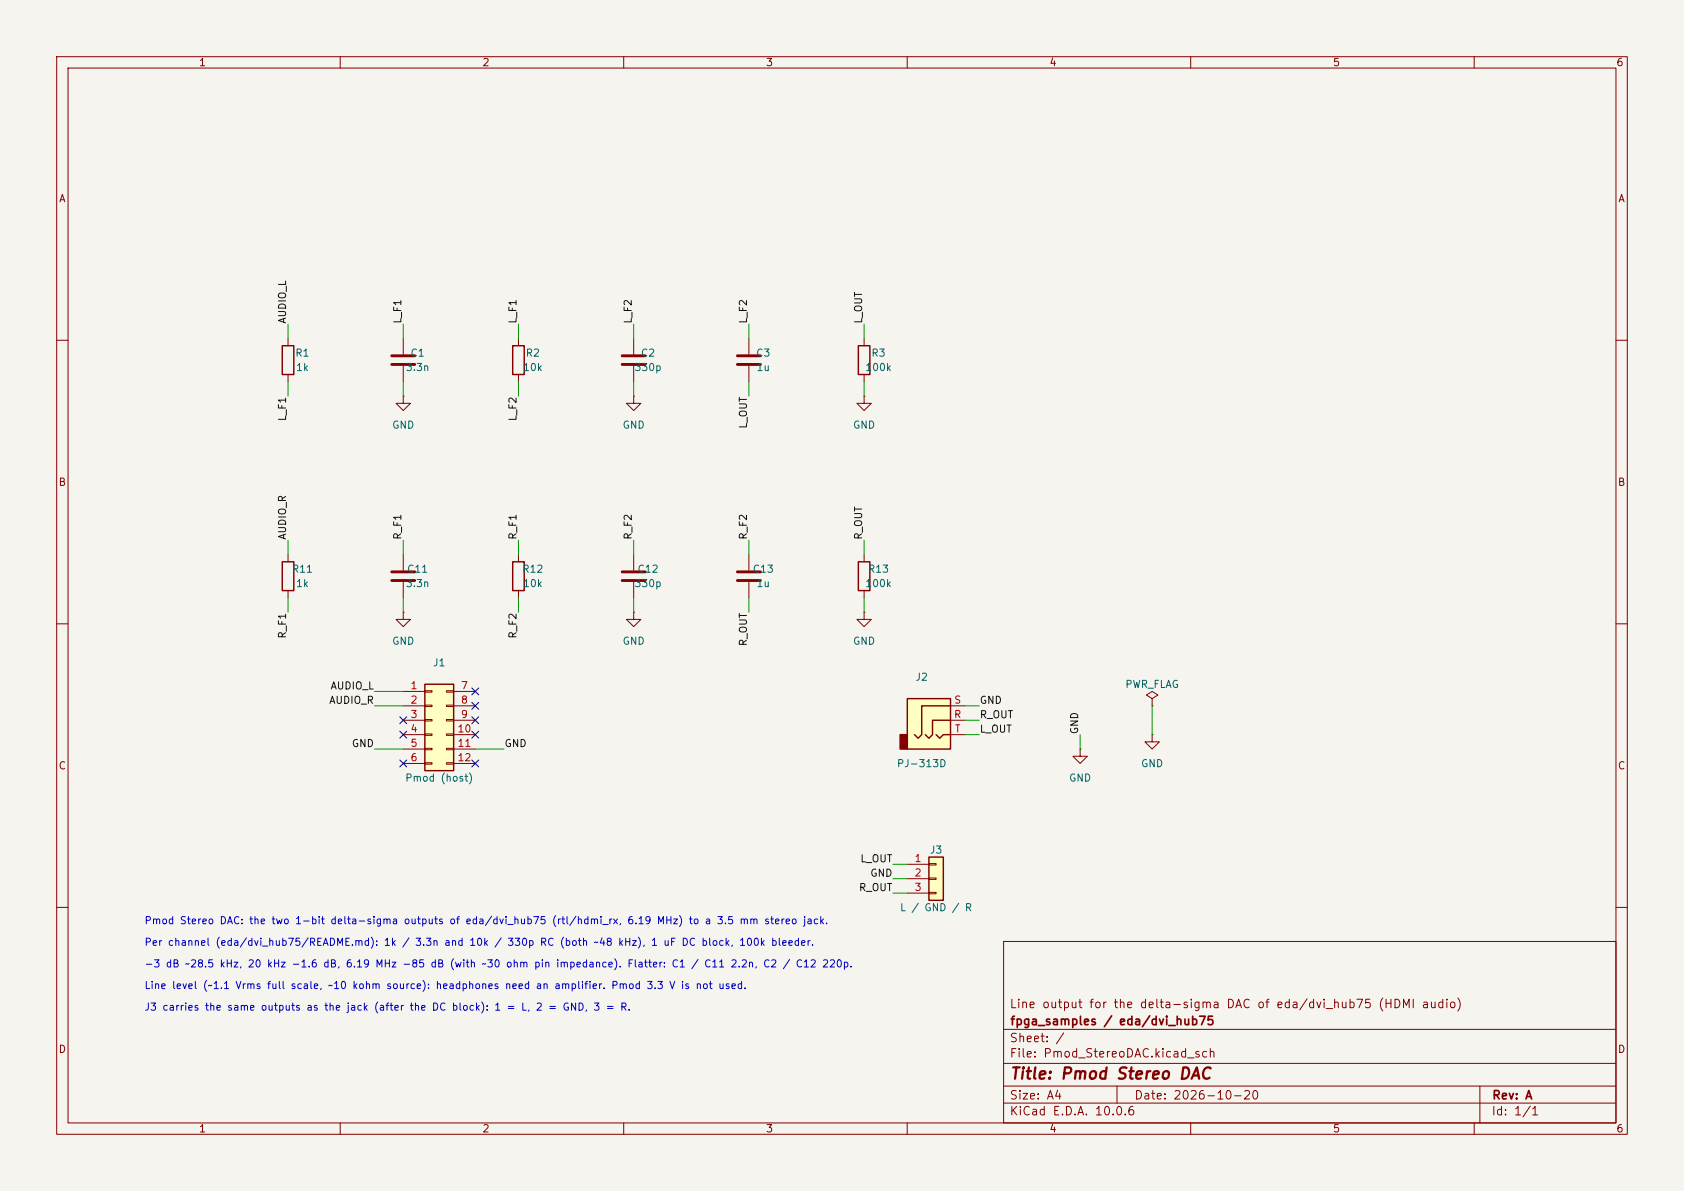
[picture p13: page 1]

Line output for the delta-sigma DAC of eda/dvi_hub75 (HDMI audio) R

Size: A4 | Rev: A
KiCad E.D.A. 10.0.6 | Id: 1/1
