ciniml/fpga_samples/eda/pmod_100base_tx/kicad/out/pmod_100base_tx_pcb.pdf

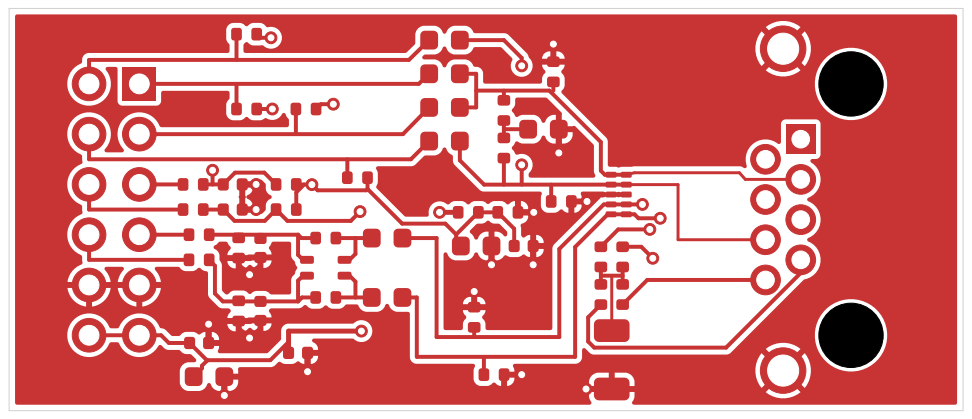
[picture p14: page 1]

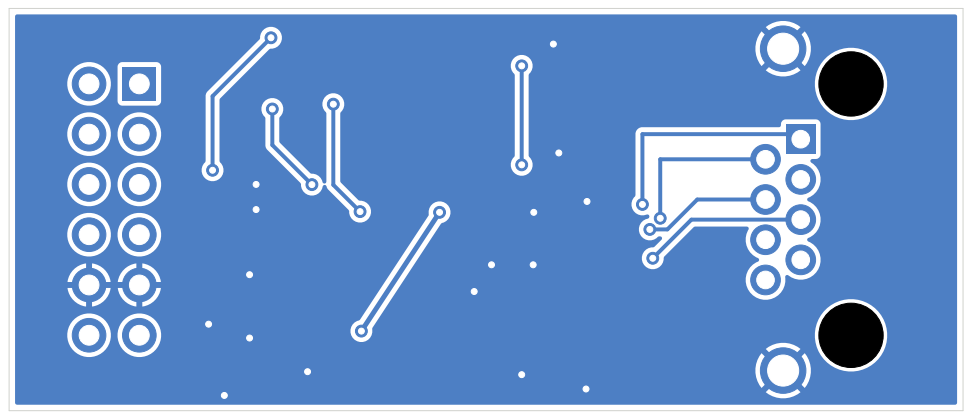
[picture p15: page 2]

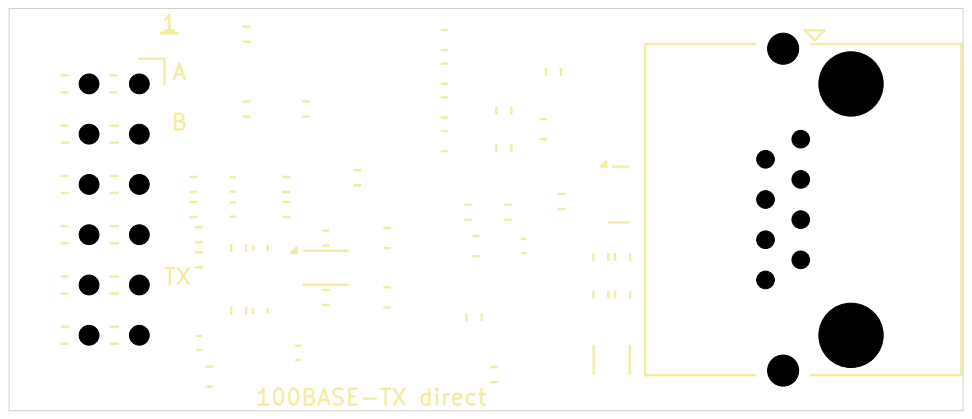
[picture p16: page 3]

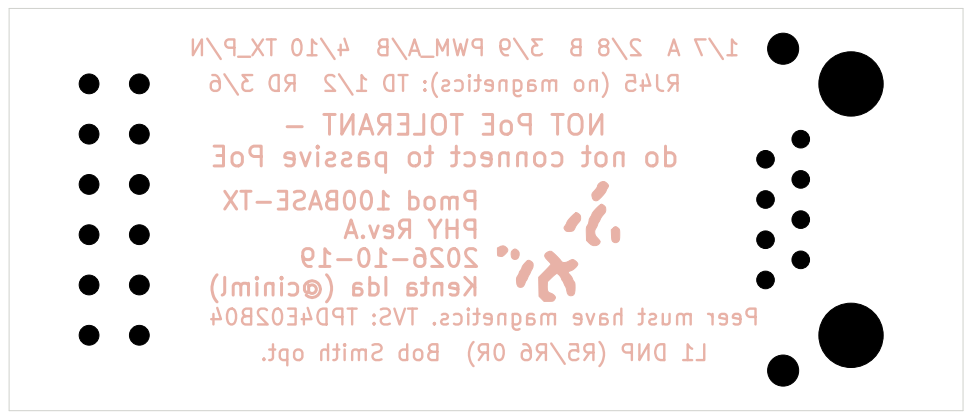
[picture p17: page 4]

(@ciniml) Ida Kenta - TOLERANT PoE NOT PoE passive to connect not do

3/6 RD 1/2 TD magnetics): (no RJ45

TPD4E02B04 TVS: magnetics. have must Peer opt. Smith Bob 0R) (R5/R6 DNP L1 100BASE-TX Pmod Rev.A PHY 2026-10-19

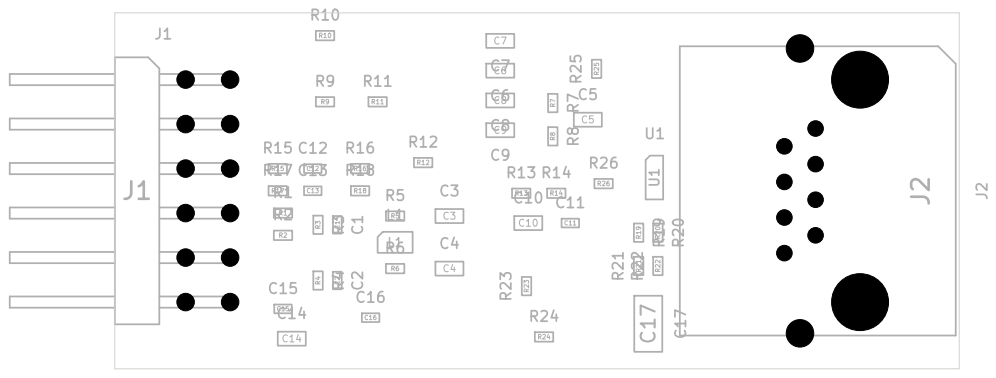
[picture p18: page 5]

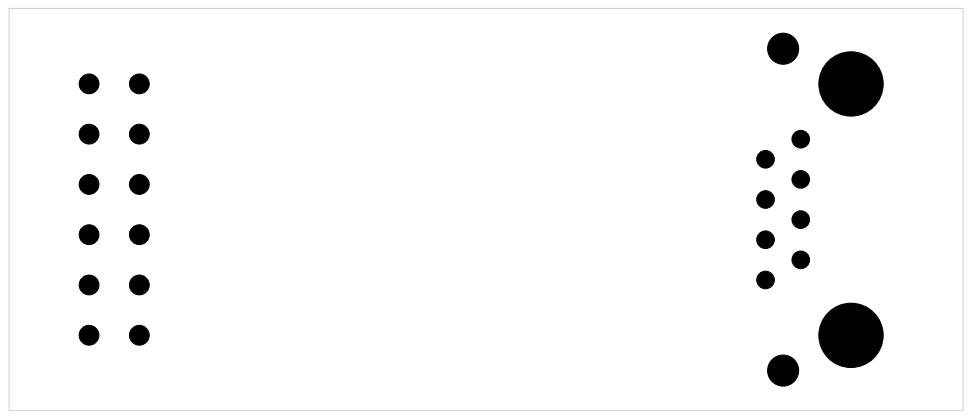
[picture p19: page 6]
