ciniml/fpga_samples/eda/pmod_usb_hs/hw/Pmod_USB_HS_Single/Pmod_USB_HS_Single.kicad_pcb

## KiCad design eda/pmod_usb_hs/hw/Pmod_USB_HS_Single/Pmod_USB_HS_Single.kicad_pcb (2026-10-31)

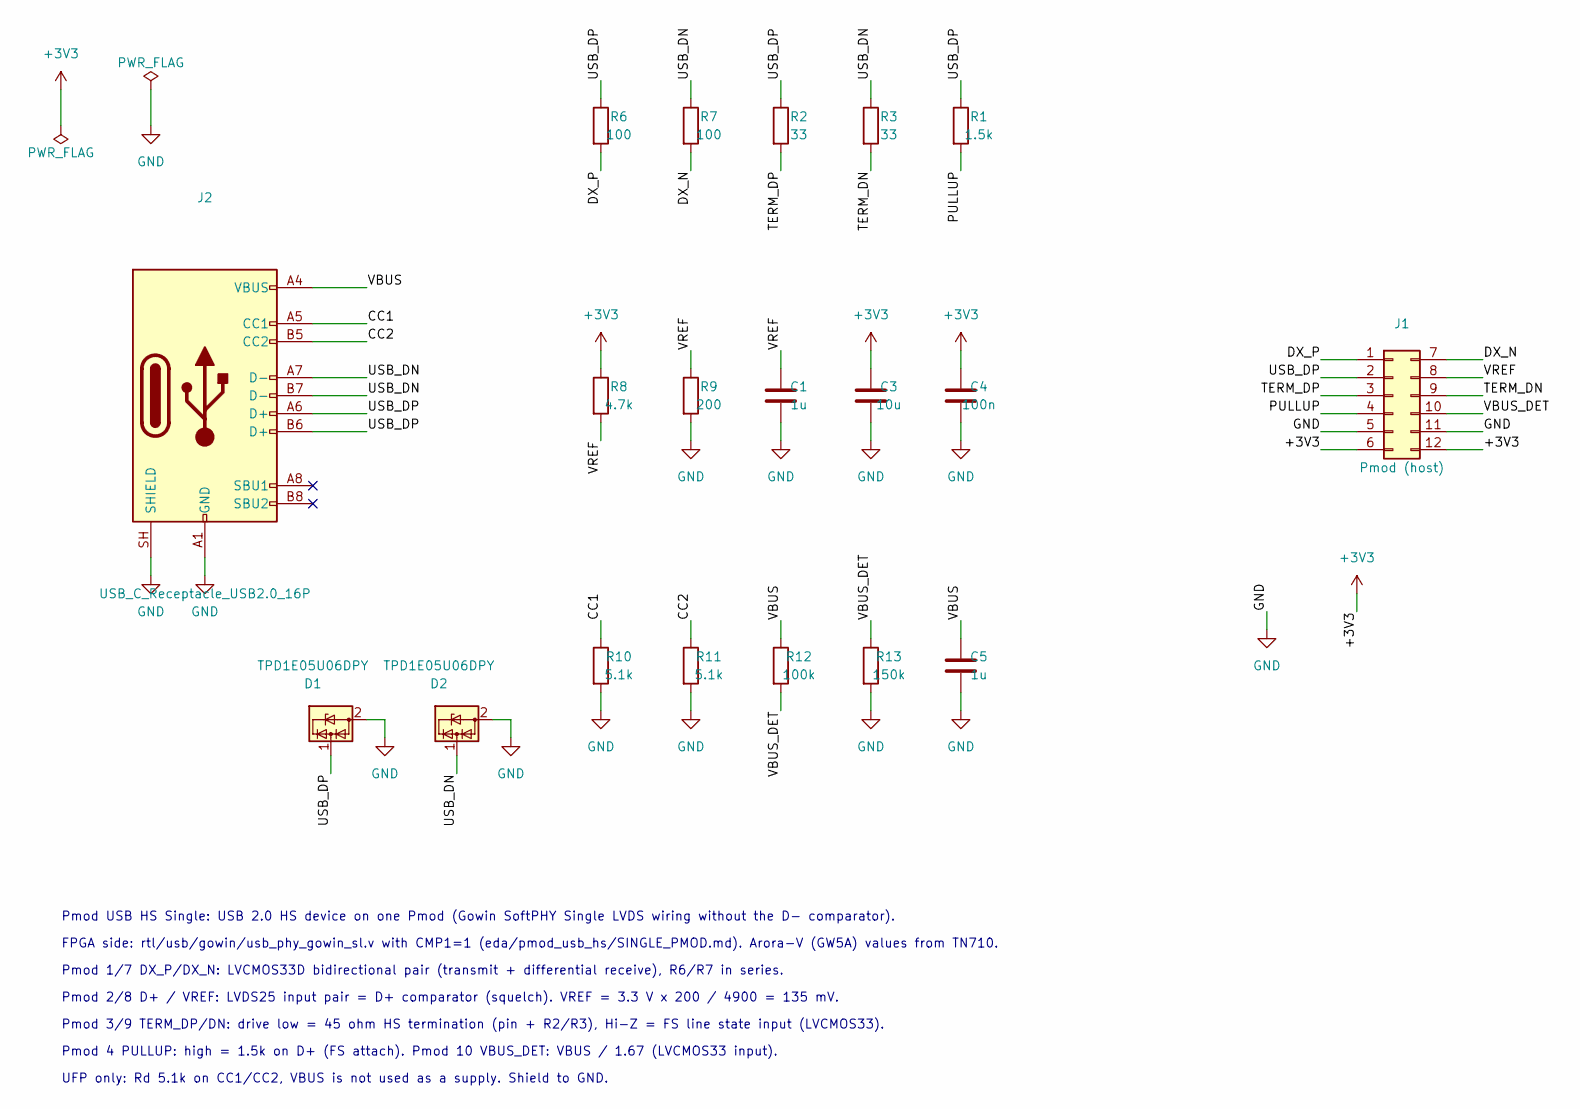
[picture p20: schematic Pmod_USB_HS_Single.kicad_sch, Pmod USB HS Single (USB 2.0 HS device, 7 pins)]

Parts:
C1, C5: 1u; C_0402_1005Metric; MPN Samsung CL05A105KA5NQNC; LCSC C52923
C3: 10u; C_0603_1608Metric; MPN Samsung CL10A106KP8NNNC; LCSC C19702
C4: 100n; C_0402_1005Metric; MPN Samsung CL05B104KB54PNC; LCSC C307331
D1, D2: TPD1E05U06DPY; Texas_DPY0002A_0.6x1mm_P0.65mm; MPN TI TPD1E05U06DPYR; LCSC C436349
J1: Pmod (host); Conn_Pmod_Spec_B_Thin
J2: USB_C_Receptacle_USB2.0_16P; USB_C_Receptacle_HRO_TYPE-C-31-M-12; MPN HRO TYPE-C-31-M-12; LCSC C165948
R1: 1.5k; R_0402_1005Metric; MPN UNI-ROYAL 0402WGF1501TCE; LCSC C25867
R2, R3: 33; R_0402_1005Metric; MPN UNI-ROYAL 0402WGF330JTCE; LCSC C25105
R6, R7: 100; R_0402_1005Metric; MPN UNI-ROYAL 0402WGF1000TCE; LCSC C25076
R8: 4.7k; R_0402_1005Metric; MPN UNI-ROYAL 0402WGF4701TCE; LCSC C25900
R9: 200; R_0402_1005Metric; MPN UNI-ROYAL 0402WGF2000TCE; LCSC C25087
R10, R11: 5.1k; R_0402_1005Metric; MPN UNI-ROYAL 0402WGF5101TCE; LCSC C25905
R12: 100k; R_0402_1005Metric; MPN UNI-ROYAL 0402WGF1003TCE; LCSC C25741
R13: 150k; R_0402_1005Metric; MPN UNI-ROYAL 0402WGF1503TCE; LCSC C25755

Connections:
+3V3: C3.1, C4.1, J1.6, J1.12, R8.1
/CC1: J2.A5 (CC1), R10.1
/CC2: J2.B5 (CC2), R11.1
/DX_N: J1.7, R7.2
/DX_P: J1.1, R6.2
/PULLUP: J1.4, R1.2
/TERM_DN: J1.9, R3.2
/TERM_DP: J1.3, R2.2
/USB_DN: D2.1 (I/O), J2.A7 (D-), J2.B7 (D-), R3.1, R7.1
/USB_DP: D1.1 (I/O), J1.2, J2.A6 (D+), J2.B6 (D+), R1.1, R2.1, R6.1
/VBUS: C5.1, J2.A4 (VBUS), J2.A9 (VBUS), J2.B4 (VBUS), J2.B9 (VBUS), R12.1
/VBUS_DET: J1.10, R12.2, R13.1
/VREF: C1.1, J1.8, R8.2, R9.1
GND: C1.2, C3.2, C4.2, C5.2, D1.2 (GND), D2.2 (GND), J1.5, J1.11, J2.A1 (GND), J2.A12 (GND), J2.B1 (GND), J2.B12 (GND), J2.SH (SHIELD), R9.2, R10.2, R11.2, R13.2

Notes on the sheet:
Pmod USB HS Single: USB 2.0 HS device on one Pmod (Gowin SoftPHY Single LVDS wiring without the D- comparator).
FPGA side: rtl/usb/gowin/usb_phy_gowin_sl.v with CMP1=1 (eda/pmod_usb_hs/SINGLE_PMOD.md). Arora-V (GW5A) values from TN710.
Pmod 1/7 DX_P/DX_N: LVCMOS33D bidirectional pair (transmit + differential receive), R6/R7 in series.
Pmod 2/8 D+ / VREF: LVDS25 input pair = D+ comparator (squelch). VREF = 3.3 V x 200 / 4900 = 135 mV.
Pmod 3/9 TERM_DP/DN: drive low = 45 ohm HS termination (pin + R2/R3), Hi-Z = FS line state input (LVCMOS33).
Pmod 4 PULLUP: high = 1.5k on D+ (FS attach). Pmod 10 VBUS_DET: VBUS / 1.67 (LVCMOS33 input).
UFP only: Rd 5.1k on CC1/CC2, VBUS is not used as a supply. Shield to GND.

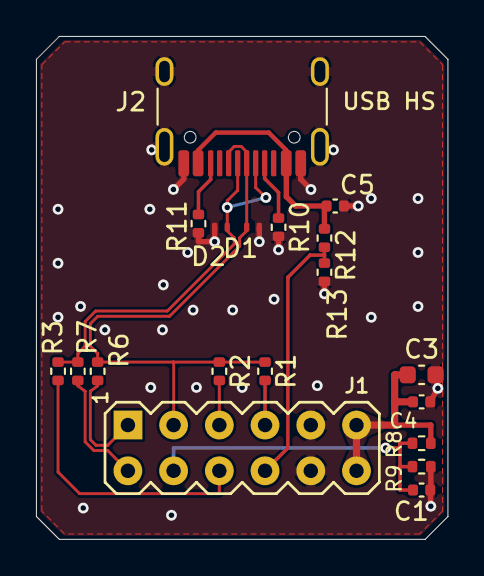
[picture p21: board Pmod_USB_HS_Single.kicad_pcb from above]

Board: 2 copper layers, 22.9 x 27.9 mm, 20 parts (1 on the bottom side), 14 nets.

Other parts of the board:
LOGO1: Logo_Open_Hardware_Small; logo
