ciniml/fpga_samples/eda/csi_capture/hw/Pmod_RPiCamera/Pmod_RPiCamera.kicad_pcb

## KiCad design eda/csi_capture/hw/Pmod_RPiCamera/Pmod_RPiCamera.kicad_pcb (2026-10-18)

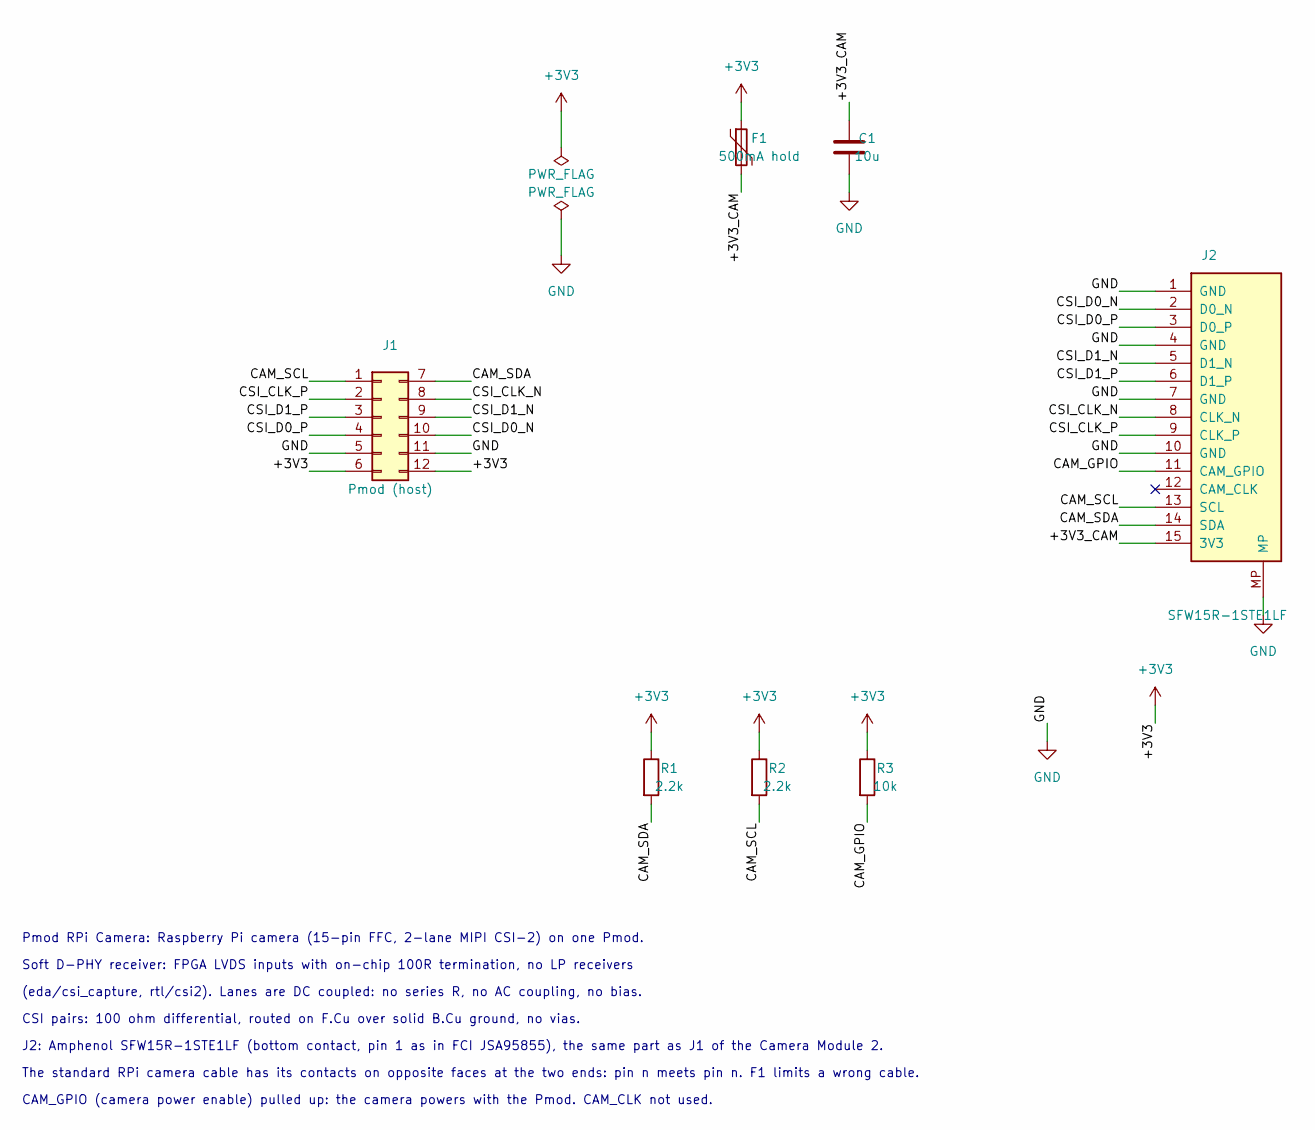
[picture p22: schematic Pmod_RPiCamera.kicad_sch, Pmod RPi Camera (MIPI CSI-2)]

Parts:
C1: 10u; C_0805_2012Metric; MPN Samsung CL21A106KAYNNNE; LCSC C15850
F1: 500mA hold; Fuse_0805_2012Metric; MPN RUILON SMD0805P050TF (alt. Littelfuse 0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; LCSC C20978
J1: Pmod (host); Conn_Pmod_Spec_B_Thin
J2: SFW15R-1STE1LF; Amphenol_SFW15R-1STE1LF_1x15-1MP_P1.0mm_Horizontal; MPN Amphenol ICC (FCI) SFW15R-1STE1LF; LCSC C3168538
R1, R2: 2.2k; R_0402_1005Metric; MPN UNI-ROYAL 0402WGF2201TCE; LCSC C25879
R3: 10k; R_0402_1005Metric; MPN UNI-ROYAL 0402WGF1002TCE; LCSC C25744

Connections:
+3V3: F1.1, J1.6, J1.12, R1.1, R2.1, R3.1
/+3V3_CAM: C1.1, F1.2, J2.15 (3V3)
/CAM_GPIO: J2.11 (CAM_GPIO), R3.2
/CAM_SCL: J1.1, J2.13 (SCL), R2.2
/CAM_SDA: J1.7, J2.14 (SDA), R1.2
/CSI_CLK_N: J1.8, J2.8 (CLK_N)
/CSI_CLK_P: J1.2, J2.9 (CLK_P)
/CSI_D0_N: J1.10, J2.2 (D0_N)
/CSI_D0_P: J1.4, J2.3 (D0_P)
/CSI_D1_N: J1.9, J2.5 (D1_N)
/CSI_D1_P: J1.3, J2.6 (D1_P)
GND: C1.2, J1.5, J1.11, J2.1 (GND), J2.4 (GND), J2.7 (GND), J2.10 (GND), J2.MP

Notes on the sheet:
CAM_GPIO (camera power enable) pulled up: the camera powers with the Pmod. CAM_CLK not used.
Pmod RPi Camera: Raspberry Pi camera (15-pin FFC, 2-lane MIPI CSI-2) on one Pmod.
CSI pairs: 100 ohm differential, routed on F.Cu over solid B.Cu ground, no vias.
(eda/csi_capture, rtl/csi2). Lanes are DC coupled: no series R, no AC coupling, no bias.
Soft D-PHY receiver: FPGA LVDS inputs with on-chip 100R termination, no LP receivers
The standard RPi camera cable has its contacts on opposite faces at the two ends: pin n meets pin n. F1 limits a wrong cable.
J2: Amphenol SFW15R-1STE1LF (bottom contact, pin 1 as in FCI JSA95855), the same part as J1 of the Camera Module 2.

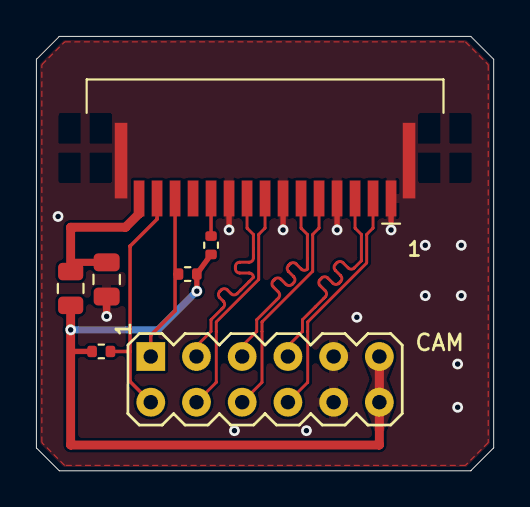
[picture p23: board Pmod_RPiCamera.kicad_pcb from above]

Board: 2 copper layers, 25.4 x 24.1 mm, 8 parts (1 on the bottom side), 12 nets.

Other parts of the board:
LOGO1: logo
