ciniml/fpga_samples/eda/dvi_hub75/hw/Pmod_StereoDAC/Pmod_StereoDAC.kicad_pcb

## KiCad design eda/dvi_hub75/hw/Pmod_StereoDAC/Pmod_StereoDAC.kicad_pcb (2026-10-20)

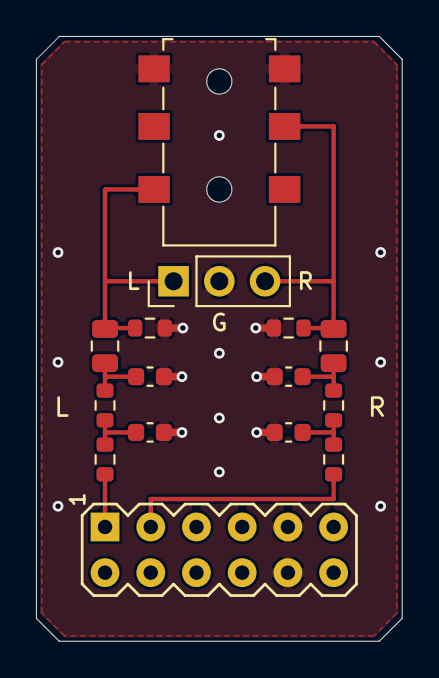
[picture p24: board Pmod_StereoDAC.kicad_pcb from above]

Board: 2 copper layers, 20.3 x 33.6 mm, 16 parts (1 on the bottom side), 9 nets.

Parts:
C1, C11: 3.3n; C_0603_1608Metric
C2, C12: 330p; C_0603_1608Metric
C3, C13: 1u; C_0805_2012Metric
J1: Pmod (host); Conn_Pmod_Spec_B_Thin
J2: PJ-313D; Jack_3.5mm_SHOUHAN_PJ-313D_Horizontal
J3: L / GND / R; PinHeader_1x03_P2.54mm_Vertical
LOGO1: logo
R1, R11: 1k; R_0603_1608Metric
R2, R12: 10k; R_0603_1608Metric
R3, R13: 100k; R_0603_1608Metric

Connections:
/AUDIO_L: J1.1, R1.1
/AUDIO_R: J1.2, R11.1
/L_F1: C1.1, R1.2, R2.1
/L_F2: C2.1, C3.1, R2.2
/L_OUT: C3.2, J2.T, J3.1, R3.1
/R_F1: C11.1, R11.2, R12.1
/R_F2: C12.1, C13.1, R12.2
/R_OUT: C13.2, J2.R, J3.3, R13.1
GND: C1.2, C2.2, C11.2, C12.2, J1.5, J1.11, J2.S, J3.2, R3.2, R13.2
