ciniml/fpga_samples/eda/pmod_100base_tx/kicad_magjack/pmod_100base_tx_magjack.kicad_pcb

## KiCad design eda/pmod_100base_tx/kicad_magjack/pmod_100base_tx_magjack.kicad_pcb (2026-10-19)

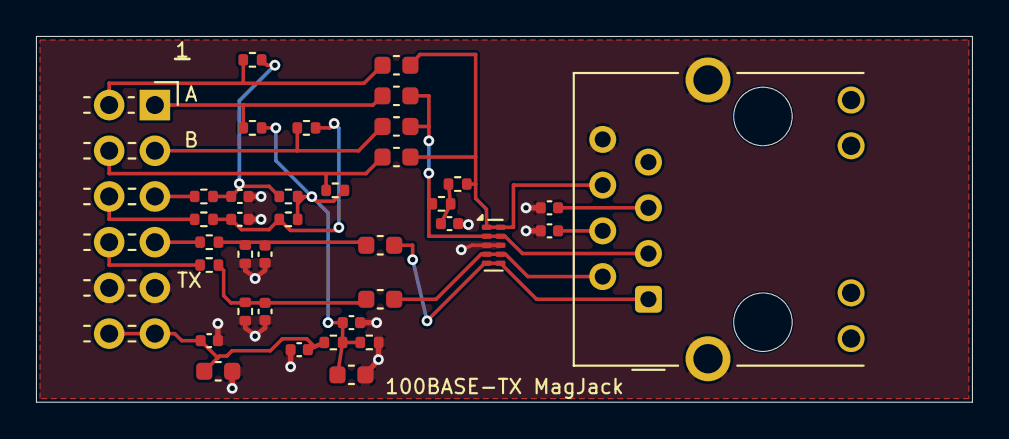
[picture p25: board pmod_100base_tx_magjack.kicad_pcb from above]

Board: 2 copper layers, 52.0 x 20.3 mm, 38 parts (1 on the bottom side), 22 nets.

Parts:
C1, C2: 47p; C_0402_1005Metric
C3, C4, C6, C7, C8, C9: 0.1u/50V; C_0603_1608Metric
C5: 10n; C_0402_1005Metric
C10, C14: 10u; C_0603_1608Metric
C11, C15, C16, C17, C18: 0.1u; C_0402_1005Metric
C12, C13: 1u; C_0402_1005Metric
J1: Pmod 2x6 R/A male; Pmod_Peripheral_2x06_P2.54mm_Horizontal
J2: HR911105A; RJ45_Hanrun_HR911105A_Horizontal
LOGO1: Logo_Open_Hardware_Small; logo
R1, R2: 62; R_0402_1005Metric
R3, R4: 120; R_0402_1005Metric
R7, R8: 49.9; R_0402_1005Metric
R9, R10, R11, R12: 2.2k; R_0402_1005Metric
R13: 330; R_0402_1005Metric
R14: 220; R_0402_1005Metric
R15, R17: 3.3k; R_0402_1005Metric
R16, R18: 1k; R_0402_1005Metric
U1: TPD4E02B04; USON-10_2.5x1.0mm_P0.5mm

Connections:
+3V3: C14.1, C15.1, C16.1, J1.6, J1.12, R13.1
/A_N: C7.2, J1.7, R10.1
/A_P: C6.2, J1.1, R9.1
/B_N: C9.2, J1.8, R12.1
/B_P: C8.2, J1.2, R11.1
/PWM_A: J1.3, R15.1
/PWM_B: J1.9, R17.1
/RCT: C18.1, J2.5
/RD_CT: C5.1, R7.2, R8.1
/RD_N: C7.1, C9.1, J2.6, R8.2, U1.1, U1.10
/RD_P: C6.1, C8.1, J2.3, R7.1, U1.2, U1.9
/TCT: C17.1, J2.4
/TD_N: C4.2, J2.2, U1.4, U1.7
/TD_P: C3.2, J2.1, U1.5, U1.6
/TXN_DRV: C2.1, C4.1, R2.2, R4.1
/TXP_DRV: C1.1, C3.1, R1.2, R3.1
/TX_N: J1.10, R2.1
/TX_P: J1.4, R1.1
/VB: C10.1, C11.1, R9.2, R12.2, R13.2, R14.1, R16.2, R18.2
/VTH_A: C12.1, R10.2, R15.2, R16.1
/VTH_B: C13.1, R11.2, R17.2, R18.1
GND: C1.2, C2.2, C5.2, C10.2, C11.2, C12.2, C13.2, C14.2, C15.2, C16.2, C17.2, C18.2, J1.5, J1.11, J2.8, J2.SH, R3.2, R4.2, R14.2, U1.3, U1.8
