ciniml/fpga_samples/eda/gowin_easycdr_sample/ExtEasyCDR.kicad_sch

## KiCad design eda/gowin_easycdr_sample/ExtEasyCDR.kicad_sch (2026-08-15)

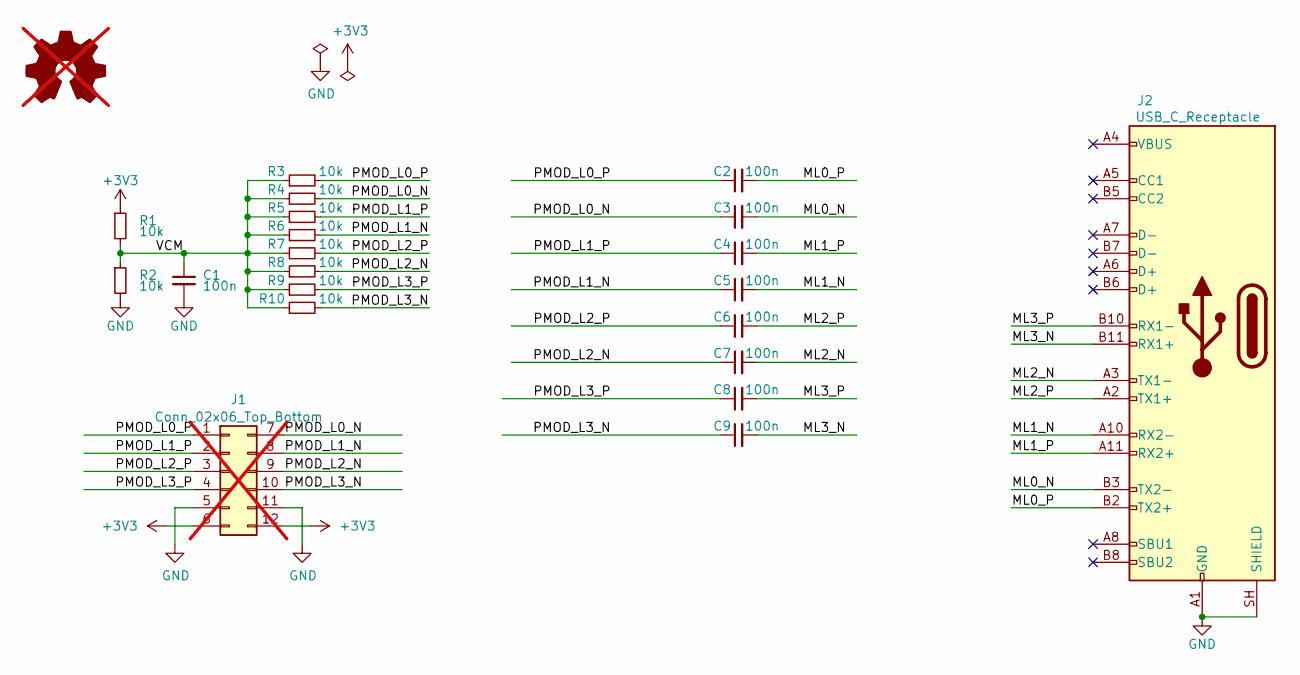
[picture p26: schematic ExtEasyCDR.kicad_sch]

Parts:
C1, C2, C3, C4, C5, C6, C7, C8, C9: 100n; C_0402_1005Metric; MPN CL05B104KB54PNC; LCSC C307331
J1: Conn_02x06_Top_Bottom; Conn_Pmod_Spec_B_Thin; not fitted
J2: USB_C_Receptacle; USB_C_Receptacle_Molex_105450-0101; MPN 1054500101; LCSC C134092
LOGO1: Logo_Open_Hardware_Small; logo; not fitted
R1, R2, R3, R4, R5, R6, R7, R8, R9, R10: 10k; R_0402_1005Metric; MPN 0402WGF1002TCE; LCSC C25744

Connections:
+3V3: J1.6, J1.12, R1.1
GND: C1.2, J1.5, J1.11, J2.A1 (GND), J2.A12 (GND), J2.B1 (GND), J2.B12 (GND), J2.SH (SHIELD), R2.2
ML0_N: C3.2, J2.B3 (TX2-)
ML0_P: C2.2, J2.B2 (TX2+)
ML1_N: C5.2, J2.A10 (RX2-)
ML1_P: C4.2, J2.A11 (RX2+)
ML2_N: C7.2, J2.A3 (TX1-)
ML2_P: C6.2, J2.A2 (TX1+)
ML3_N: C9.2, J2.B11 (RX1+)
ML3_P: C8.2, J2.B10 (RX1-)
unnamed: J2.A4 (VBUS), J2.A9 (VBUS), J2.B4 (VBUS), J2.B9 (VBUS)
PMOD_L0_N: C3.1, J1.7, R4.2
PMOD_L0_P: C2.1, J1.1, R3.2
PMOD_L1_N: C5.1, J1.8, R6.2
PMOD_L1_P: C4.1, J1.2, R5.2
PMOD_L2_N: C7.1, J1.9, R8.2
PMOD_L2_P: C6.1, J1.3, R7.2
PMOD_L3_N: C9.1, J1.10, R10.2
PMOD_L3_P: C8.1, J1.4, R9.2
VCM: C1.1, R1.2, R2.1, R3.1, R4.1, R5.1, R6.1, R7.1, R8.1, R9.1, R10.1
