ciniml/fpga_samples/eda/display_port_typec/src/tangprimer25k/top.sv

/**
 * @file top.sv
 * @brief Top module for the DisplayPort test-pattern-generator design
 *        on the Tang Primer 25K (Sipeed Pmod DP module).
 *
 *        Wires up the full DisplayPort source IP (`dp_source_top`) with a
 *        Gowin OSER10-based serializer for lane 0:
 *
 *          - AUX CH subsystem (Manchester-II via TLVDS_IOBUF)
 *          - HPD input (LVCMOS25)
 *          - Test pattern generator (rtl/video) → AXI-Stream pixel input
 *          - dp_source_top in CONTINUOUS_BYTE_TICK mode (one symbol per
 *            byte clock) → 10-bit encoder symbol → OSER10 → TLVDS_OBUF
 *
 *        Clocking (DP RBR = 1.62 Gbps target):
 *          gowin_pll_27 : 50 MHz board → 27 MHz (clock_27: CPU + AUX +
 *                         HPD + UART — the FemtoRV32 does not close
 *                         timing at the byte clock)
 *          gowin_pll    : 27 MHz → clock_byte (162 MHz, main-link
 *                                   datapath + TPG + OSER10 PCLK)
 *                                   clock_serial (810 MHz, OSER10 FCLK,
 *                                                 DDR → 1.62 Gbps)
 *          dp_source_top synchronizes the CPU control registers across
 *          the 27 MHz → 162 MHz boundary internally.
 *
 *        Video: CEA 720x480p59.94 half-rate (board firmware
 *        profile, `--features board`). The byte-rate framer makes the
 *        effective pixel clock LS_Clk/3 = 54 MHz, so the frame rate is
 *        exactly 60 Hz. The TPG is demand-paced through tpg_to_axis
 *        (raster advances only when the DP IP accepts a pixel during DE,
 *        free-runs through blanking), so no pixels are ever dropped.
 *
 *        Lanes 1..3 are unused (held low). For multi-lane operation
 *        replicate the OSER10 + TLVDS_OBUF block per lane.
 */
// Copyright 2026 Kenta IDA
// Distributed under the Boost Software License, Version 1.0.
//    (See accompanying file LICENSE_1_0.txt or copy at
//          http://www.boost.org/LICENSE_1_0.txt)

`default_nettype none
module top(
    input wire clock,
    input wire reset_button,

    // DisplayPort Main Link lanes
    output logic ml_lane_0_p,
    output logic ml_lane_0_n,
    output logic ml_lane_1_p,
    output logic ml_lane_1_n,
    output logic ml_lane_2_p,
    output logic ml_lane_2_n,
    output logic ml_lane_3_p,
    output logic ml_lane_3_n,

    inout wire logic aux_ch_p,
    inout wire logic aux_ch_n,

    // FUSB302B interrupt (unused: I2C polling). Kept as an input so
    // the pin stays high-Z.
    input wire int_n,

    // HD3SS460 controls (FW-driven via cpu_io_out). Open-drain: the
    // mux control pins are 3-level (H >= VCC-0.4 = 2.9V, M around
    // VCC/2, L <= 0.4V) so a 2.5V-bank push-pull high lands in an
    // undefined region; releasing the pin lets the board's 10k
    // pull-ups to 3.3V make a legal H.
    inout wire logic usb_sw_amsel,
    inout wire logic usb_sw_pol,
    inout wire logic usb_sw_en,

    // FUSB302B I2C (open-drain; board pull-ups to the 2.5V bank rail).
    inout wire logic i2c_sda,
    inout wire logic i2c_scl,

    output logic uart_tx,
    input  wire  uart_rx
);

    // -----------------------------------------------------------------
    // Clocking
    // -----------------------------------------------------------------
    logic clock_27;
    logic clock_byte;     // OSER10 PCLK; main-link byte clock (162 MHz)
    logic clock_serial;   // OSER10 FCLK = 5 × clock_byte (810 MHz)
    logic pll_lock;
    logic pll_lock_27;

    gowin_pll_27 pll_27 (
        .clkout0(clock_27),
        .lock   (pll_lock_27),
        .clkin  (clock)
    );
    gowin_pll pll_dp (
        .clkout0(clock_byte),
        .clkout1(clock_serial),
        .lock   (pll_lock),
        .clkin  (clock_27)
    );

    // -----------------------------------------------------------------
    // Resets
    // -----------------------------------------------------------------
    logic reset_27;
    reset_seq reset_seq_27 (
        .clock   (clock_27),
        .reset_in(!pll_lock_27 || !pll_lock || reset_button),
        .reset_out(reset_27)
    );
    logic reset_byte;
    reset_seq #(.RESET_DELAY_CYCLES(4)) reset_seq_byte (
        .clock   (clock_byte),
        .reset_in(!pll_lock_27 || !pll_lock || reset_button),
        .reset_out(reset_byte)
    );

    // -----------------------------------------------------------------
    // Test pattern generator, demand-paced on the byte clock: the active
    // area matches the firmware board profile (1920x1080, CEA 1080p60,
    // RBR x4); the TPG's own
    // blanking is kept minimal since tpg_to_axis stalls the raster
    // whenever the DP IP is not accepting pixels (the DP raster timing
    // lives in the firmware MSA profile, not here).
    // -----------------------------------------------------------------
    localparam int HSYNC   = 8;
    localparam int HBACK   = 8;
    localparam int HACTIVE = 1920;
    localparam int HFRONT  = 8;
    localparam int VSYNC   = 2;
    localparam int VBACK   = 2;
    localparam int VACTIVE = 1080;
    localparam int VFRONT  = 2;

    logic [23:0] tpg_video_data;
    logic        tpg_video_de;
    logic        tpg_video_hsync;
    logic        tpg_video_vsync;
    logic        tpg_enable;

    // Hold the TPG at its frame origin until the DP pixel FIFOs start
    // accepting (they stay cleared while video is off), so the first
    // pixel the framer consumes is pixel (0,0).
    logic tpg_reset;
    always_ff @(posedge clock_byte) begin
        tpg_reset <= reset_byte || !video_active;
    end

    test_pattern_generator #(
        .HSYNC  (HSYNC),
        .HBACK  (HBACK),
        .HACTIVE(HACTIVE),
        .HFRONT (HFRONT),
        .VSYNC  (VSYNC),
        .VBACK  (VBACK),
        .VACTIVE(VACTIVE),
        .VFRONT (VFRONT),
        .BOUNCE_LOGO(1),
        .LOGO_PATH  ("/home/kenta/repos/fpga_samples/eda/display_port_tpg/src/cq_logo.hex"),
        .LOGO_WIDTH (250),
        .LOGO_HEIGHT(50),
        .LOGO_COLOR (24'h000000)
    ) tpg_inst (
        .clock     (clock_byte),
        .reset     (tpg_reset),
        .enable    (tpg_enable),
        .video_data(tpg_video_data),
        .video_de  (tpg_video_de),
        .video_hsync(tpg_video_hsync),
        .video_vsync(tpg_video_vsync)
    );

    logic        pix_tvalid;
    logic        pix_tready;
    logic [23:0] pix_tdata;

    tpg_to_axis tpg_axis (
        .clock        (clock_byte),
        .reset        (tpg_reset),
        .video_data   (tpg_video_data),
        .video_de     (tpg_video_de),
        .tpg_enable   (tpg_enable),
        .m_axis_tvalid(pix_tvalid),
        .m_axis_tready(pix_tready),
        .m_axis_tdata (pix_tdata)
    );

    // -----------------------------------------------------------------
    // AUX CH differential I/O.
    // -----------------------------------------------------------------
    logic aux_ch_in_drv;
    logic aux_ch_out;
    logic aux_ch_out_enable;

    TLVDS_IOBUF aux_ch_lvds_iobuf (
        .I  (aux_ch_out),
        .OEN(!aux_ch_out_enable),
        .O  (aux_ch_in_drv),
        .IO (aux_ch_p),
        .IOB(aux_ch_n)
    );

    // -----------------------------------------------------------------
    // DisplayPort source IP. CONTINUOUS_BYTE_TICK = 1 makes the encoder
    // emit one symbol per clock_byte cycle, exactly matching OSER10's
    // PCLK consumption rate.
    // -----------------------------------------------------------------
    localparam int CLOCK_HZ_BYTE = 162_000_000;
    localparam int CLOCK_HZ_SYS  = 27_000_000;

    logic [31:0] cpu_io_out;

    // HD3SS460 control GPIOs (see typec.rs): bit24 = EN, bit25 = POL,
    // bit27 = AMSEL. Default low via the FW reset value of cpu_io_out.
    // Explicit IOBUFs (OEN=1 releases the pad) — the tristate must not
    // depend on inference; the synthesized netlist is encrypted so an
    // inference failure would be invisible.
    IOBUF u_iob_usb_sw_en    (.O(), .IO(usb_sw_en),    .I(1'b0), .OEN(cpu_io_out[24]));
    IOBUF u_iob_usb_sw_pol   (.O(), .IO(usb_sw_pol),   .I(1'b0), .OEN(cpu_io_out[25]));
    IOBUF u_iob_usb_sw_amsel (.O(), .IO(usb_sw_amsel), .I(1'b0), .OEN(cpu_io_out[27]));

    // I2C open-drain pads.
    logic i2c_scl_oen;
    logic i2c_sda_oen;
    assign i2c_scl = i2c_scl_oen ? 1'bz : 1'b0;
    assign i2c_sda = i2c_sda_oen ? 1'bz : 1'b0;

    wire _unused_int_n = int_n;

    logic       loader_rx_tvalid;
    logic       loader_rx_tready;
    logic [7:0] loader_rx_tdata;

    logic        debug_serial_tvalid;
    logic        debug_serial_tready;
    logic [7:0]  debug_serial_tdata;

    logic        lane0_bit;
    logic        lane0_bit_valid;
    logic        lane0_symbol_valid;
    logic [9:0]  lane0_symbol;
    logic [9:0]  lane1_symbol;
    logic [9:0]  lane2_symbol;
    logic [9:0]  lane3_symbol;
    logic        video_active;

    displayport_dp_source_top #(
        .CLOCK_HZ           (CLOCK_HZ_SYS),
        .MANCHESTER_CLOCK_HZ(32'd1_000_000),
        .PRECHARGE_CYCLES   (32'd16),
        .BUFFER_SIZE        (256),
        .DEBUG_OUT          (1'b0),
        .PROCESSOR_ID       (32'd0),
        .PROCESSOR_ROM_SIZE (32'd16384),
        .PROCESSOR_RAM_SIZE (32'd8192),
        .PROCESSOR_ROM_FILE ("/home/kenta/repos/fpga_samples/rtl/displayport/test/sw-rs/bootrom-rs-typec.hex"),
        .SR_PERIOD          (32'd512),
        .CONTINUOUS_BYTE_TICK(32'd1),
        // This board runs 1-lane (480p fallback) or 4-lane (1080p60);
        // drop the 2-lane FIFO to relieve 162 MHz congestion.
        .ENABLE_LANES2      (32'd0)
    ) dp_source (
        .i_clk (clock_byte),
        .i_rstn(!reset_byte),
        .i_clk_sys (clock_27),
        .i_rstn_sys(!reset_27),

        .aux_ch_in        (aux_ch_in_drv),
        .aux_ch_out       (aux_ch_out),
        .aux_ch_out_enable(aux_ch_out_enable),

        // No physical HPD on the Type-C board: HPD arrives as a PD
        // Attention VDM and enters via the virtual-HPD register.
        .hpd_in           (1'b0),

        .i2c_scl_oen      (i2c_scl_oen),
        .i2c_sda_oen      (i2c_sda_oen),
        .i2c_sda_in       (i2c_sda),

        .cpu_io_out       (cpu_io_out),

        .saxis_serial_in_tvalid(loader_rx_tvalid),
        .saxis_serial_in_tready(loader_rx_tready),
        .saxis_serial_in_tdata (loader_rx_tdata),

        .maxis_serial_out_tvalid(debug_serial_tvalid),
        .maxis_serial_out_tready(debug_serial_tready),
        .maxis_serial_out_tdata (debug_serial_tdata),

        // Behavioural serializer outputs are unused on the FPGA path.
        .o_lane0_bit         (lane0_bit),
        .o_lane0_bit_valid   (lane0_bit_valid),

        // Drive OSER10 from the encoder's 10-bit symbol.
        .o_lane0_symbol_valid(lane0_symbol_valid),
        .o_lane0_symbol      (lane0_symbol),
        .o_lane1_symbol      (lane1_symbol),
        .o_lane2_symbol      (lane2_symbol),
        .o_lane3_symbol      (lane3_symbol),
        .o_video_enable      (video_active),

        .s_axis_video_tvalid(pix_tvalid),
        .s_axis_video_tready(pix_tready),
        .s_axis_video_tdata (pix_tdata)
    );

    // -----------------------------------------------------------------
    // OSER10 + LVDS output per lane. Bit rate = 10 x clock_byte =
    // 1.62 Gbps. The 2N-symbol inter-lane skew is applied inside
    // dp_source_top; the four serializers share PCLK/FCLK.
    // -----------------------------------------------------------------
    wire lane0_serial;
    wire lane1_serial;
    wire lane2_serial;
    wire lane3_serial;

    oser10_lane lane0_serdes (
        .i_pclk        (clock_byte),
        .i_fclk        (clock_serial),
        .i_reset       (reset_byte),
        .i_symbol_valid(lane0_symbol_valid),
        .i_symbol      (lane0_symbol),
        .o_serial      (lane0_serial)
    );
    oser10_lane lane1_serdes (
        .i_pclk        (clock_byte),
        .i_fclk        (clock_serial),
        .i_reset       (reset_byte),
        .i_symbol_valid(lane0_symbol_valid),
        .i_symbol      (lane1_symbol),
        .o_serial      (lane1_serial)
    );
    oser10_lane lane2_serdes (
        .i_pclk        (clock_byte),
        .i_fclk        (clock_serial),
        .i_reset       (reset_byte),
        .i_symbol_valid(lane0_symbol_valid),
        .i_symbol      (lane2_symbol),
        .o_serial      (lane2_serial)
    );
    oser10_lane lane3_serdes (
        .i_pclk        (clock_byte),
        .i_fclk        (clock_serial),
        .i_reset       (reset_byte),
        .i_symbol_valid(lane0_symbol_valid),
        .i_symbol      (lane3_symbol),
        .o_serial      (lane3_serial)
    );

    TLVDS_OBUF lane0_obuf (
        .I (lane0_serial),
        .O (ml_lane_0_p),
        .OB(ml_lane_0_n)
    );
    TLVDS_OBUF lane1_obuf (
        .I (lane1_serial),
        .O (ml_lane_1_p),
        .OB(ml_lane_1_n)
    );
    TLVDS_OBUF lane2_obuf (
        .I (lane2_serial),
        .O (ml_lane_2_p),
        .OB(ml_lane_2_n)
    );
    TLVDS_OBUF lane3_obuf (
        .I (lane3_serial),
        .O (ml_lane_3_p),
        .OB(ml_lane_3_n)
    );

    // -----------------------------------------------------------------
    // UART bootloader input. Bytes from the host feed the serial FW
    // loader inside the AUX subsystem (magic header 5A A5 5B).
    // -----------------------------------------------------------------
    uart_rx #(
        .NUMBER_OF_BITS(8),
        .BAUD_DIVIDER(CLOCK_HZ_SYS / 32'd115_200)
    ) loader_uart_rx_inst (
        .clock(clock_27),
        .reset(reset_27),

        .data_valid(loader_rx_tvalid),
        .data_ready(loader_rx_tready),
        .data_bits (loader_rx_tdata),

        .rx        (uart_rx),
        .overrun   ()
    );

    // -----------------------------------------------------------------
    // UART debug bridge. Firmware $write goes out the byte-serial
    // interface; route it to the on-board UART pad.
    // -----------------------------------------------------------------
    uart_tx #(
        .NUMBER_OF_BITS(8),
        .BAUD_DIVIDER(CLOCK_HZ_SYS / 32'd115_200)
    ) debug_uart_tx_inst (
        .clock(clock_27),
        .reset(reset_27),

        .data_valid(debug_serial_tvalid),
        .data_ready(debug_serial_tready),
        .data_bits (debug_serial_tdata),

        .tx        (uart_tx)
    );

endmodule
`default_nettype wire
