ciniml/fpga_samples/eda/ethernet_icmp/src/tangnano9k_matrix_led/top.sv

/**
 * @file top.sv
 * @brief Top module for ethernet ICMP echo reply system.
 */
// Copyright 2022 Kenta IDA
// Distributed under the Boost Software License, Version 1.0.
//    (See accompanying file LICENSE_1_0.txt or copy at
//          http://www.boost.org/LICENSE_1_0.txt)

`default_nettype none
module top(
    input wire clock,

    // Input button
    input wire button_s2,
    // Output LED
    output logic [5:0] led,

    // RMII PHY interface
    input  wire        rmii_txclk,
    input  wire  [1:0] rmii_rxd,
    input  wire        rmii_crs_dv,
    output logic [1:0] rmii_txd,
    output logic       rmii_txen,
    input  wire        rmii_mdio,
    output logic       rmii_mdc,

    // Matrix LED
    output logic [7:0] anode,
    output logic [7:0] cathode
);

logic [2:0] reset_button = '1;
always_ff @(posedge rmii_txclk) begin
  reset_button <= {1'b0, reset_button[2:1]};
end

logic reset;
reset_seq reset_seq_ext(
  .clock(rmii_txclk),
  .reset_in(reset_button[0]),
  .reset_out(reset)
);

assign rmii_mdc = 0;

logic [7:0] tx_saxis_tdata;
logic       tx_saxis_tvalid;
logic       tx_saxis_tready;
logic       tx_saxis_tlast;

logic [7:0] rx_maxis_tdata;
logic       rx_maxis_tvalid;
logic       rx_maxis_tready;
logic       rx_maxis_tlast;
logic       rx_maxis_tuser;

logic [7:0] gpio_in;
logic [8 + 64 - 1:0] gpio_out;
assign gpio_in = 8'h5a | button_s2;
assign led = gpio_out[8 +: 6];

rmii_mac rmii_mac_inst (
  .tx_clock(rmii_txclk),
  .tx_reset(reset),
  .tx_rmii_d(rmii_txd),
  .tx_rmii_en(rmii_txen),
  .rx_clock(rmii_txclk),
  .rx_reset(reset),
  .rx_rmii_d(rmii_rxd),
  .rx_rmii_dv(rmii_crs_dv),
  .tx_saxis_bypass_tdata(0),
  .tx_saxis_bypass_tvalid(0),
  .tx_saxis_bypass_tready(),
  .tx_saxis_bypass_tlast(0),
  .*
);

EthernetSystem ethernet_system_isnt (
  .clock(rmii_txclk),
  .aresetn(!reset),
  .in_tdata (rx_maxis_tdata),
  .in_tvalid(rx_maxis_tvalid),
  .in_tready(rx_maxis_tready),
  .in_tlast (rx_maxis_tlast),
  .out_tdata (tx_saxis_tdata),
  .out_tvalid(tx_saxis_tvalid),
  .out_tready(tx_saxis_tready),
  .out_tlast (tx_saxis_tlast),
  .gpio_in(gpio_in),
  .gpio_out(gpio_out)
);


// 8bit ビット反転 bit[0] -> bit[7], bit[1] -> bit[6], ...
function automatic logic [7:0] bitreverse8(input logic [7:0] in);
  for(int i = 0; i < 8; i++) bitreverse8[7-i] = in[i];
endfunction

logic [7:0] data[7:0];  // マトリクスLED出力信号
logic [7:0] row, col;   // 行出力、列出力
assign anode   = col;
assign cathode = ~row;

for(genvar i = 0; i < 8; i++) begin: map_data_gen
  assign data[i] = bitreverse8(gpio_out[(i+1)*8 +: 8]);
end

// マトリクスLED制御モジュール
matrix_led_driver matrix_led_inst_0 (
  .clk  (rmii_txclk),
  .data (data),
  .row  (row),
  .col  (col)
);

// マトリクスLEDドライバ、タイマーモジュールは基礎編3章とdataの持ち方以外は同じ
module matrix_led_driver (
  input  wire       clk,
  input  wire [7:0] data[7:0],
  output wire [7:0] row,
  output wire [7:0] col
);

  logic [2:0] row_cnt = 'd0;
  logic       overflow;

  assign row = 'b00000001 << row_cnt;
  assign col = {data[row_cnt][7], // CPUとの接続が容易になるように
                data[row_cnt][6], // data[行][列] の順に変更
                data[row_cnt][5],
                data[row_cnt][4],
                data[row_cnt][3],
                data[row_cnt][2],
                data[row_cnt][1],
                data[row_cnt][0]};

  always_ff @ (posedge clk) begin
    if (overflow) begin
      row_cnt <= row_cnt + 'd1;
    end
  end

  timer #(
    .COUNT_MAX (50000)
  ) inst_0 (
    .clk      (clk),
    .overflow (overflow)
  );

endmodule

module timer #(
  parameter COUNT_MAX = 50000000
) (
  input  wire  clk,
  output logic overflow
);

  logic [$clog2(COUNT_MAX+1)-1:0] counter = 'd0;

  always_ff @ (posedge clk) begin
    if (counter == COUNT_MAX) begin
      counter  <= 'd0;
      overflow <= 'd1;
    end else begin
      counter  <= counter + 'd1;
      overflow <= 'd0;
    end
  end

endmodule

endmodule
`default_nettype wire
