ciniml/fpga_samples/(commit log)

2021-08-18 Add UART
2021-08-19 Add SystemVerilog implementation of UART.
2021-08-21 Add I2C
2021-08-29 Add debounce filter and example.
2021-08-29 Fix debouncer. Fix IO constraint for DIP SW of Runber to disable pull up resisters, which causes DIP SW input always high.
    [debounce.sv, top.sv]
2021-09-02 Add Timer Counter modules and modify debounce_filter to use the TC.
2021-09-02 Add segment LED driver.
2021-09-04 Add I2C Slave Example
2021-12-15 Add stepper motor emulator for Gowin RUNBER.
2022-05-07 Implement Y axis backward transfer mode in StreamReader/Writer.
2022-05-16 Add matrix led example for TangNano9K with ComProc board rev.2
2022-05-16 Insert guard time when switching row driver of matrix LED.
2022-05-16 Implement SPI Master in Chisel
2022-05-16 Add LifeGame with FRAM board persistency.
2022-05-16 Add missing source codes
    [top.sv]
2022-05-17 Add RISC-V Book Matrix LED example
2022-07-07 Implement factory test design for ComProc CPU Board Rev.2.1
2022-10-02 Add matrix LED CPU example.
2022-10-02 Fix Makefile for matrix led project is missing
2022-10-20 Add LED matrix project
2022-11-07 Fix ethernet service to add padding when the frame length is not enough.
2022-11-14 Add Ethernet UDP design to control matrix LED. Fix taht tangprimer20k target is missing.
    [top.sv]
2023-03-04 Add pmod pin mapper
2023-03-04 Add tangnano9k_pmod target for cpu_matrix_led project.
    [pmod_pins.csv, pmod_ports.csv]
2023-03-07 Add Tang Primer 20K Pmod sample.
    [pmod_ports.csv]
2023-03-28 Add HUB75 PMOD module
    [pmod_pins.csv, pmod_ports.csv]
2023-06-10 Add Pmod multisegment LED
    [pmod_pins.csv]
2023-06-10 Add Tang Nano 20K support
    [pmod_ports.csv]
2023-06-16 Implement OE based PWM for HUB75 Controller for high refresh rate.
2023-06-24 Add Ethernet system implementation for TangNano9K with Pmod base board.
    [pmod_ports.csv]
2023-09-23 Add udpaudio and probedec utils
2023-10-29 Add debug probe
2023-10-30 Fix udpaudiosend to fill the buffer to full from stdin to avoid short UDP packet.
    [main.rs]
2023-11-13 Add XLS audio filter and mixer source.
2023-12-01 Add turn table and stepper modules.
    [pmod_pins.csv]
2024-03-07 Add DVI Full HD 60FPS example for Tang Primer 25K
    [pmod_pins.csv]
2024-09-06 Add 128x128 RGB332 HUB75 support.
    [pmod_pins.csv]
2025-08-14 Add probe implementation
2025-08-24 Add SPI slave veryl module
2025-08-30 implement SPI master
2025-09-03 Basic SPI slave implementation (not tested)
2025-09-04 Add different clock tests for SPI slave
2025-09-04 Add randomized test for SPI slave
2025-09-07 Refactory SPI test bench
2025-09-14 Fix SPI slave comments
2025-09-16 Add AXI Stream Mux/Demux, implement VRAM to display_controller sample design
2025-09-21 Fix VRAM writer complete signal to be cleared after one cycle.
    [convert_image_to_rgb332.py, display_controller_host.cpp, image.h]
2025-09-25 Adjust SPI clock speed to 60 MHz and add pixel writing functionality; update pin assignments and timing constraints.
2025-09-25 Add TUSER skip test case to video signal generator; update Makefile to include new test case
2026-02-23 Repository cleanup: Improve .gitignore and add documentation
    - Expand .gitignore to cover more build artifacts and tool outputs
    - Add EDA generated files (*.cst, *.gen.svh, ip/*, impl/)
    - Add tool logs and traces (*.str, vivado_pid*, hs_err_pid*)
    - Add archive files (*.tar.gz, *.zip)
    - Add IDE files (.devcontainer, .vscode-ctags)
    - Add analyzer files (*.analyzer_prj, *.xml)
    - Add repository cleanup documentation
    - doc/REPOSITORY_CLEANUP_PLAN.md: Overall cleanup strategy
    - doc/BRANCH_ANALYSIS.md: Branch analysis and merge recommendations
    - Remove unnecessary files from root
    - Delete xls.tar.gz (132MB)
    - Delete y2k22_patch-1.2.zip
    - Delete uart_test.fs
    - Delete vivado_p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
2026-02-23 Improve display_controller SPI communication with response validation
    - Reduce SPI clock speed from 60 MHz to 1 MHz for stability
    - Add response validation using GPIO 20 as RESPONSE_OK pin
    - Add dummy bytes to receive response from each command
    - Check response codes: 0x20 (FILL_RECT), 0x30 (WRITE_BLOCK), 0x40 (WRITE_PIXEL)
    - Change error handling from panic to return for better recovery
    - Clean up code formatting and comments
    [display_controller_host.cpp]
2026-02-23 Add untracked projects and improve .gitignore
    Added projects:
    - EDA projects: fpga_debug_probe, fpga_performance, gowin_easycdr_sample
    - EDA projects: display_port_tpg, dram_test, cpu_usb, pmod_dp_test
    - EDA projects: segled_chisel, serv_stopwatch, stp_emu
    - Board variants: ethernet_video boards, turn_table boards
    - RTL modules: displayport, ethernet (xg_mac, xgmii_axis), serv_soc
    - Utilities: hls_fft, riscv_cpu, xls, scripts
    - External libraries: gcem, serv
    Documentation added:
    - doc/figure/ws2812b diagrams
    - doc/synthesize_gowin_from_cli.md
    - Various README files
    .gitignore improvements:
    - Add Chisel generated files (*.anno.json, *.fir)
    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
    [pmod_pins.csv, pmod_ports.csv]
2026-07-03 Fix DP source spec-conformance issues found by review against DP 1.2
    Verification pass against the DP 1.2 spec (doc/roadmap.md section 9):
    - scrambler: use the App E Galois LFSR (0xFFFF -> 0xE817), advance on
    K symbols too, and reset only on SR (not on every BS)
    - control symbols: FS=K30.7, FE=K23.7, SE=K29.7 per Table 3-15
    (K28.4/K28.7 are reserved, K28.3 is BF)
    - msa_generator: Fig 2-18 39-symbol 1-lane layout with Mvid sent 4x
    - video_framer: transport (VB-ID, Mvid, Maud) x4 after BS, idle
    VB-ID = 0x09, MSA window moved accordingly
    - firmware: MISC0 = 0x21 (sync clock, 8 bpc RGB)
    - tests: new scrambler golden test from the App E reference code,
    Fig 2-18 golden MSA vector, VB-ID x4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
    [main.rs]
2026-07-03 Implement D.x.A7 alternate encoding in the 8B/10B encoder/decoder
    ANSI 8B/10B requires the alternate .7 sub-block (0111/1000) for
    D11/13/14.7 entering RD+ and D17/18/20.7 entering RD-; the encoder
    previously always emitted the primary form, producing six non-standard
    symbol values on the wire. Since scrambled data hits all byte values,
    this also made the sink's comma aligner fragile: a spec sink (and our
    sink model) can false-lock on comma-like windows spanning such symbols.
    The decoder now accepts alternate-form .7 symbols as well.
    Tests: golden vectors for all six codes at both entry disparities, an
    alternate-form decode check, and a serialized run-length (<= 5)
    assertion sweeping all 256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
2026-07-03 Classify HPD low-pulse widths (IRQ_HPD vs unplug)
    Per DP 1.2 section 3.3 / Table 3-4: a debounced low pulse shorter than
    2 ms is an IRQ_HPD event (sink interrupt request), a low period
    reaching 2 ms is an unplug. Thresholds are now derived from CLOCK_HZ
    instead of a fixed 16-cycle debounce; the ~10 us glitch filter is a
    separate parameter so tests can shrink it. REG_SYSTEM_HPD gains a
    W1C sticky IRQ bit (bit 3). New tb_hpd_detect covers plug, glitch,
    0.6 ms IRQ, 2 ms boundary and unplug cases.
2026-07-13 Add self-checking Veryl tests for the debug probe and fix port bugs
    rtl/util/probe predated the per-directory Veryl projects (no Veryl.toml;
    the stale generated SV and legacy tb_probe.sv referenced the old
    fpga_samples_ prefix and a removed axi4s interface), so it had never
    been built or tested against the current tree. Set it up as a project
    depending on interfaces/axi4s and port the testbench to Veryl tests:
    - probe_capture: counter input, three capture rounds verifying the exact
    window position (TRIGGER_POSITION samples before the trigger sample,
    per the Chisel reference), tlast on the final beat, re-arming, an
    early trigger pulse during the pre-trigger fill, and both randomized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
2026-07-16 Prepare the Tang Primer 25K DP board design for bring-up
    - New E2E test dp_source_top_cont covers the CONTINUOUS_BYTE_TICK = 1
    (OSER10) path: the sink consumes the 10-bit symbol output directly
    (decoder + descrambler, no bit aligner) and verifies 3 bit-exact
    frames with zero 8B/10B code errors — this path was previously
    untested despite being the one the FPGA build uses
    - firmware: `board` cargo feature selects a monitor-viable profile:
    800x600 active in a 1200x750 raster; with the byte-rate framer the
    effective pixel clock is LS_Clk/3 = 54 MHz, giving exactly 60 Hz;
    synchronous clock mode with the exact static ratio Mvid/Nvid = 1/3
    (small static M/N is explicitly allowed b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
    [main.rs, oser10_lane.sv, test_pattern_generator.sv, top.sv, tpg_to_axis.sv]
2026-07-16 Close 162 MHz timing on the main-link datapath
    Iterative retiming of the per-byte paths, verified against the full
    test suite (15/15) at every step. Link-domain Fmax progression:
    75.4 -> 90.3 -> 111.0 -> 124.8 -> 151.2 -> 160.1 -> 162.1 MHz
    (GW5A-25 slow corner; all setup paths now have positive slack, and
    clock_27 closes at 29.9 / 27 required).
    - video_framer: all window predicates become registered look-ahead
    flags maintained by set/hold/clear rules on EQUALITY compares of the
    current position against registered (boundary - 1) constants — no
    increment adder and no magnitude compare in per-byte paths; the
    header byte phase is a 2-bit counter instead of a modulo; derived
    constan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
2026-07-20 Add AUX failure diagnostics to the firmware for board bring-up
    First hardware boot reached HPD detect but every AUX transaction
    failed (silent phase-A failure + "link training failed: DpcdRead").
    To classify the failure from the UART log alone:
    - dpcd: transactions now return a detailed DpcdError (Timeout /
    Protocol / Nack / DeferExhausted) instead of ()
    - link_training: Error::DpcdRead/DpcdWrite carry that detail
    - aux: expose rx_count() — on a timeout, 0 means the sink never
    answered (electrical / AUX polarity suspect) while >0 means bytes
    arrived but the reply could not be decoded (RX robustness)
    - main: the initial DPCD read retries 10 times at ~10 ms intervals
    (real monitors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
    [main.rs]
2026-07-20 Gate the AUX RX input while driving the pair
    On the Tang Primer 25K + Pmod DP hardware, the first AUX transaction
    failed with Protocol (rx_count=4): the TLVDS_IOBUF feeds our own
    transmission back into aux_ch_in, so the armed receiver decoded the
    4-byte read-request header as the "reply". Force the RX input to the
    idle level while aux_ch_out_enable is asserted. Simulation testbenches
    wire only the peer's output, so behavior there is unchanged (all 15
    tests still pass).
2026-07-20 Add a post-training link-status monitor to the bring-up FW
    Training completes on the real monitor but no picture is shown yet.
    After enabling the video pipeline, poll DPCD 200h-205h about once a
    second and print a decoded line (CR/EQ/SYM/ALIGN plus SINK_STATUS
    RECEIVE_PORT_0_STATUS) on change and as a 10 s heartbeat. This splits
    the failure into link-quality loss vs the sink rejecting the stream
    formatting.
    [main.rs]
2026-07-20 Send the MSA once per frame instead of on every vblank line
    On the real monitor the link stays fully trained (CR/EQ/SYM/ALIGN all
    set) and SINK_STATUS reports in-sync, but no picture appears. One known
    spec deviation fits that signature: the framer emitted the MSA on every
    vblank line (150 copies/frame on the board raster), while DP 1.2
    section 2.2.4 specifies one MSA per frame during vertical blanking.
    Gate the MSA trigger with a registered once-per-frame line flag
    (line 1, right after the VSync leading edge); the mux already falls
    back to 0x00 stuffing when the MSA generator is idle.
    All 15 tests pass; clock_byte closes at 163.082 MHz (>= 162).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
2026-07-20 Use the conventional Nvid=0x8000 in the board video profile
    Sink TCONs commonly assume the fixed synchronous-mode Nvid of 0x8000
    when regenerating the pixel clock; the previous minimal ratio 1/3 may
    be rejected or misinterpreted. Mvid = round(0x8000/3) = 0x2AAB, ~+30
    ppm, absorbed by the sink's elastic buffer.
    [main.rs]
2026-07-20 Report the lane-0 symbol error count in the status monitor
    Training success is intermittent and the picture never appears even
    though the link reports fully trained and in-sync. Poll DPCD 210h-211h
    each cycle: a trained link that keeps accumulating symbol errors points
    at an electrical problem, a clean zero points at stream formatting.
    [main.rs]
2026-07-20 Bring up the UART firmware loader (no resynthesis for FW changes)
    The serial bootloader existed but was dead logic. Make it usable:
    - stream_memory_access: advance the address byte counter (the FSM
    never left the ADDRESS state), assemble the address LSB-first with a
    shift instead of overwriting the low byte, wait one cycle after each
    mem_rreq for the registered read data, and assert tready in IDLE so
    a held-until-ready upstream (uart_rx) is not double-consumed.
    A new self-checking test covers the full command protocol.
    - aux_ch_subsystem: wire the external serial input to the loader and
    mux the serial output between the loader (while it holds the CPU in
    reset) and the CPU cons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
    [top.sv]
2026-07-20 Add EDID dump and link-training retry to the bring-up FW
    The link runs with zero symbol errors after training but the Philips
    242P6V reports "no video input": its EDID declares continuous
    frequency unsupported, so the nonstandard 800x600 raster (54 MHz,
    45 kHz) is rejected. The CEA extension block lists 27 MHz modes
    (720x480p59.94 / 720x576p50) — 162/27 = 6, so half-filled TUs
    (tu_active=32) can carry a real CEA mode; that is the next step.
    - edid.rs: EDID read over I2C-over-AUX, base + extension block
    - main.rs: dump both EDID blocks; retry training up to 5 times
    (EQ is marginal and the sink AUX can be slow right after the I2C
    burst; observed EqFailed then success on the next attempt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
    [main.rs]
2026-07-20 Add a half-rate pixel mode and switch the board to CEA 720x480p59.94
    The Philips 242P6V declares continuous-frequency unsupported and only
    accepts modes from its EDID tables; the 54 Mpix 800x600 raster was
    rejected ("no video input" with a fully-trained, zero-error link).
    Its CEA extension block lists the 27 MHz modes, and 162/27 = 6, so a
    half-rate mode fits the byte-rate architecture exactly.
    - video_framer: i_half_rate input — 1 pixel = 6 link symbols, line =
    htotal*6 symbols, TU region sized to consume exactly hwidth*3 bytes
    with tu_active=32 (floor(B/32) full TUs + truncated tail per
    §2.2.1.4; the remainder shifts BE later, which is invisible to the
    sink since timing is reco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
    [main.rs, top.sv]
2026-07-20 Make the framer line accounting FW-programmable
    Replace the hardwired x3/x6 (half_rate) arithmetic with two new VIDEO
    registers, LINE_SYMBOLS and ACTIVE_WINDOW, computed by firmware:
    line = htotal * LS_clk / pixel_clk (must be integral) and window =
    floor(B / tu_active) * 64 + B mod tu_active. This removes the RTL
    multiply/mod cones entirely and supports any integral-rate mode —
    preparing for RBR x4 1080p60 (2200 * 12/11 = 2400 symbols/line,
    tu_active = 44) without further framer arithmetic changes.
    All 16 tests pass (sim and board 480p profiles updated to program the
    new registers).
    [main.rs]
2026-07-20 Build the 4-lane main-link datapath
    RBR x4 carries 1080p60 (445.5 MB/s vs 648 MB/s; tu_active = 44, line =
    2200 * 12/11 = 2400 symbols/lane — all-integer accounting). This
    commit adds the lane-parallel datapath, verified to leave the 1-lane
    behavior bit-identical (all 16 tests pass):
    - msa_generator: 4-lane 12-symbol layout per Fig 2-18 (Mvid triple on
    all lanes, per-lane attribute columns, aligned SS/SE)
    - video_framer: i_four_lane — header triple once per lane (Fig 2-12),
    4-lane MSA window lengths, per-lane output bytes (only the MSA and
    TU arms differ across lanes)
    - tu_packer / main_link_data_mux: 32-bit (4-byte-lane) datapath;
    FS/FE/stuffing replicated across lanes (inserte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
2026-07-20 Verify the 4-lane path end-to-end and make video start origin-exact
    New dp_source_top_quad E2E: firmware trains 4 lanes against the mock
    sink and streams a 64x16 miniature of the 1080p60 structure (12/11
    ratio, tu_active=44); the sink model decodes/descrambles each lane,
    removes the 2N inter-lane skew, checks cross-lane alignment of every
    framing column, reassembles pixels per the steering tables and
    verifies 3 frames bit-exactly. All 18 tests pass.
    Two real bugs found by the test:
    - Pixel FIFOs now stay cleared (and refuse pushes) while video_enable
    is low: previously pixels accepted before the lane-count routing
    settled were stranded in the inactive FIFO, shifting the image by
    one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
    [main.rs]
2026-07-20 Bring the board design to 4-lane RBR 1080p60
    - top.sv: OSER10 + TLVDS_OBUF on all four lanes (2N inter-lane skew is
    already applied inside dp_source_top); TPG 1920x1080, held at its
    frame origin via o_video_enable until the pixel FIFOs start
    accepting; pixel_fifo_quad added to the synthesis file list
    - FW board profile: CEA 1080p60 (VIC 16) — 2200x1125 raster, hsync
    44 + hback 148 / vsync 5 + vback 36 (positive), Mvid/Nvid =
    0x7555/0x8000 (11/12), tu_active 44, 4 lanes (board builds now
    enable the lanes4 feature; board-without-lanes4 keeps the 480p
    1-lane fallback)
    - timing.sdc: false paths on the once-per-bring-up level signals
    (lane enable, four_lane, video enable, scramb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
2026-07-20 Update the eDP / Type-C study for the 4-lane capability
    Adds the post-4-lane assessment: bandwidth table, the integer-mode
    fitting method (the FW-programmable line accounting supports a pclk
    grid of 162*lanes*k/192 MHz, fine enough to hit almost any eDP panel's
    allowed clock range without fractional TU stuffing), the 2-lane-mode
    gap (needed for 30-pin eDP panels and Type-C pin assignment D), and a
    recommended work order (ASSR + virtual HPD + I2C master first — all
    sim-verifiable without hardware).
2026-07-20 Enable the bouncing-logo pattern and re-close timing at 1080p60 x4
    top.sv turns on the TPG bouncing logo (250x50 CQ logo over the color
    bars). The extra logic initially broke the 162 MHz closure; fixes:
    - test_pattern_generator: logo window flags by equality set/clear on
    the CURRENT counters against precomputed (bound-1) constants — no
    adder or magnitude compare in the per-pixel path (behavior
    unchanged; bounds only move at frame wrap)
    - pixel_fifo / pixel_fifo_quad: registered conservative tready
    (2-unit margin) so the occupancy counters no longer reach the TPG
    pacing logic combinationally; occupancy provably stays in bounds
    - video_framer: third f_line_vblank copy dedicated to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
    [test_pattern_generator.sv, top.sv]
2026-07-20 Add the eDP/Type-C groundwork: ASSR, virtual HPD, I2C master
    Step 1 of the eDP / Type-C alt-mode plan (doc section 4.5) — all three
    verifiable in simulation, no new hardware needed:
    - ASSR: the scrambler takes i_alt_seed and reloads 0xFFFE instead of
    0xFFFF on SR (eDP security requirement). MAIN_LINK CTRL bit 7,
    quasi-static CDC + SDC false path, MainLink::set_assr() in FW. New
    golden test checks the 0xFFFE sequence against the Appendix E
    reference topology (state 0xE917 after the first byte, 3.1.6).
    - Virtual HPD: SYSTEM HPD register bit 4 (RW), ORed with the physical
    pin — Type-C alt mode delivers HPD as a PD Attention VDM, so FW
    needs a register path into the HPD classifi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
2026-07-20 Add the 2-lane main-link mode
    Needed for 30-pin (2-lane) eDP panels and Type-C pin assignment D
    (2 lanes DP + USB3). RBR x2 = 324 MB/s, up to roughly 1600x900RB.
    - pixel_fifo_quad generalized to a LANES parameter (2 or 4 pixels per
    word, component-phase reads); a LANES=2 instance joins the FIFO mux
    - msa_generator: 2-lane 21-symbol layout per Fig 2-18 (two attribute
    columns back-to-back per lane, Mvid triple re-sent before the
    second)
    - video_framer / main_link_tx(_lane) / dp_source_top: two_lane mode
    (header triple twice per lane, MSA window lengths, lane_count == 2)
    - FW: lanes2 feature (LANE_COUNT=2, 12/11-ratio 64x16 sim profile,
    bootrom-rs-2lane.hex)
    - New E2E dp_source_top_d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
2026-07-20 Re-close 162 MHz with the full feature set
    The 2-lane mode + eDP/Type-C groundwork pushed the link domain into a
    congestion regime where marginal paths reshuffled every P&R run.
    Structural fixes instead of seed hunting:
    - ENABLE_LANES2 parameter (dp_source_top down to the lane): 0 ties the
    two-lane flag to constant zero so synthesis prunes the 2-lane FIFO
    and MSA/mux cones entirely; the Pmod DP board (1/4-lane only) sets 0,
    simulation keeps 1 and the dual E2E still covers the mode
    - Encoder input pipeline stage, CONTINUOUS_BYTE_TICK-gated: cuts the
    scrambler/skew-to-encoder routes on FPGA builds; the paced (sim)
    path keeps the original timing that the bit-level test monitors
    exp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
    [test_pattern_generator.sv, top.sv, tpg_to_axis.sv]
2026-07-20 Fix the missing v_last update that rolled the picture vertically
    The v_last lookahead introduced during timing closure was only
    assigned at reset and frame wrap — the per-line update had been lost
    to a silently failing scripted edit. With v_last stuck low the frame
    wrap never fired: vcounter free-ran to its 2^N natural wrap, the
    blanking stretched by ~1000 lines per frame, pixel production fell
    below the 1080p60 budget and the DP pixel FIFO starved mid-frame —
    on the monitor this appeared as a vertically rolling image with a
    perfectly healthy link.
    Add tb_tpg_raster: with enable held high, every frame must produce
    exactly HACTIVE*VACTIVE DE pixels in exactly HTOTAL*VTOTAL cycles.
    This i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
    [test_pattern_generator.sv]
2026-07-20 Document the concrete Type-C board plan (FUSB302B + FUSB340 x2)
    Two FUSB340s (one per ML lane pair group, complementary SEL) cover
    4-lane pin assignment C orientation switching; adds the SBU crossbar,
    VBUS load switch, AC coupling and AUX bias details, the FUSB302B
    polling-based FW driver breakdown, and open board-level questions.
2026-07-20 Adopt FUSB302B + HD3SS460 as the Type-C board architecture
    HD3SS460 integrates the 4-lane SS crosspoint and the SBU low-speed
    crosspoint in one cheap pin-controlled part (AMSEL/POL/EN), removing
    the second FUSB340 and the discrete SBU switch from the BOM; the
    FUSB340 x2 alternative is kept for comparison.
2026-07-20 Add KiCad design notes for the Type-C alt-mode board
    Net-level connection tables for HD3SS460 and FUSB302B, power tree,
    FPGA pin budget, a layout/ERC checklist (90-ohm SS pairs, AC coupling
    placement, SBU bias, VBUS cold-socket policy) and the FW control
    sequence mapped to the board GPIOs.
2026-07-20 Implement the Type-C alt-mode firmware stack (FUSB302B driver)
    Hardware-ahead implementation for the FUSB302B + HD3SS460 board
    (typec_board_kicad_notes.md); enabled by the new `typec` cargo
    feature, compiled into bootrom-rs-typec.hex (board,lanes4,typec —
    14.5 kB, fits the 16 kB ROM):
    - i2c.rs: HAL over the on-chip I2C master (register write / repeated-
    START read with NACK propagation)
    - fusb302.rs: polling driver — SW reset, power-up, Rp presentation on
    both CC pins, BC_LVL-based attach/orientation measurement, VCONN to
    the spare pin, auto-GoodCRC/auto-retry setup, SOP TX through the
    token FIFO (SOP1x3+SOP2, PACKSYM, JAM_CRC, EOP) and SOP RX with
    non-SOP frame draining
    - pd.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
    [main.rs]
2026-07-21 Add a footprint-creation task brief for the KiCad session
    Self-contained instructions for creating the HD3SS460 (WQFN-28 RHR)
    and FUSB302BMPX (MLP-14) footprints on the KiCad machine: check the
    standard libraries first with a strict 4-point match rule, otherwise
    generate from the datasheet land patterns, with naming/EP-paste/
    courtyard conventions and a verification checklist to report back.
2026-07-21 Add the schematic-level wiring guide to the Type-C board notes
    Full net-level topology: receptacle pin table (SS pairs to HD3SS460
    connector ports, CC direct to FUSB302B, SBU to the mux, D+/- open),
    HD3SS460 strap/control defaults (AMSEL strapped to 4-lane DP, POL/EN
    pulled down), the lane-order warning (transcribe LnA..D vs ML0..3
    from the TI application figure — no lane swap exists in RTL), FUSB302B
    pin table, AUX bias recap, VBUS chain and safe power-up defaults.
2026-08-04 Bring up the Tang Primer 25K DVI receiver to bit-perfect 720p capture
    Verified on hardware against a Tang Nano 9K dvi_out_tpg source
    (720p60 over a Sipeed Pmod DVI): stable word lock, zero decode
    errors, and frame/line-CRC-identical capture of a static pattern.
    dvi_in core (Veryl):
    - Align on data-lane-0 control symbols (DVI 1.0 3.3.2) instead of a
    deserialized clock lane: a pad whose IBUF fans out to the recovery
    PLL cannot also drive the IODELAY/IDES10 chain on GW5A, so the
    clock pair now feeds the PLL only.
    - Windowed boundary search (ALIGN_WINDOW spans >= 1 hblank) with a
    control-symbol-timeout lock-loss rule; the per-tap sweep is
    replaced by a fixed tap.
    - Harden against corr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
    [dvi_in_phy.sv, gowin_pll_dvi.v, iser10_lane.sv, top.sv]
2026-08-05 Log the FUSB302B DEVICE_ID at boot as the first board smoke test
2026-08-05 Add the display_port_typec board target for the alt-mode board
    New eda/display_port_typec project for the FUSB302B + HD3SS460 board:
    lanes/AUX identical to the Pmod DP pinout, plus the second-Pmod
    signals from the board schematic (G7=INT_N, G8=POL, H8=AMSEL, H7=EN,
    H5=SDA, J5=SCL) via a new pmod_dp_altmode pin-map module. The top has
    no physical HPD (virtual HPD only), open-drain I2C pads, and the mux
    controls on cpu_io_out bits 24/25/27; firmware gains the AMSEL GPIO
    (level marked TODO pending the datasheet mode-table check — flippable
    at run time through the UART loader) and bakes bootrom-rs-typec.hex.
    clock_byte closes at 162.329 MHz.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
    [pmod_pins.csv]
2026-08-05 Add an HPD bypass for Type-C board bring-up
    The new board has no physical HPD and the virtual HPD only asserts
    after PD alt-mode entry succeeds — unproven territory on first power-
    up. With HPD_BYPASS the firmware skips the HPD gate, extends the DPCD
    retry window to ~600 attempts and keeps polling the PD engine (with
    state-transition logging) between attempts, so the whole PD -> AUX ->
    DPCD chain can be watched from one UART log while it is debugged.
    [main.rs]
2026-08-05 Add a mux bring-up sweep (AMSEL x lane count) for the Type-C board
    First hardware log: AUX/DPCD/EDID work with all mux GPIOs at their
    defaults while 4-lane CR fails — consistent with the wrong AMSEL level
    routing only 2 lanes (lane permutation cannot fail CR since TPS1 is
    identical on all lanes). In bypass mode the FW now force-enables the
    mux at boot and sweeps AMSEL {1,0} x lanes {4,2}, reporting which
    combination trains.
    [main.rs]
2026-08-05 Sweep the mux EN level too (native-DP-connector bring-up)
    The board tees the lanes to a native DP connector and the HD3SS460;
    with Type-C unplugged the right state is mux-off, but the EN polarity
    is unverified — a mux that is actually on loads the lanes with the
    unplugged Type-C stub (AUX at 1 Mbps survives, 1.62 Gbps CR does not,
    matching the observed CrFailed). The sweep now covers EN x AMSEL x
    lane count and no longer force-enables the mux at boot.
    [main.rs]
2026-08-05 Rework the bring-up flow for Type-C-side testing (PD-driven mux)
    The native DP connector path fails CR regardless of mux state — the
    trace branch to the HD3SS460 Ln pins is a permanent stub, so testing
    moves to the Type-C receptacle. The FW now waits up to 60 s for the PD
    engine to reach Configured (logging every state transition), keeps the
    PD-decided orientation, and only sweeps the unverified AMSEL level
    (4-lane first, 2-lane as a diagnostic). Falls back to a manual mux
    enable if PD stalls.
    [main.rs]
2026-08-05 Trace all PD traffic and resend silently-dropped requests
    Bring-up reached Discovering against a real sink but stalled there
    with nothing to go on. Every SOP frame is now logged raw ('>' sent,
    '<' received, header + VDOs), and each waiting state re-issues its
    request after ~0.5 s of silence (SourceCap and every VDM step) since
    a polling engine has no timer-driven retry. The typec build drops the
    EDID dump to make room in the boot ROM (overflowed by 340 bytes).
    [main.rs]
2026-08-05 Read the plug pin-assignment field when the DP mode partner is a plug
    The first full trace showed the whole PD/VDM chain ACKing, but the
    partner is a C-to-DP cable adapter: its mode VDO (0x00000405) has
    bit 6 clear (plug) with Assignment C in bits 15:8, while we read the
    receptacle field (bits 23:16 = 0), fell back to Assignment D, and the
    adapter ACKed a configuration it can't route — AUX stayed dead. Pick
    the field by the receptacle bit.
2026-08-05 Rotate POL x AMSEL while AUX stays dead after alt-mode entry
    Configure(C) now ACKs but DPCD still times out with rx_count=0 and no
    HPD Attention. A wrong POL level swaps SBU1/2 through the mux and
    silences AUX exactly like this, so the DPCD retry loop now steps
    through the four POL x AMSEL combinations about once a second while
    continuing to poll the PD engine.
    [main.rs]
2026-08-05 Rotate the mux combination every 25 DPCD attempts instead of 100
    The first rotation only fired at attempt 99, which reads as "nothing
    is happening" next to the rate-limited failure prints.
    [main.rs]
2026-08-05 Advertise 5V/3A and record the Type-C board schematic review
    The sink is DP-alt-mode smart glasses whose Request sets Capability
    Mismatch against our 5V/0.9A PDO — withholding HPD for power reasons
    is the leading theory, and the user confirmed the rail can source 3A.
    The netlist reconstructed from the KiCad schematic checks out (AUX
    bias, lane tee, CC, I2C); notable deviations recorded: mux control
    pullups (enabled before config), always-on VBUS with no load switch,
    VCONN fed from VBUS, and the HPD/INT_N jumper sharing one Pmod pin.
2026-08-05 Recover from an Enter Mode NAK by exiting and re-entering
    With 5V/3A advertised the glasses now contract without Capability
    Mismatch, but they NAK Enter Mode — consistent with the DP mode left
    active by a previous run that never sent Exit Mode. On that NAK the
    engine now sends Exit Mode and re-enters when the exit is ACKed.
2026-08-05 Drive the HD3SS460 control pins open-drain (3-level pin fix)
    Root cause of the dead AUX on the Type-C path: EN/AMSEL/POL are
    3-level inputs (H >= VCC-0.4 = 2.9V, M = VCC/2 +/- 0.3V, L <= 0.4V)
    and the FPGA's 2.5V push-pull high lands in the undefined gap between
    M and H — AMSEL around M selects the USB3-only mode whose SBU ports
    are Hi-Z, which is exactly the observed symptom while PD (HPD=1 via
    Attention) was fully healthy. The board's 10k pull-ups to 3.3V exist
    precisely to make the H level, so the FPGA now only ever drives low or
    releases. The lane/SBU wiring matches the TI reference (Table 2:
    LnA-D = ML0-3, SBU1 = AUXP), so AMSEL=H/EN=H is the 4-lane DP mode.
    Also extends the bring-up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
    [main.rs, top.sv]
2026-08-05 Record the HD3SS460 3-level control pin findings in the board notes
2026-08-05 Use explicit IOBUFs for the mux controls and add a park-mode FW
    The pull-ups measure 3.3V on the rail side yet the released control
    pins sit near 0.7V, so the pad may not actually be tristating — and
    the education-edition synthesis netlist is encrypted, making inference
    unverifiable. Instantiate IOBUF primitives (OEN-controlled) instead of
    relying on `?: 1'bz` inference, and add a `muxpark` FW feature that
    releases EN/POL/AMSEL right after boot and halts so the DC levels can
    be probed without the policy engine or the bring-up rotation toggling
    the pins.
2026-08-05 Wait for the sink's HPD again before touching AUX (bypass off)
    On the working board the glasses train and accept video immediately
    after Configure — but they never raised HPD, and a few seconds after
    video starts both AUX and CC PD go silent while VBUS stays solid:
    driving a link into a receiver that declared itself not-ready wedges
    it. The HPD bypass was a bring-up aid from when the PD path itself was
    unproven; the normal path already polls the PD engine while waiting
    for the virtual HPD.
2026-08-05 Probe AUX recovery by stopping the video stream after repeated timeouts
    With the proper HPD-gated sequence the glasses still lose AUX a few
    seconds after video enable (VBUS solid). After five consecutive status
    timeouts the FW now disables the stream once and keeps polling, which
    splits "sink wedged until replug" from "sink cannot coexist with our
    video stream".
2026-08-05 Probe CC-side PD liveness while AUX is dead
    Video-off did not bring AUX back, and one AUX timeout already hit
    during the first training attempt — consistent with either a full sink
    crash or broadband crosstalk from the scrambled main-link stubs at the
    unplugged DP connector jamming the AUX tee (idle is scrambled too,
    which explains the no-recovery). Every 8th failed status poll now
    fires a DP Status Update over CC; a GoodCRC/ACK in the trace proves
    the sink is alive and pins the blame on the AUX path.
    [main.rs]
2026-08-05 Hold the trained link at idle to find what makes the glasses drop HPD
    The CC liveness probe shows the glasses alive with HPD deasserted by
    their own choice after video starts — a deliberate link drop, not a
    crash or a jammed AUX. Insert a 20 s idle hold between training and
    video enable, polling link status and PD each second, to pin the
    trigger to either the video start or the idle period itself. Log
    strings shortened to fit the boot ROM.
    [main.rs]
2026-08-05 Hammer the status block right after video-on; drop the obsolete sweeps
    The idle hold proved the trained link runs clean indefinitely (77/77,
    aligned, no errors for 20 s) and the glasses drop HPD the moment the
    stream starts — a deliberate rejection of the stream content. Read
    DPCD 200h-205h four times back-to-back and eight more at ~10 ms
    spacing right after enabling video to capture IRQ/link-status flags
    before the receiver shuts down. The mux rotation and AMSEL training
    sweep go away (EN=H / AMSEL=H / PD-driven POL is bench-proven), which
    also pays for the new strings in the boot ROM.
    [main.rs]
2026-08-05 Trace VBUS through the fatal first second of video
    The dying-words capture shows the glasses achieving video sync
    (SINK_STATUS=1, lanes 77/77, zero IRQ) and then dropping HPD within a
    second without any protest — the signature of a panel-inrush brown-out
    right when the display lights, which a hand-held DMM would miss. Read
    VBUS via the FUSB302B MDAC comparator (420 mV steps, binary search)
    alongside each of ~40 status samples spanning ~2 s after video-on.
    [main.rs]
2026-08-05 Read the glasses' EDID, hammer AUX as keep-alive, drop the idle hold
    VBUS tracing exonerated power (steady 4.6-5.0 V through sync and
    death), and both runs died within the first ~1 s AUX-quiet gap after
    video-on while surviving arbitrarily long spans of 50 ms polling — so
    the monitor loop now polls at ~100 ms and the post-video hammer runs
    ~10 s as a keep-alive experiment. The typec build regains the EDID
    dump (the sink's actual timing demands live in its DTDs — glasses
    often want non-CEA blanking) paid for by removing the idle-hold
    experiment, whose result (idle link stable indefinitely) is banked.
2026-08-05 Send an exact 11/12 Mvid/Nvid pair (22528/24576)
    The rounded 0x7555/0x8000 pair is -11 ppm off the true pixel/link
    ratio. A sink that regenerates its pixel clock from Mvid/Nvid then
    drifts against the real stream rate and its elastic buffer overflows
    after a fill-dependent 0.5-10 s — exactly how the glasses die: image
    up, zero link errors, zero IRQ, then a silent drop at a variable time.
    Monitors resample and never noticed. 22528*12 == 24576*11 makes the
    ratio exact.
    [main.rs]
2026-08-05 Poll link status every 50 ms — testing the keep-alive threshold
    The glasses power their whole AUX PHY down (bias gone at the
    connector) at a moment that has now lined up with the end of the 50 ms
    hammer window in four consecutive runs, while 100 ms polling did not
    keep them alive. One-constant experiment before digging deeper.
2026-08-06 Retry FUSB302B init at boot (cold-boot from flash races its POR)
    Booting from flash, the CPU runs a few hundred ms after power-on —
    before the FUSB302B (and the board rail) finish power-on reset — and
    the one-shot init left the PD engine dead until a UART FW reload.
    Retry DEVICE_ID + init at ~100 ms intervals until the chip answers.
    The 200-sample post-video hammer goes away (the 50 ms monitor loop
    does the same job) to pay for it in ROM space.
    [main.rs]
2026-08-06 Revert the FW to the last hardware-verified displaying state (700a5b4)
    The display stopped coming up after the last two FW changes (50 ms
    monitor cadence, init retry + hammer removal); roll the firmware
    sources back to the exact state that showed video on the glasses.
    Improvements will be re-applied one at a time against that baseline.
    [main.rs]
2026-08-15 Migrate gowin_easycdr_sample to the IDE 1.9.12 EasyCDR IP
    The V1.9.9-generated encrypted core no longer elaborates on IDE >= 1.9.11
    (OSIDES32 delay ports were split into two chains). Rebuild the IP from the
    1.9.12 templates (easycdr_1912/) configured for this design's actual line
    rate of 1.0Gbps: 16-bit output, delay taps 0/21 as the IP GUI computes.
    Hardware-verified fixes found during bring-up:
    - The 1.9.12 core packs recovered bits into dout_o in the reverse bit
    order from the old core; bit-reverse the word before the PRBS checker.
    - Qualify o_dat_lock with an EC92-marker watchdog: the PRBS inspector
    false-locks onto the all-zero sequence (LFSR fixed point) when no
    signal is presen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
    [EasyCDR.v, EasyCDR_Top.v, define.v, top.v]
2026-08-15 Add ExtEasyCDR Type-C Pmod module schematic
    Four PMOD differential lanes AC-coupled (100nF) to the USB-C SuperSpeed
    pairs, with 10k bias to a 1.65V midpoint on the FPGA side of each lane.
    Used to run the EasyCDR link over a standard passive Type-C cable.
    [ExtEasyCDR.kicad_sch]
2026-08-15 Add 1.2Gbps EasyCDR loopback sample (BEYOND_1G, USB-C link)
    Line rates above 1Gbps use the EasyCDR BEYOND_1G/32-bit configuration:
    RX HCLK = rate/4 (300MHz x4 phases, PLL_T), parallel clock = rate/16.
    The 600MHz TX serializer clock cannot share the RX HCLK group, so TX
    lives in BANK1 (pmod0). The link runs over two ExtEasyCDR modules and a
    passive USB-C cable; transmitting on module lane L1 makes the cable's
    TX2<->RX2 cross wiring arrive at the far module's lane L0 with straight
    polarity. Verified error-free on hardware (EC92 marker period 13.628us).
    Notable findings baked into the design:
    - dout_en of the BEYOND_1G core is bursty (back-to-back asserts), so the
    32->16 gearbox buffers half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
    [EasyCDR.v, EasyCDR_Top.v, define.v, top.v]
2026-08-23 Add EasyCDR trace-link sample, phase 1: 8b10b link layer
    1Gbps link over one differential pair using the EasyCDR 10-bit + Word
    Alignment + 8B/10B Decoding configuration (K28.5 comma every 16 words,
    incrementing-counter payload). The TX core is family-independent
    (reuses the DisplayPort 8b10b encoder + OSER10) so slower parts such as
    GW1N/GW2A can transmit into a GW5A receiver later. Verified error-free
    on hardware over the ExtEasyCDR / USB-C link.
    [EasyCDR.v, EasyCDR_Top.v, define.v, pll_rx_500m_4ph.v, pll_tx_500m.v, top.v]
2026-08-23 easycdr_trace phase 2: capture buffer + UART dump
    Capture the received payload stream into a 16KiB dual-clock BSRAM
    buffer (arm-fill-freeze model) and dump it to the host over the
    on-board UART (C3/B3 via BL616, 115200 8N1). Single-byte protocol:
    'S' arms the capture and replies 'K' when full, 'D' streams the raw
    buffer. host/trace_dump.py verifies the consecutive-counter payload.
    Verified end-to-end in the faithful post-PnR simulation.
2026-08-23 easycdr_trace phase 3: timestamped trace records
    The TX side now samples a signal, detects changes and streams
    timestamped records over the link:
    [K28.1][ts x3][data x2], with K28.2 as a FIFO-overflow marker and
    K28.3 as idle filler. Timestamps count 100MHz link-clock cycles.
    The capture buffer stores 9-bit {K flag, byte} entries so the host
    (host/trace_view.py) can re-frame the records after an arbitrary
    capture start. Demo trace source: a slow counter plus the raw UART RX
    line, so the host's own dump command appears in the trace.
    Verified in the faithful post-PnR simulation (records show the
    testbench's 'S' command edges with correct 10ns timestamps).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
    [top.v, trace_view.py]
2026-08-23 easycdr_trace: Tang Nano 9K TX target (999Mbps cross-family link)
    Adds a TX-only build (TARGET=tangnano9k_pmod) so a cheap GW1N part can
    stream trace records into the GW5A EasyCDR host. The shared link RTL
    moves to src/common/. Line rate is 999Mbps from the 27MHz crystal
    (rPLL x37/2, VCO 999MHz), i.e. -1000ppm against the host's 1Gbps
    setting - within the CDR tolerance, so the host bitstream is unchanged.
    The wire polarity is inverted at the OSER10 inputs because the tools
    place o_serial_p on the pair's A-side pad, which is the module's L1_N
    pin on this pinout (GW1N also requires OSER->OBUF direct connection,
    so the inversion cannot sit between them). Demo trace inputs: slow
    counter + button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
    [pll_tx_4995.v, top.v]
2026-08-24 easycdr_trace: generic bit8 column in trace_view, Nano9K verified on hardware
2026-08-24 easycdr_trace: trace TX IP, parameterized width, triggered pre-trigger capture
    TX side is now a reusable IP (src/common/easycdr_trace_tx.v): WIDTH /
    TS_BITS parameters, change-detect + timestamp + record FIFO + 8b10b
    link core in one module; the change detector is pipelined so the
    WIDTH-bit compare stays out of the FIFO write-enable path (the GW1N
    build failed timing at 100MHz without it).
    Host side decodes records on the fly (trace_rx_decoder) and the capture
    buffer becomes a ring with a trigger comparator: 'T' sets mask/value,
    'A' arms with a post-trigger entry count (the rest of the buffer is
    pre-trigger history), 'S' keeps the immediate mode, 'D' dumps oldest
    first. host/trace_view.py g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
    [top.v, trace_view.py]
2026-08-24 easycdr_trace: UART baud as a single top-level parameter
2026-08-24 easycdr_trace: transport-agnostic host interface on trace_capture
    trace_capture now exposes the host link as a byte stream (valid/ready
    in both directions) instead of instantiating the UART itself; the UART
    lives in top.v so a USB CDC core can be attached in its place without
    touching the capture/command engine. Behaviour re-verified in the
    triggered-capture simulation.
2026-08-25 Add USB 2.0 PHY / ULPI / device core sample (Veryl)
    USB 2.0 peripheral PHY modelled after the Gowin USB 2.0 SoftPHY IP
    (IPUG781): UTMI 1.05 link interface, HS/FS/LS, 8 samples per 60 MHz
    clock serial side (IDES8/OSER8 shaped), NRZI / bit stuffing / SYNC / EOP,
    chirp K, termination controls, and the TN710 receiver set (differential
    D+/D- receiver plus two single-ended comparators).
    Also included:
    - UlpiPhy (ULPI 1.1 PHY side: TXD CMD, RX CMD, register file) and
    UlpiLink (link side adapter presenting UTMI)
    - UsbSie (packet layer, CRC5/CRC16) and UsbDevice (reset / chirp /
    suspend handling, EP0 standard + vendor requests, EP1 bulk loopback)
    - generated descriptor ROM, host BFM and `veryl t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
    [usb_phy_gowin.v]
2026-08-25 pmod_usb_hs: design study and survey for a Pmod USB 2.0 HS board
    Design notes for a Type-C (USB 2.0 only) Pmod board following the Gowin
    TN710 USB2.0-RC circuit (2 Pmod ports, 11 I/O), family-specific
    resistor values, Tang Primer 25K / Nano 9K / Primer 20K pin candidates,
    and the survey of the 25K Dock USB-A wiring (FS-only as a device).
2026-08-25 pmod_usb_hs: notes for deriving the Pmod USB board from ExtEasyCDR
2026-09-05 nvme: transport-independent NVMe core, queue engine, and SPDK/TCP sim
    Add rtl/nvme, an NVMe sample in Veryl:
    - NvmeCore: transport-independent command processor. Takes the 64-byte
    SQE as a dword stream, moves command data over h2c/c2h dword streams,
    returns {CID, Status Field, CQE DW0}, and executes against a
    dword-wide synchronous backing RAM. Supports Identify (CNS 00/01/02/03),
    Set/Get Features (NQ, VWC), Read/Write/Flush on one 512B-block
    namespace. MDTS is 8KiB so PRP-based transports never need PRP lists.
    - NvmeController: PCIe-style controller mechanics in RTL around the
    core - CAP/VS/CC/CSTS/AQA/ASQ/ACQ registers and doorbells, SQE fetch
    and CQE writeback (phase tag, S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
2026-09-05 nvme: vfio-user bridge - SPDK drives the RTL queue engine directly
    Expose NvmeController as a vfio-user PCI device (class 010802h) via
    libvfio-user, so SPDK's userspace VFIOUSER initiator exercises the RTL
    queue mechanics for real: BAR0 register accesses reach the CSR port,
    the doorbell page (BAR0+1000h) is a shared-memory sparse mmap polled
    into the RTL, and SQE/CQE/PRP traffic flows through the controller's
    DMA master port into the client's DMA-mapped memory. Unlike the
    NVMe/TCP bridge, no NVMe logic lives in the bridge.
    Verified all user mode (--no-huge): spdk_nvme_identify enumerates the
    controller and namespace, spdk_nvme_perf completes 4KiB randrw QD4
    (~2.6k IOPS through the Verilated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
2026-09-05 nvme: multiple I/O queue pairs and MSI-X-style interrupt vectors
    Extend NvmeController from a single I/O queue pair to up to four
    (QID 1..4, NUM_IO_QUEUES):
    - Round-robin arbitration between pending I/O submission queues, with
    the admin queue always served first. A submission queue may complete
    into any created completion queue (Create I/O SQ's CQID is honored).
    - Eight interrupt vectors (o_irq_vec): each I/O CQ carries the vector
    from Create I/O CQ (IV validated, IEN honored) and the vector stays
    asserted until the CQ head doorbell catches up; the admin CQ uses
    vector 0. o_irq remains the legacy ORed line.
    - Number of Queues feature answered locally by the queue engine
    (grants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
2026-09-05 nvme: NVMe/TCP target in RTL - first step toward an Ethernet board
    Add NvmeTcpTarget, the NVMe-oF/TCP target PDU layer in Veryl, aimed at
    an Ethernet-capable FPGA (Tang Primer 20K / Tang Nano 9K + PHY). Its
    boundary is two raw TCP byte streams (8-bit valid/ready, one per
    queue's connection); everything the C++ NVMe/TCP bridge used to do now
    happens in RTL:
    - ICReq/ICResp negotiation, fabrics Connect / Property Get/Set,
    Keep Alive, AER held forever
    - RX interleaves the two connections one byte per cycle; SQEs land in
    a shared 64-slot BRAM FIFO
    - writes use the R2T flow with H2CData payload streamed straight into
    NvmeCore's h2c port - no data buffering even with pipelined
    commands; CA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
2026-09-05 nvme: ARP/IPv4/ICMP endpoint for the RMII MAC (Tang Nano 9K + LAN8720)
    Phase 2 of the NVMe-oF-on-Ethernet plan: EthIpStack, a minimal ARP +
    ICMP echo responder in Veryl that sits on the verified rtl/ethernet
    RMII MAC's 8-bit AXIS streams (the MAC is reused as-is - it is already
    proven on Tang Nano 9K + LAN8720). One frame is buffered in a 2KiB
    BRAM and replayed with the header fields swapped/patched: ARP replies
    build sender fields from MAC_ADDR/IP_ADDR parameters; ICMP echo
    adjusts the checksum incrementally (type 8->0), the IP header checksum
    is unchanged because the address swap is sum-neutral.
    The frame buffer is written/read in the BRAM-friendly single-port
    pattern (an early version in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
    [eth_tap_bridge.cpp]
2026-09-05 nvme: kernel ping against the RMII RTL via a TAP bridge
    Verified end to end: `ping 192.168.37.2` from the real kernel network
    stack reaches the RTL through the TAP device, the harness serializes
    frames (preamble/FCS) onto the RMII pins, the verified rtl/ethernet
    MAC recovers them and EthIpStack answers ARP and ICMP - 0% loss for
    normal, 1400-byte and 0.1s-interval floods.
    Debugging notes: the sim Makefile initially compiled the wrong
    crc_mac (rtl/ethernet has two - crc/crc_mac.sv is the 64-bit xg_mac
    variant whose tkeep is unconnected in the 8-bit MAC's instantiations
    and whose CRC hold register is broken; mii_mac/crc_mac.sv is the
    8-bit one the verified boards actually use). Point the buil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
    [eth_sim_top.sv, eth_tap_bridge.cpp]
2026-09-05 nvme: TCP-lite engine - SPDK reaches the target over the RMII RTL
    Phase 3: TcpEngine, a lean TCP server in Veryl completing the
    NVMe-oF-over-Ethernet stack for the Tang Nano 9K + LAN8720:
    - two fixed connection slots (admin + I/O queue), passive open on
    4420, MSS=1460 in the SYN-ACK
    - RX: in-order segments only; a 2KiB FIFO per connection whose free
    space is the advertised window (window-update ACK on drain); frame
    payload commits only on good FCS
    - TX: application bytes land in a 2KiB ring doubling as the Go-back-N
    retransmission buffer; segments cut at 1KiB or on stream idle;
    IPv4/TCP checksums generated in a two-pass byte scan (pseudo header
    included); frames padded to the 60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
    [eth_nvme_top.sv, eth_tap_bridge.cpp, smoke_host.py]
2026-09-05 nvme: Tang Nano 9K + LAN8720 bring-up - bitstream with timing closure
    Add eda/nvme_ethernet: the NVMe-oF/TCP target on the Tang Nano 9K,
    wired and clocked identically to the proven eda/ethernet_icmp design
    (everything in the LAN8720's 50MHz RMII clock domain, same pinout).
    IP 192.168.37.2, port 4420, 32KiB BRAM namespace, LEDs show
    heartbeat/RX/TX/connection state.
    Getting from the first bitstream (Fmax 32.4MHz) to timing closure
    (50.01MHz, zero violations, 78% logic / 89% BSRAM) took a series of
    micro-architecture changes, all re-verified in simulation (veryl test,
    TAP ping/smoke, SPDK identify+perf) at each step:
    - TcpEngine: the RX segment commit moved one cycle after tlast and
    then s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
2026-09-05 nvme: tangnano9k_pmod target (current Pmod Ethernet wiring)
    The actual rig is the Tang Nano 9K Pmod base board with the Pmod
    Ethernet adapter in PORT2, wired as in eda/ethernet_video's
    tangnano9k_pmod build (txclk=32, crs_dv=31, rxd=57/56, txd=54/53,
    txen=55; button_s2 at 84) - add that as the recommended target,
    keeping the older direct wiring as tangnano9k.
    The different pin placement shifted P&R enough to fail timing, so two
    more shallow-path changes went in (both re-verified in simulation):
    EthTxMux gained a proper skid buffer so the MAC's combinational ready
    never reaches the producers, and EthIpStack commits one cycle after
    tlast (which also fixes a latent race where a back-to-back fr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
    [top.sv]
2026-09-05 nvme: power-on-only reset and finer LED diagnostics for bring-up
    ping did not answer on the board while the PHY link was up. Prime
    suspect: the reset chain included !button_s2 on an assumed-active-low
    button - if the Pmod base board button idles low, the whole design sat
    in permanent reset (and the heartbeat LED, being reset-free, would
    still blink). No reference design in the repo uses a button for reset,
    so drop it: power-on reset only (reload the bitstream to reset).
    LED[0] now shows raw CRS_DV activity at the pin, separating "RMII
    traffic reaches the FPGA" from "the MAC delivered a frame" (LED[4]):
    [5] heartbeat [4] MAC RX frame [3] TX frame [2:1] TCP conns
    [0] raw CRS_DV
    Co-Autho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
    [top.sv]
2026-09-05 nvme: pad ARP/ICMP replies to the Ethernet minimum frame size
    Root cause of the board's silent ping failures with all activity LEDs
    blinking: EthIpStack sent the 42-byte ARP reply unpadded. Real NICs
    drop sub-60-byte runts silently, so ARP never resolved; the TAP-based
    simulation hid this because the kernel accepts short frames from a TAP
    (the TCP engine already padded its own frames). Pad the responder's TX
    to 60 bytes and check the padding in the eth_ip test.
    Claude-Session: https://claude.ai/code/session_01VFhLzCdEWnHbPQ1n3EEFJn
2026-09-05 nvme: NVMe/TCP smoke passes on Tang Nano 9K + LAN8720
    First end-to-end success on hardware: the Python NVMe/TCP host runs
    the whole sequence (TCP connect, Fabrics Connect/Property, Identify,
    I/O queue write/read round trip, error status, Flush) against the
    board and passes every check.
    The blocker was a synthesis-vs-simulation divergence, traced with
    LED byte counters and tcpdump: the ICReq's 128 bytes were all
    delivered into NvmeTcpTarget (TCP layer already fine - checksums
    correct, ACK 129 sent), yet no ICResp ever came out. The parser
    assembled PLEN with part-select writes into a variable-indexed array
    element (rx_plen[sel][7:0] <= ...), a construct Verilator honours but
    the synthesizer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
    [top.sv]
2026-09-05 nvme: record the hardware results (SPDK identify/perf on the board)
    spdk_nvme_identify enumerates the controller and namespace over the
    real 100BASE-TX link, and spdk_nvme_perf completes 4KiB randrw QD4
    for 10s at 999.8 IOPS / 3.91 MiB/s - in line with the line-rate
    estimate and ~13x the Verilator simulation.
    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
2026-09-05 nvme: Get Log Page, feature defaults, and TcpEngine timing headroom
    NvmeCore now serves Get Log Page (Error Information, SMART/Health,
    Firmware Slot) and accepts Get/Set Features for FID 01h-0Fh with default
    values, so spdk_nvme_identify no longer reports get_feature / get log
    page failures. The TCP target sizes the C2H transfer from NUMDL.
    The extra logic pushed the Tang Nano 9K build below 50MHz on TcpEngine
    paths, so the RX per-byte payload path drops the redundant p_is_tcp term
    and uses a registered payload window, the pseudo-header checksum add is
    split across PreSum/PreSum2, and the header byte mux is indexed by
    6 bits. tangnano9k_pmod: Fmax 50.4MHz, Logic 81%, BSRAM 89%.
    Co-Authored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
2026-09-06 gowin_psram: HyperRAM controller in Veryl for the Tang Nano 9K PSRAM
    GowinPsram drives one HyperRAM die (the GW1NR-9 on-package Winbond
    W955D8MBYA) with plain Gowin ODDR/IDDR primitives: 1:1 clocking with a
    90-degree CK clock, fixed 2x initial latency configured in CR0 at init,
    linear bursts up to 128 words, RWDS byte masks, RWDS self-timed read
    capture, register-space access. No encrypted Gowin IP, so the whole thing
    simulates: test/hyperram_model.sv is a behavioral die and the tests run
    against the ODDR/IDDR models extracted from the Gowin IDE (make prim).
    The CK enable is re-registered on the falling edge before the i_clk_p
    ODDR (the direct path only has a quarter period), which per the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
    [gowin_rpll_psram.v, top.sv]
2026-09-06 gowin_psram: sweep the write data latency too (i_lat_extra) during bring-up
    Board result with the first bitstream: register reads/writes correct
    (CR0 reads back 8fef), memory writes garbled with a constant XOR of
    pat(0x72), i.e. the write data phase starts two CK cycles too early for
    the real chip (and the 128-word burst then wraps). Make the extra write
    latency a runtime input and let PsramTest sweep ck_delay 0..2 x
    lat_extra 0..3, printing 'ckd=N lx=M ...' per pass.
    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
2026-09-06 psram_test: actually wire i_lat_extra in the Tang Nano 9K top
    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
2026-09-06 gowin_psram: settle the controller on the measured Tang Nano 9K behavior
    Board results (PsramTest over 1MiB, UART): CK/DQ alignment matches the
    primitive models (CK_DELAY 0); the fixed-latency data phase starts two CK
    cycles later than the HyperBus-spec reading of the model (count from the
    third CA clock), and the die wraps every burst at the CR0 burst length
    even with a linear CA (32-byte setting: 1/8 of a 128-word burst
    survives, 128-byte: 1/2; 16/32/64-word bursts inside a 128-byte group
    are clean).
    So: latency built in, WRAP_BYTES parameter (128) drives CR0[1:0],
    LEN_BITS 6, bring-up knobs (i_ck_delay / i_lat_extra / i_cr0_burst)
    removed in favor of CK_DELAY, the behavioral model wraps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
    [top.sv]
2026-09-06 nvme: PSRAM namespace (4MiB) behind a write-back cache; root-less sim host
    Replace the 32KiB BRAM namespace of the Tang Nano 9K NVMe/TCP target with
    the on-package PSRAM (4MiB, 8192 blocks): NvmeCore gains an i_mem_ready
    stall input, and PsramDwordCache (a one-line 512B write-back cache, dual-
    clock BRAM + toggle synchronizers) bridges the 50MHz NVMe domain to
    GowinPsram running in its own PLL domain. smoke_host passes (including
    repeated runs), SPDK identify/perf work, and probe_host.py verifies the
    data path bit-for-bit (TOTAL diffs 0).
    Read-capture timing: at 81MHz a single DQ bit drifts in a
    placement-dependent way once the full design loads the clock tree (the
    standalone psram_test sti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
    [eth_nvme_top.sv, eth_tap_bridge.cpp, gowin_rpll_psram.v, nvme_controller_test_body.sv, nvme_tcp_bridge.cpp, nvme_tcp_rtl_bridge.cpp, nvme_vfio_bridge.cpp]
2026-09-06 gowin_psram: parameterize the cache line size and measure miss cost
    PsramDwordCache gains a LINE_BYTES parameter (512..4096): $clog2 derives
    the line/burst widths and the embedded dual-clock line RAM takes an ABITS
    parameter for its depth. test/psram_cache_test_body.sv now profiles
    stall-cycles-per-miss and a 4KiB-line variant is added.
    Measured: a 512-byte line costs ~444 user cycles per miss, a 4096-byte
    line ~6566 (it always transfers the whole line), so a larger line is
    worse per byte and only pays off when whole-line accesses dominate. NVMe
    keeps the 512-byte default (one LBA is exactly one line); the 4KiB build
    also perturbed placement enough to miss RMII timing. The cache is not the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
    [eth_nvme_top.sv]
2026-09-06 nvme: record the TcpEngine baseline (design, trade-offs, measured speed)
    Before redesigning the TCP engine, capture the current design so the
    improved version can be compared against it: architecture (in-order RX
    with FCS-trusted commit, 2KiB RX-window FIFO, a 2KiB TX ring that doubles
    as the Go-back-N buffer, two-pass checksum frame builder, passive
    two-connection FSM), its pros (small, ~2000 LUT, single clock) and cons,
    and a measured throughput matrix.
    Key finding: throughput caps at ~2 MiB/s regardless of block size or
    queue depth (about 16% of 100BASE-TX), limited by the 2KiB in-flight
    window - the engine sends at most one ring's worth per round trip and
    never tracks the peer window. T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
2026-09-06 nvme: TcpEngine improvement (stage 1) - enlarge the in-flight window
    The baseline capped at ~2 MiB/s (16% of 100BASE-TX) because at most one
    2KiB ring's worth of data was ever in flight. Raise the TX ring (which
    doubles as the Go-back-N buffer) and the RX FIFO/window from 2KiB to
    8KiB per connection, and cut segments at the MSS (1460) instead of 1024.
    The receive-sequence add is pre-registered (cm_rcv) so the wider ring
    still meets 50MHz. Control flow is unchanged, so it stays stable across
    multi-queue and repeated reconnects (smoke 3/3, SPDK steady).
    Measured on the board, same setup: sequential reads ~2x (1.8 -> 3.9
    MiB/s), writes ~1.5x (1.3 -> 2.0), 4K randread QD4 469 -> 640 IOPS, 4K
    ra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
2026-09-06 nvme: diagnose the TcpEngine throughput limit (window/RTT bound on the 9K)
    Add sim profiling to find where the ~2ms effective RTT goes: cycle
    timestamps on the bridge's TCP frame log, a SIM_BULK sustained-read mode
    in sim_host.py, and a TX-cadence profiler in eth_nvme_top.sv (unsent /
    tx-idle / ring-full counters, +define+DBG_APP).
    Finding: the engine never sits idle when it has sendable data
    (dready_idle ~ 0), so there is no scheduling waste to recover. The
    earlier "one segment per RTT" is just the 8KiB window filling in one wire
    time and waiting for the host ACK - a window/RTT limit, confirmed by the
    2x throughput from the 2KiB->8KiB window change. So ~3.9 MB/s reads is
    the practical ceil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
2026-09-10 nvme: 1 byte/cycle TCP app writer, explicit ring RAMs, Tang Primer 20K target
    The single-stream ceiling turned out to be the TcpEngine app-side TX
    writer: it spent three cycles per byte (arm, write and round-robin to
    the other connection, come back from the idle one), refusing two thirds
    of the bytes the target offered while the window sat empty. Replace it
    with a same-cycle grant that writes one byte per cycle and only uses the
    round-robin bit to break ties. The TX ring and RX FIFO sizes become
    parameters, and both live in an explicit two-port RAM (tcp_byte_ram): a
    read and a write of one array inside a single always block is extracted
    as a read-before-write RAM, which Gowin BSRAM does not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
    [eth_nvme_top.sv, rtl8201_init.sv, sim_host.py, top.sv]
2026-09-10 nvme: note that the Tang Nano 9K keeps the validated stage-1 engine bitstream
    With the 1 byte/cycle writer the 9K build only meets timing by 0.35%
    (Logic 83%, BSRAM 81%), the region where the 9K misbehaved even with STA
    passing; it is untested there. Record how to rebuild the validated
    stage-1 engine for the 9K.
    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
2026-09-11 nvme: DDR3 namespace for the Tang Primer 20K (riscv-veryl controller + line cache)
    Bring the Veryl DDR3 stack from riscv-veryl into rtl/ddr3 as verbatim
    copies (Ddr3Ctrl: x16 BL8 closed-page controller with a 16-byte line
    bus and its own CPU/pclk crossing; Ddr3PhyGw2a: GW2A IOLOGIC PHY; the
    bus interfaces; the behavioural DRAM model and IOLOGIC stubs for
    Verilator) and add LineDwordCache: NvmeCore's dword RAM contract over a
    512-byte write-back line held in four 32-bit lane RAMs, a miss walking
    the line as 32 line-bus beats. Simulated against the controller and the
    DRAM model with block-sequential and random traffic: 722.7 user cycles
    per 512-byte miss (~35 MB/s of line traffic, 3x the wire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
2026-09-11 nvme: DDR3 namespace verified on the Tang Primer 20K; probe LBA list knob
    Board results for the DDR3-backed namespace (128 MiB, 262143 blocks):
    smoke 7/7, data-integrity probe clean at low, middle and top LBAs with
    the out-of-range LBA rejected, a 20 s mixed-load soak, SPDK reads at
    8.0-8.2 MiB/s (identical to the BRAM namespace, now including 128 KiB
    I/O) and writes at 3.7-5.6 MiB/s (each 512-byte block costs a dirty-line
    write-back plus fetch). probe_host.py takes PROBE_LBAS to test chosen
    LBAs.
    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
2026-09-13 easycdr_trace: Manchester reverse control channel, descriptor, browser host
    - rtl/manchester (Veryl): ManchesterTx/Rx (SYNC violation framing, edge-driven
    RX, +/-10% clock tolerance), CtrlFrameRx ([A5][ADDR][DATA][CRC8]) and
    TraceCtrlRegs; 9 Verilator tests
    - easycdr_trace_tx: enable / ignore mask / periodic sampling / TX-side trigger
    (ARM, TRIG_MASK/VALUE, POST) and a periodic K28.4 descriptor record
    - Tang Primer 25K host: ManchesterTx on the pmod2 module's lane L1 (D10/D11),
    new commands '?' (descriptor), 'X' (forward to the control channel),
    'Z' (abort), 'F' (TX flags); descriptor latch in trace_rx_decoder
    - Tang Nano 9K: TLVDS_IBUF (pmod0 pins 1/7 = 28/27, CTRL_INVERT=1) ->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
    [top.v]
2026-09-13 rtl/oscdr: blind-oversampling CDR for the Gowin OSIDES32 sample word
    OsCdr: transition-class histogram (IIR), per-word +/-1 pointer steps with
    direction-aware hysteresis, 7/8/9-bit word extraction (bit slips), freeze
    input for eye scans; BitGearbox. Verilator tests at 0 / +/-1000 / +/-5000
    ppm and 0.15 UI jitter. Measured facts documented in README: OSIDES32's
    taps are static-only (DYN_DLY_EN="TRUE" disables them), the D input must
    come straight from the IBUF, and the FCLK phases cannot be shifted at run
    time.
    Claude-Session: https://claude.ai/code/session_012ZF9ALgxGq2adZBcuqyy3P
2026-09-13 easycdr_bert: BERT with own CDR receiver and TX-phase eye scan
    - rtl/bert (Veryl): PrbsGen (PRBS7/9/15/23/31, fixed, clock, error
    injection), PrbsChk (acquire then free-run, exact error counting, no
    lock on the all-zero fixed point), 64-bit counters with atomic
    snapshot, BertCore register file, BertHost byte-stream bridge
    - Tang Primer 25K: own receiver PHY (TLVDS_IBUF -> OSIDES32 with static
    taps and DHCE-gated phase clocks -> OsCdr -> gearbox), Gowin-IP variant
    via USE_EASYCDR_IP=1, TX PLLA dynamic phase shift for BERT-based eye
    scans, raw sample capture window for debugging
    - Tang Nano 9K: PRBS7 source at 999 Mbps (S2 injects one error)
    - host/bert.html (live BER, eye scan bat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
    [EasyCDR.v, EasyCDR_Top.v, define.v, ip_phy_gw5a.v, oscdr_phy_gw5a.v, pll_rx_500m_4ph.v]
2026-09-13 util/serial_bridge: Rust web server bridging one serial port to the browser UIs
    axum + serialport. Serves the embedded BERT and trace-viewer pages and a
    protocol-agnostic POST /api/xfer {write, read, timeout_ms}; open/close/
    flush (flush also cancels a pending transfer). The UIs use it through an
    HttpTransport that replaces Web Serial, so any browser (or another
    machine) can drive the FPGA tools.
    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
    [main.rs]
2026-09-13 manchester: reset-only reverse channel (PulseResetTx/Rx) and improvement notes
    - PulseResetTx / PulseResetRx (Veryl): slow square-wave burst on the
    AC-coupled lane, counted as edge-bounded long levels; polarity and
    comparator idle offset independent, immune to Manchester traffic and
    chatter. The line idles as a square wave: a burst from a static level
    is not detectable after AC coupling (return edges reach ~2 % of the
    swing), reproduced in the ac_idle_high test. 4 Verilator tests.
    - easycdr_trace: CTRL_PULSE=1 builds a Nano9K variant with only
    PulseResetRx (whole TX side LUT 535 -> 232, FF 431 -> 202); the 25K
    always carries PulseResetTx behind host command 'P' (also accepted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
    [top.v]
2026-09-13 easycdr_trace: separate the trace sample clock from the link clock
    easycdr_trace_tx is now a wrapper around trace_frontend (sample clock:
    synchroniser, change detection, timestamp, periodic sampling, TX trigger),
    trace_afifo (gray-pointer asynchronous record FIFO) and trace_link_tx
    (link clock: record / overflow / descriptor serialiser + tx_link_core).
    Control inputs stay in the link domain and cross through a handshaked
    bus (trace_cdc_bus, byte-chunked registered compare for GW1N timing),
    i_arm as a pulse; the descriptor request travels through the sample
    domain and returns as a sequence number in the same handshake word as
    the status flags, so ARM | DESC_REQ in one frame reports the new st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
2026-09-13 easycdr_trace: receiver takes the record layout from the descriptor
    trace_rx_decoder and trace_capture are built for MAX_WIDTH=64 /
    MAX_TS_BITS=32 and use WIDTH / TS_BITS from the last descriptor (16/24
    until one is seen), so one 25K bitstream serves any transmitter width.
    Nano9K demo width is a build knob (make TRACE_WIDTH=32, own build dir;
    project.tcl now generates defines_gen.v from CTRL_PULSE / TRACE_WIDTH).
    E2E adds a TX_WIDTH=32 run; ctrl_test.py trigger addresses are width
    relative. Verified on hardware: 16-bit and 32-bit Nano9K against the same
    25K bitstream, all checks pass.
    Timing on GW1N @100MHz: trace_afifo keeps gray(ptr+1) in a register so
    full/empty are a mux + compare; Ctrl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
2026-09-13 easycdr_trace: 742.5 Mbps link-rate variant (make RATE=742M5)
    For transmitters that reuse a 720p DVI clock pair (371.25 / 74.25 MHz).
    Nano9K: rPLL 27 x 55 / 4, Manchester BIT_CYCLES 37, pulse-reset windows
    scaled. 25K: hand-derived PLLA 50 x (22 + 2/8) / 3 = 370.83 MHz
    (-1120 ppm; PLLA limits are PFD 19..87.5 MHz and VCO 700..1400 MHz, so
    a fractional MDIV is needed), EasyCDR IP copy with DELAY_1 scaled
    21 -> 28 for the longer UI, own SDC. project.tcl selects PLL / IP / SDC
    from RATE; build directories get a _742m5 suffix. Verified on hardware
    with both boards at 742.5 Mbps (all checks pass), then restored to 1G.
    ctrl_test.py now soft-resets the TX first (a previous run leaves it
    armed).
    C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
    [EasyCDR.v, EasyCDR_Top.v, define.v, pll_rx_371m_4ph.v, pll_tx_3712.v, top.v]
2026-09-13 easycdr_trace: link diagnostics command and 25K loopback self-test source
    - trace_link_diag: receive-domain counters (commas, records, decode
    errors, overflow markers, descriptors, data words) with a snapshot +
    clear handshake from the host clock and a dead-clock timeout; host
    command 'L' returns status + counters (14 bytes). ctrl_test.py runs it
    first and stops with a hint when there is no lock; UI "Link diag".
    - 25K: second trace core on pmod0 lane L1 sending a 16-bit counter so the
    receiver can be checked alone with a pmod0 -> pmod2 cable
    (ctrl_test.py --selftest). Omitted in the 742.5 Mbps variant.
    - README: staged troubleshooting procedure (self-test -> link diag ->
    contro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
    [top.v]
2026-09-13 trace_afifo: synchronous prefetch read so the record FIFO maps to block RAM
    GW5A-25 has no distributed RAM (synthesis IF0005), so the asynchronous
    read of the FIFO was flattened into flip-flops (692 FF / 364 LUT on the
    25K). The read side now fetches into an output register (still
    first-word-fall-through) and the array is marked block_ram: 25K uses
    2 BSRAM (FF 2455 -> 1816), Nano9K 1 BSRAM instead of 9 RAM16. E2E and
    both-board hardware test pass.
    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
2026-09-13 trace_afifo: FIFO_RAM parameter, distributed RAM by default
    The transmitter side keeps RAM16 (small, placeable anywhere); only the
    GW5A self-test transmitter selects "block" (GW5A has no distributed
    RAM). Nano9K back to 9 RAM16 / 0 BSRAM, 25K unchanged at 2 BSRAM.
    E2E and both-board hardware test pass.
    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
2026-09-13 easycdr_trace: probe the EasyCDR 8b10b decoder (symbol injector, raw capture)
    - trace_sym_inject: host-loaded list of up to 64 raw 10-bit symbols played
    once or looped in place of the self-test transmitter's stream ('J').
    - raw capture mode ('R' 1): every received word stored as
    {align, err, dout[9], K, data}; capture DATA_BITS 12, dump generic.
    - host/decoder_probe.py: Python 8b10b encoder (RD-tracked, self-checked)
    and the probe suite: RD violation, invalid code groups, all 12 K codes,
    A7 alternates, comma phase shifts, dout[9] survey.
    - doc/decoder_probe.md: procedure and measured results. The IP decoder
    tracks running disparity (error on a wrong-RD form, value still correct,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
    [decoder_probe.py, top.v]
2026-09-13 easycdr_bert: IODELAY_1 dynamic-mode experiment knobs and dlyscan.py
    Build variants DYN_DLY1 / DYN_DLY0 / ADAPT_DLY1 put the OSIDES32 delays
    in dynamic or adaptive mode with SDTAP1 / VALUE1 / DLYSTEP1 driven from
    ext_ctrl; host/dlyscan.py measures the raw-sample pair-match rate and the
    per-class PRBS7 scores. Result (loopback, CDR frozen): static taps give
    pair-match 0.923 (delay real), every dynamic/adaptive configuration gives
    1.000 whatever SDTAP / VALUE / DLYSTEP does - the delay is inert as soon
    as the dynamic mode is enabled. project.tcl now generates defines_gen.v
    and variant builds get their own directory.
    Claude-Session: http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
2026-09-13 easycdr_bert: standalone IODELAY test - dynamic mode works outside OSIDES32
    IODLY_TEST=1 loops a 500 MHz tone (ODDR on the DPS-shifted TX clock,
    pmod2 L1 -> cable -> pmod0 L0) through a standalone IODELAY into a
    fixed-phase flip-flop; the ones-count over 255 samples locates the tone
    edge in TX-DPS steps (host/iodly_test.py). With DYN_DLY_EN the edge moves
    by the loaded DLYSTEP: 20/40/80 steps -> +2.05/+4.2/+8.2 DPS steps
    (12.8 ps/step, DLYSTEP is an absolute value loaded while SDTAP=0, VALUE
    does nothing in non-adaptive mode - as in the simulation model). Also:
    an OSIDES32-only reset after loading (ext_ctrl[5]) does not revive the
    dynamic delay inside OSIDES32. So the delay cell and the tool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
    [oscdr_phy_gw5a.v, top.v]
2026-09-16 easycdr_trace: signal map with configuration hash (descriptor v2)
    maps/*.map lists the traced signals (name[:width[:radix]], LSB first);
    host/tracemap.py derives the width and a CRC-32 of the canonical
    "name:width,..." string, and project.tcl bakes TRACE_MAP_WIDTH /
    TRACE_MAP_HASH into the Nano9K build (make TRACE_MAP=..., TRACE_WIDTH=N
    for an anonymous map). The transmitter sends descriptor version 2
    ([K28.4][02][WIDTH][TS_BITS][flags][HASH x4]); the receiver decodes
    either length and the '?' reply grows to 8 bytes. The browser viewer
    gets a Signal map field (same syntax and CRC-32, persisted) and flags a
    mismatch against the transmitter; ctrl_test.py --map does the same.
    E2E checks the has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
2026-09-16 easycdr_trace/web: named signal display, buses, derived signals, condition triggers
    With a signal map that matches the transmitter (or its width) the viewer
    draws one row per signal: single bits as levels, wider signals as value
    boxes (hex / dec / bin / enum names), the record table gets one column
    per signal plus the raw word, CSV exports per-signal columns and VCD
    emits vectors ($var wire N id name [N-1:0], changed values only).
    Map lines "name = expr" define derived 1-bit signals (not hashed).
    Trigger conditions can be written by name ("s2 == 1 && count == 0x10",
    equality terms joined by &&) for both the host and the TX trigger; the
    ignore mask can be given as signal names. Verified headl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
2026-09-17 easycdr_trace: transmitter distributes its signal map (CTRL.MAP_REQ -> K28.6 -> 'N')
    The transmitter holds the map text in a byte ROM generated by
    host/tracemap.py --rom (project.tcl builds it from the selected map);
    TraceCtrlRegs gains CTRL bit 4 MAP_REQ, on which trace_link_tx sends
    [K28.6][LEN][text] once. trace_rx_decoder captures the blob, trace_capture
    keeps it in a 256-byte buffer and answers host command 'N' with
    [LEN][text]. The viewer fetches the map automatically when the '?' hash
    does not match its own map (or on the Fetch from TX button); ctrl_test.py
    --fetch-map checks the text. The 25K self-test transmitter re-sends its
    map every 0.34 s so the path works in loopback. E2E (3 co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
2026-09-17 easycdr_trace: tick records (K28.7) mark the end of the trace
    The transmitter now emits [K28.7][ts] every 2^TICK_LOG2 (default 65536)
    sample clocks while enabled, so the receiver knows how long the last
    value was held. Ticks carry no data, do not count as post-trigger
    records and are folded into a data record when both coincide.
    MODE bit2 TICK_DIS (TraceCtrlRegs) turns them off.
    - trace_frontend: tick counter, FIFO word gets a tick flag bit
    - trace_link_tx: tick words go out as K28.7 + timestamp bytes only
    - easycdr_trace_tx: i_tick_dis in the cfg bus, TICK_LOG2 parameter
    - 25K: capture buffer keeps K28.7, decoder ignores it as a record
    - web UI: ticks extend the waveform / end marker to th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
2026-09-17 easycdr_trace/25k: pin the signal-map buffer to block RAM (already 1 SDPB)
    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
2026-09-17 rtl/trace: start the Veryl migration with tx_link_core
    New Veryl project rtl/trace (same conventions as rtl/manchester).
    easycdr_trace_tx_core keeps its module name, ports, FRAME_LEN and the
    asynchronous active-low reset (reset_async_low), so top.v and the E2E
    bench are unchanged. The 8b10b encoder is referenced as
    $sv::displayport_encoder_8b10b to avoid pulling the whole displayport
    project in as a dependency.
    - veryl test: test/tx_link_core_body.sv (FRAME_LEN 16 / 8) checks comma
    slots, o_ready, byte order and idle filler through the 8b10b decoder
    - eda/easycdr_trace Makefile / project.tcl / test/Makefile use the
    generated rtl/trace/tx_link_core.sv and run `veryl build` first;
    src/c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
2026-09-24 rtl/trace: port trace_link_tx and trace_frontend to Veryl
    Same module names, ports, parameters and asynchronous active-low reset
    as the Verilog originals, which are removed from src/common.
    - trace_link_tx: byte serializer uses a packed byte array instead of the
    runtime part-select; tick / record / overflow / descriptor / map paths
    unchanged
    - trace_frontend: SYNC_STAGES / HAS_PERIODIC / HAS_TRIGGER generate-ifs,
    periodic down-counter, trigger FSM, tick counter
    E2E 3 configs pass; Nano9K demo synthesizes to the same LUT/FF count
    (988/778), w32 / pulse / 742M5 variants build with no timing violations.
    Hardware check pending (25K not attached).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
2026-09-24 rtl/trace: port trace_cdc, trace_afifo and the easycdr_trace_tx wrapper to Veryl
    The whole transmitter is now Veryl; eda/easycdr_trace/src/common is gone.
    - trace_cdc: sync_bit / sync_pulse / reset_sync / cdc_bus with clock-domain
    annotations and unsafe(cdc) on the consuming flops
    - trace_afifo: gray-pointer async FIFO; RAM_STYLE selects an
    (* syn_ramstyle *) attribute, which Gowin honours (RAM16SDP on GW1N,
    SDPB on GW5A)
    - easycdr_trace_tx: same ports/parameters; the combined sample-domain
    reset is an explicit unsafe(cdc) cast to reset_async_low
    Makefile fix: the `veryl build` recipe sat before the include and had
    become the default goal, so `make TARGET=...` had not been regenerati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
2026-09-24 rtl/trace: port the 25K receiver helpers (decoder, link diag, symbol injector) to Veryl
    trace_rx_decoder, trace_link_diag and trace_sym_inject move from
    eda/easycdr_trace/src/tangprimer25k to rtl/trace with the same ports
    and asynchronous active-high resets. Byte accumulation uses packed byte
    arrays instead of runtime part-selects. E2E 3 configs pass; the 25K
    builds cleanly (LUT 2958 / FF 2757 / 16 SDPB, zero TNS).
    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
2026-09-24 rtl/trace: port trace_capture to Veryl - everything but top.v is Veryl now
    Same ports and parameters; host command bytes become constants, the
    trigger mask/value are byte arrays, the ring buffer and map buffer are
    split into a pclk write process and a clk_sys read process (unsafe cdc),
    and the quasi-static clk_sys registers read by the pclk FSM are marked
    as intentional crossings. E2E 3 configs pass; the 25K builds cleanly
    (LUT 2947 / FF 2759 / 16 SDPB with both RAMs inferred, zero TNS),
    as does the 742M5 variant. Hardware check pending.
    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
2026-09-24 easycdr_bert: RATE build variants (1.2 / 1.4 / 1.4875 / 1.6 Gbps) for the IP receiver
    To measure how far the GW5A-25 GPIO receive path (IDES limit 1600Mbps)
    can go, `make USE_EASYCDR_IP=1 RATE=1200M|1400M|1487M5|1600M` builds
    the loopback BERT at other line rates:
    - pll_rx_500m_4ph / pll_tx_500m take MDIV / MDIV_FRAC / ODIV parameters;
    the 90-degree phases are derived (PE_FINE = VCO/8, 2*ODIV steps)
    - project.tcl holds the rate table (PLL dividers, IP DELAY_1 = UI/4
    taps, FCLK period, pclk ratio), writes RATE_* defines and generates
    timing_gen.sdc from the timing_ip.sdc template
    - 1487M5 uses VCO 743.75MHz (MDIV 14+7/8) with ODIV 1 (1080p60 +0.17%)
    Timing: the LED status pins and the P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
2026-09-25 easycdr_bert: TX_TLVDS=1 knob (true LVDS output) - measured worse than the emulated LVPECL33E driver
    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
2026-09-25 easycdr_bert: TX_DIRECT=1 (serial output on pmod0 pins 1/7 for a direct-wire loop); measured worse than the USB-C path
    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
2026-09-25 easycdr_bert: terminated direct-wire results - 1.3Gbps clean, 1.4Gbps 1e-7, 1.4875Gbps 1e-4
    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
2026-09-25 easycdr_bert: CTLE build knob; HIGH stays best at 1.4875Gbps on the terminated direct wire
    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
2026-09-26 rtl/dvi_in: fix the word-align test and cover the glitch filter and relock
    dvi_in_word_align was written for the old clock-lane lock and timed out
    (2000 cycles vs ALIGN_WINDOW 4096 words per boundary). It now overrides
    ALIGN_WINDOW, tries all ten start offsets on a real frame and checks a
    clean frame after lock.
    New tests:
    - dvi_in_glitch_filter: single-word corruption on lane 0 (the ISI seen on
    unterminated Pmod lanes, and an active word turned into a control
    symbol) must not disturb de/hsync/vsync, and only lane 0 may flag it.
    - dvi_in_relock: link down past LOSE_TIMEOUT (outputs held, valid low),
    re-plug on another bit phase, relock and decode a clean frame.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
2026-09-26 rtl/ddc_edid: DDC EDID target and HPD control for an HDMI/DVI sink
    - ddc_edid: read-only I2C target at 0x50 (random / current-address /
    sequential reads, wrap at 256). The E-DDC segment pointer and HDCP
    addresses are not answered, SCL is never stretched. Open-drain pads
    are split into input + output enable.
    - hpd_ctrl: HPD only while +5V is present (debounced) and the sink is
    ready, with a minimum low time on replug.
    - gen_edid.py: DVI-only EDID 1.3 (no CEA extension, so sources send
    plain DVI) with 1280x720@60 as the only timing; edid-decode --check
    passes.
2026-09-26 dvi_out, dvi_in: close timing at 148.5 MHz (1080p60)
    - dvi_out: the TMDS disparity n0 - n1 is computed one register stage
    ahead, so the popcount is no longer in the DC-balance counter's
    feedback path. Latency unchanged; outputs are identical to the
    previous version over 2M random cycles.
    - dvi_in: the lane-0 control-symbol match is registered before it
    enables the alignment counters (the IDES10 output drove 32-bit counter
    enables directly). SHIFT_SETTLE_CYCLES covers the extra clock.
    Both files also carry `veryl fmt` whitespace changes.
2026-09-26 eda/dvi_loopback: Tang Primer 25K DVI 1080p60 TX -> RX loopback
    One board transmits (OSER10, emulated LVDS) and receives (IODELAY +
    IDES10 + dvi_in, the dvi_capture PHY) through two Pmods and an HDMI
    cable. Both sides sum every frame of a static, symbol-rich pattern and
    the receiver compares them; counters, a sampling-phase scan and raw
    word dumps are reported over the USB-UART.
    Variants: RATE=720P, TX_SLOT=PMOD1, CTLE=OFF|LOW|MEDIUM|HIGH,
    TX_IO=<type>_<drive>, TX_CLK=ODDR. Logic-level loopback test: make sim.
    On hardware (TX on pmod1, RX on pmod0 with the biased Pmod DVI):
    720p is bit-perfect; 1080p locks with CTLE=HIGH but every frame still
    has a few pixel errors.
    dvi_capture's dvi_in_p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
    [dvi_in_phy.sv, frame_sum.sv, gowin_pll_27.v, loop_check.sv, loop_pattern.sv, loop_report.sv, pll_rx_1080p.v]
2026-09-26 eda/dvi_loopback: per-pixel error count, fine phase scan, PLL/clock diagnostics
    - loop_check regenerates the expected pixel from the received DE and
    compares every active pixel: X = wrong pixels, Y = wrong bits, so
    BER = Y / (F x N x 24). Decode errors alone mostly see blanking and
    were misleading: at some phases blanking is clean while almost every
    data pixel is wrong.
    - "f": 1-tap scan of O-16 .. O+15.
    - P / C fields: RX recovery PLL lock and RX clock count (frequency).
    On hardware, 1080p60 reaches BER 1.4e-4 at one phase (O=28) with
    LVPECL33E DRIVE=16 and CTLE=HIGH; the data eye is only 1-3 taps wide.
    CTLE MEDIUM/LOW/OFF and weaker TX drives are far worse.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
    [loop_check.sv, loop_report.sv, top.sv]
2026-09-26 eda/dvi_loopback: per-lane bit errors and per-lane sampling trims
    - loop_check counts wrong bits per lane (Z0/Z1/Z2 = B/G/R) and passes a
    per-lane IODELAY trim to the RX PHY.
    - dvi_in_phy (shared with dvi_capture) takes i_delay_offset_lane,
    added to the common offset per lane; dvi_capture ties it to 0 and
    still builds without timing violations.
    - UART: "a"/"0"/"1"/"2" select the common offset or a lane trim as the
    target of + - > < s f; lines show K (trims) and T (target).
    On hardware the lanes' best phases differ (R is 7 taps off). With
    O=5C and trims B 0 / G 0 / R -7, 1080p60 BER goes from 1.4e-4 (shared
    phase) to about 9e-6 (B ~5e-8, G ~4e-6, R ~2.3e-5).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
    [dvi_in_phy.sv, loop_check.sv, loop_report.sv, top.sv]
2026-09-26 rtl/dvi_in: ignore sync symbols that disagree with both neighbours
    CTRL_01 and CTRL_11 differ only in bit 9, so a single bit error inside
    an HSYNC pulse produced a valid control symbol with VSYNC set. The
    "genuine control symbol" guard let it through and the false VSYNC edge
    shifted a whole frame (seen on the 1080p loopback as one frame of wrong
    pixels on all three lanes). Sync/CTL outputs now update only from a
    control symbol that matches the previous or the next word on lane 0;
    real sync levels last many words, so edges do not move and no latency
    is added.
    dvi_in_glitch_filter now uses an 8-word HSYNC, injects mid-pulse, and
    adds the bit-9 case (a valid symbol that must not be flagged or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
2026-09-26 eda/dvi_loopback: queue UART commands, RX termination / per-pair CTLE variants
    - loop_report queues received command characters (16-entry FIFO) and
    waits for the previous offset update before the next command, so
    characters arriving while a line is printed are no longer dropped
    (automated tuning sent them and lost some).
    - RX_TERM=OFF and CTLE_CLK/D0/D1/D2 build variants.
    Measured at 1080p60 (O=5C, trims B 0 / G 0 / R -7, CTLE=HIGH, 30 s):
    B 5.8e-8, G 4.5e-6, R 2.8e-5, no lock loss. Removing the on-die
    termination leaves no usable phase; CTLE MEDIUM on R does not help.
    [loop_report.sv]
2026-09-26 eda/dvi_capture: add the DDC / EDID / HPD side channel
    rtl/ddc_edid runs on the 50 MHz board clock (new `clock` input, E2) so
    the EDID can be read before the source drives TMDS:
    - ddc_sda = B11 (open drain via IOBUF), ddc_scl = C11 (input),
    hpd = D11 (output); CEC (G11) reserved. These are pmod2's top row,
    wired from the Pmod DVI's side-channel pads.
    - No +5V sense line: HPD rises 200 ms after reset; S1 (H10) drops it
    for 200 ms to force an EDID re-read.
    - The board clock is asynchronous to the video clocks (no crossings).
    - Makefile runs `veryl build` for dvi_in and ddc_edid when needed.
    DDC is a 5 V bus: a level shifter or clamp is needed on B11/C11.
    Synthesised without timing viola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
    [top.sv]
2026-09-26 eda/dvi_capture: once-per-second UART status line
    cap_status prints the side channel (EDID bytes read, DDC offset, HPD)
    and the receiver state (PLL / word lock, pixel clock count, active
    width and lines, frames, frame-CRC mismatches, decode errors) on the
    USB-UART (C3, 115200 8N1). The line is assembled with constant indices
    only: a version built from an if-chain character function came out
    garbled from Gowin synthesis although it simulated correctly.
    First hardware run with a notebook PC as the source: it read the
    128-byte EDID and sends 720p60 (74.25 MHz, 1280 wide), but with many
    decode errors and 728-737 DE lines per frame (sampling phase still the
    one tuned for the Nano 9K source).
    Co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
    [top.sv]
2026-09-26 eda/dvi_loopback: capture triggers, external frame check, host script
    - Raw word capture keeps shifting until a trigger and can show words
    before it: "w" control symbol, "v" run start, "x" blanking word with
    lane 1/2 not a control symbol, "e" lane 1/2 decode error.
    - loop_check EXT_CHECK=1: no transmitter reference; counts every frame
    and an external bad-frame pulse (used by eda/dvi_capture).
    - host/loopctl.py: status / scan / fine / words / send over the
    USB-UART, parsing the fixed-position R / S lines.
    [loop_check.sv, loop_report.sv, loopctl.py, top.sv]
2026-09-26 eda/dvi_capture: UART phase tuning, CTLE=HIGH, bit-perfect from a notebook PC
    - The status line is replaced by eda/dvi_loopback's checker (EXT_CHECK)
    and reporter: frames, frame-CRC mismatches, per-lane decode errors,
    lock losses, DE pixels per frame, EDID reads / HPD, raw word captures,
    and UART-controlled sampling offset and per-lane trims (dvi_in_phy
    i_delay_offset_lane). RX on B3.
    - CTLE build variants (make CTLE=...), default HIGH.
    - Default offset 0x3C (DLYSTEP 84), the centre of the error-free window.
    With a notebook PC over HDMI (720p60 after reading the EDID), the
    error-free window is 0x20..0x58 with CTLE HIGH/MEDIUM (0x30..0x5C with
    CTLE OFF, so the old fixed 0x20 was outs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
    [top.sv]
2026-09-26 rtl/ddc_edid: 1080p60 EDID option
    gen_edid.py --mode 1080p emits edid_rom_1080p (1920x1080@60 as the only
    timing, range limits 59-61 Hz / 66-68 kHz / 150 MHz; edid-decode --check
    passes). ddc_edid's EDID_1080P parameter selects it.
2026-09-26 eda/dvi_loopback: previous-frame compare, trim defaults, scan wait fix
    - loop_check EXT_CHECK compares each frame's pixel sum with the previous
    frame's (static screen -> no bad frames), replacing an external CRC.
    Capture words / trigger inputs are registered once for 148.5 MHz.
    - loop_report TRIM_DEFAULT: per-lane trims applied at reset and by "d".
    - loopctl.py: a scan no longer waits for its 150 s limit when the first
    S line is at the very start of the buffer.
    - Drop the committed __pycache__.
    [loop_check.sv, loop_report.sv, loopctl.py]
2026-09-26 eda/dvi_capture: 1080p60 variant, bit-perfect from a notebook PC
    make RATE=1080P builds the receiver for 1920x1080p60: 148.5 MHz recovery
    PLL (eda/dvi_loopback's pll_rx_1080p), 1080p EDID, timing_1080p.sdc.
    The frame CRC32 and the per-line CRC block, which did not close at
    148.5 MHz, are replaced by loop_check's previous-frame sum compare;
    the error LED counter no longer needs a wide zero compare.
    With the same notebook PC the 1080p window is narrow and lane 2 samples
    about 7 taps early; a shared phase left a few wrong R pixels in every
    frame without any decode error. Offset 0x30 with trims B -1 / G +3 /
    R -7 (the RATE=1080P defaults): 7440 frames, 0 decode errors, 0 lock
    losses, 2073600 DE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
    [top.sv]
2026-09-26 eda/dvi_capture: pass-through re-transmission of the received video
    dvi_in's output feeds dvi_out + OSER10 on pmod1 (CLK L5, D0 K11, D1 E11,
    D2 A11; LVPECL33E DRIVE=16), clocked by the recovery PLL's pclk / fclk:
    no frame buffer, no clock-domain crossing, same pixel rate as the input.
    Blanking is sent while unlocked. Scope taps move to pmod2's bottom row.
    With a notebook PC at 1080p60 a monitor on the pass-through shows the
    picture. Running the TX narrows lane 2's error-free window to -10..-1,
    so the RATE=1080P default R trim becomes -5 (from -7): 1 min with 0
    decode errors, 0 lock losses and frame changes only from the PC's own
    redraw after the HPD toggle and the clock's minute tick.
    Co-A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
    [top.sv]
2026-09-26 rtl/hub75: HUB75 controller with BCM and a double-buffered VRAM
    Ported from riscv-veryl's Hub75 with the BCM gradation of the original
    Chisel implementation (COMPONENT_BITS planes, OE halving per plane) and
    a pixel-write port into a double-buffered VRAM addressed in chain order
    ({half, scan row, chain x}); a flip request is taken at the next panel
    frame boundary.
    Row shifting is now explicit: exactly CHAIN_LEN clock pulses per plane
    with the data set up while CLK is low, then CLK stays low for one LAT
    pulse and the OE pulse. Before, CLK free-ran through LAT and OE and the
    data lagged the clock by one pulse: with an edge-triggered latch every
    row showed one pixel shifted and the first column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
2026-09-26 eda/dvi_hub75: 720p input -> top-left crop on 64x64 HUB75 panels
    The top-left W x H (64 or 128 each, make PANEL=WxH, default 128x128) of
    the received 720p60 picture is shown 1:1 on 64x64 1/32-scan panels. A
    128-high display is one chain with the lower 64-row band to the right of
    the upper band (128x128 = 256x64); within a panel rows 0-31 are R1G1B1
    and rows 32-63 R2G2B2. crop_to_hub75 maps (x, y) to Hub75's chain
    address and sends {flip, addr, RGB555} through an async FIFO; the flip
    follows the last cropped line, and a frame that arrives while the
    previous flip is still pending is skipped.
    Buffering: a double-buffered frame buffer (BSRAM 32 for 128x128). The
    panel is refreshed continuously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
    [async_fifo.sv, crop_to_hub75.sv, top.sv]
2026-09-26 eda/dvi_loopback: colour-table upload commands in loop_report
    "G" <mask hex digit> <512 hex digits> streams 256 table bytes to the
    o_lut_* write port (mask bit 0 R, 1 G, 2 B) and "i" pulses o_lut_init.
    The upload is consumed in any state, so it is not lost while a status
    line is being printed (513 characters exceed the 16-entry command
    FIFO). loopctl.py gains "gamma <g> [rgb] [bits]" / "gamma identity".
    Tested in tb_loop: all 256 entries and the mask arrive while lines are
    printed, mixed-case hex, "i" gives one init pulse, reporter still alive.
2026-09-26 eda/dvi_hub75: per-channel colour tables (gamma), identity by default
    crop_to_hub75 looks each 8-bit channel up in its own 256 x 8 table and
    shows the top COMPONENT_BITS of the result. The tables are dual-clock
    block RAM, written from the board clock (UART "G" / "i" via
    loop_report) and read at the pixel rate (+1 clock of pipeline). After
    reset or "i" a board-side sequencer rewrites them to the identity
    (gamma 1.0 = the old behaviour).
    Panel-model test: identity pictures unchanged; R inverted + G gamma 2.2
    tables give the expected value on every pixel (all 8 input bits
    matter); "init" restores the identity. All four panel sizes pass.
    Synthesis: no timing violations, BSRAM 37/56 (128x128).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
    [crop_to_hub75.sv, top.sv]
2026-09-26 eda/dvi_hub75: BITS / HUB75_CLKDIV build variants (6-bit BCM)
    make BITS=6 builds 6 BCM planes per colour, make HUB75_CLKDIV=0 a
    25 MHz HUB75 shift clock (default 5 / 1). The panel-model test runs
    6-bit configurations too (128x128, 64x64, 128x128 at 25 MHz; every
    pixel matches, the 6th bit included) and reports the refresh period:
    128x128 5 bit 254 Hz, 6 bit 190 Hz, 6 bit at 25 MHz 305 Hz.
    Synthesis for both 6-bit builds: no timing violations, BSRAM 41/56.
2026-09-27 eda/dvi_hub75: HUB75 baseboard slots swapped (confirmed on hardware), DDC line monitor
    The baseboard's module port pmod0 (RGB / E / B) sits on board PMOD2 and
    pmod1 (LAT / CLK / OE / A / C / D) on PMOD1, i.e. eda/ethernet_video's
    orientation shifted by one slot. The old mapping left the panel dark.
    The UART X field now also carries DDC SCL falling edges and the SCL /
    SDA levels (found a miswired SCL with it).
    [top.sv]
2026-09-28 usb_device: Tang Primer 25K + Pmod USB bring-up of rtl/usb - enumerates at high speed
    - pll_usb 240/60MHz, UsbDevice + usb_phy_gowin, slot-parametric pins (USB_PMOD_A/B)
    - UART status frames (host/usb_status.py), pyusb echo test (host/usb_echo.py)
    - HS enumeration OK on first hardware run; ~20% SOF loss (RX bit phase not tuned yet)
2026-09-28 usb_device: FS works end to end - J/K from the differential receiver, SE0 from the comparators
    Hardware capture showed the 130mV single-ended comparators are too close to
    the FS low level (host driver + 1.5k pull-up), so usb_phy_gowin now derives
    J/K from the differential receiver and uses the comparators only for a
    24-sample-majority SE0 (SE_FROM_DIFF=1). FS-only build: enumeration, vendor
    requests and 8..2048-byte bulk loopback all 100%. HS still enumerates but
    lacks bit-phase tracking (long packets fail).
    Also: USB_FS_ONLY build knob, UART sample capture (C/S/D/R), soft reset,
    usb_status.py drains stale frames.
    [top.v, usb_phy_gowin.v]
2026-09-28 usb: 3-phase HS clock/data recovery (usb_hs_cdr) - simulation good, hardware still marginal
    - usb_phy_gowin: dynamic IODELAYs on the three receive paths (DYN_DLY), raw
    sample monitors, HS_CDR path: [dn, dp, dd] interleave (delayed paths see the
    line earlier), OsCdr OSR=3 + BitGearbox(16) + byte FIFO, idle handling that
    drains the packet tail; PHY gets i_rx_dd_valid (word stall)
    - OsCdr: OSR=3 support (argmin, dsel wrap); bench parameterized (24/3, USB HS)
    - tests: hs_cdr_tb (packets, idle gaps, ppm), hs_cdr_replay (hardware captures)
    - usb_device: capture of raw receivers + CDR state, usb_dlyscan.py, cap2hex.py
    Hardware: SOF reception ~91%, enumeration reaches address but stays flaky.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
    [top.v, usb_hs_cdr.v, usb_phy_gowin.v]
2026-09-28 usb: IODELAY tracking loop experiments (histogram-based), tap calibration (1 UI = 144 taps), stall test
    - usb_hs_cdr: optional delay tracking loop (i_track_en) driven by the CDR
    transition histogram; OsCdr exports class counts; comparator offsets
    recalibrated to +60/+108 taps (1/3, 2/3 UI at ~14.5 ps/tap)
    - usb_device: 't' command, tap in the capture word, dp vs dd[k-1] agreement
    for the delay-direction test
    - tests: hs_cdr_tb models the IODELAYs and tracking; usb_device_hs_stall
    checks the PHY with receive word stalls (passes)
    Hardware: tracking rails at tap 0 and lowers the SOF rate (5.8k vs 7.6k/s);
    fixed offsets give 95% SOF reception, HS bulk still failing.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
    [top.v, usb_hs_cdr.v, usb_phy_gowin.v]
2026-09-29 usb: HS receive with the 4-phase oversampler (OSIDES32, 8 samples/UI) - HS bulk works on hardware
    usb_hs_os32.v: OSIDES32 + OsCdr(OSR 8) + gearbox + async FIFO into the 60 MHz UTMI
    domain, comparator IDES8 squelch (lookahead, level hold), own-transmission mask,
    2-word transmit FIFO start, 480 MHz clock group for the whole HS serial path.
    OsCdr: DLY (delayed extraction so the acquisition lands on the first SYNC word),
    level i_reacq, centred acquisition cost, nearest pointer on class 0/7 jumps,
    packed vectors (Gowin was extracting the arrays as RAM), burst test.
    UsbPhyRx: HS SYNC needs 6 zeros, whole-word post-EOP blanking, stall timeout.
    UsbPhyTx: input register stage, no J word before the SY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
    [oscdr_phy_gw5a.v, pll_usb_os.v, top.v, usb_hs_cdr.v, usb_hs_os32.v, usb_phy_gowin.v]
2026-09-29 usb: soak test, eye scan tools, bulk FIFO block-RAM collision fix, deeper transmit FIFO
    usb_device: idle FIFO read address rd_ptr-1 and a one-packet OUT guard band so the
    block RAM ports never hit the same address in one cycle (silent one-byte corruption
    at packet starts, ~1 per GB, gone); default depth 4096. usb_hs_os32: 8-entry transmit
    FIFO started at 4 words seen through the synchroniser (placement-dependent handshake
    loss); eye scan hooks (frozen class, SYNC-relative offset, PLL phase step, edge
    histogram). OsCdr: i_phase_force/val/ofs, o_cnt, o_acq. top.v: 'F'/'Z' commands,
    packet statistics 'm' (37-byte frame), FIFO checksums via the vendor status.
    host: usb_soak.py, usb_eye.py.
    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
    [oscdr_phy_gw5a.v, top.v, usb_hs_cdr.v, usb_hs_os32.v, usb_phy_gowin.v]
2026-09-29 usb: 16 mA transmit drive, PCLK-side FIFO reset, ignore other devices' handshakes, packet log/hunt tooling
    With 8 mA the hub rejected ~2.5% of our 512 B packets (retransmissions; the CRC16 leak of
    that error rate matched the residual silent corruption); 16 mA: 0 retransmissions and
    46 GB each way without a mismatch. The soft reset now also resets the PCLK halves of
    both FIFOs (a stale pointer relation made the transmitter send old words after some
    resets). A handshake is only ours if it directly follows our packet (the hub repeats
    the host's ACKs to other devices). Packet log: summarised DATA entries, PING/NAK
    filtering, 8192-entry ring, per-packet byte sums; usb_hunt.py compares every 16 KB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
    [top.v, usb_hs_os32.v, usb_phy_gowin.v]
2026-09-29 usb: synchronous 120 MHz front end (no async FIFOs), EP1 byte-stream mode, Pmod default fix
    PHY: the 60 MHz link clock is now CLKDIV /8 of the same 480 MHz as the oversampler
    PCLK (/4), so the two domains are synchronous; the recovered bytes cross through a
    4-word register buffer and the transmit words are split into nibbles in PCLK
    (rtl/usb/gowin/usb_phy_gowin_p.v). UsbPhy itself stays at 60 MHz / 8 bits per clock:
    the bit-level decoder and stuffer (and the SIE byte mux) do not close 120 MHz on the
    GW5A. UsbPhy/UsbPhyRx/UsbPhyTx are parameterised for 4 bits per clock (W = 4) and
    UsbPhyBridge is the half-rate byte interface for that option; both are covered by
    usb_phy_{hs,fs}_loopback_w4 but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
    [top.v, usb_phy_gowin_p.v]
2026-09-29 easycdr_trace: USB 2.0 HS host transport (make USB=1)
    The 25K receiver gets the rtl/usb device core (EP1 byte stream) and Gowin PHY as a
    build variant: the ExtEasyCDR module moves to pmod0 (its 4-phase HCLK group is taken
    by the USB oversampler on BANK6/7), the self-test transmitter is not built, clk_sys is
    the USB 60 MHz, the UART stays as a fallback (the reply goes to the side that sent the
    last command). Host scripts share trace_transport.py (--usb pyusb / -p serial / --url
    serial_bridge). Hardware: link locked with zero 8b10b errors, ctrl_test ALL OK, a 32 KB
    dump takes 2.4 ms (2.8 s over the UART).
    [decoder_probe.py, link_ber.py, top.v, trace_dump.py, trace_transport.py, trace_view.py]
2026-09-29 usb: BOS + Microsoft OS 2.0 descriptor set (WinUSB binding for WebUSB on Windows)
    bcdUSB 2.10, GET_DESCRIPTOR(BOS) returns the MS OS 2.0 platform capability (vendor
    code 0x20), and the vendor request 0x20 / wIndex 7 serves the descriptor set with the
    Compatible ID WINUSB. The descriptor ROM is now generated by gen_descriptor_rom.py.
    Verified on hardware (lsusb -v, pyusb); device tests updated.
2026-09-30 usb: register-to-register clock crossings in the synchronous PHY wrapper; trace variant on it
    usb_phy_gowin_p: the recovered bytes / line state and the transmit line words now go through
    an extra clk60 register on each side, so every os_pclk <-> clk60 path is register to register
    and tolerates the CLKDIV /4 vs /8 release skew and placement (a build of the trace variant lost
    enumeration on that margin; a fabric-divided clk60 tried instead worked on Linux hosts only).
    Costs one 60 MHz clock of latency per direction.
    easycdr_trace USB=1: uses usb_phy_gowin_p (clk_sys = CLKDIV /8 of the USB 480 MHz), pins for
    the board orientation A=pmod2 / B=pmod1, USB_DBG=1 build option (usb_device-style stat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
2026-09-30 usb_device: project.tcl default Pmod orientation A=pmod2 / B=pmod1 (as the Makefile)
    Direct project.tcl runs (capture variants built outside make) still used the old A=pmod1 /
    B=pmod2 default and produced swapped-pin bitstreams.
2026-09-30 eda/dvi_hub75: README: 25 MHz shift clock fails on the panel chain
    Upper panels lost B2 (rows 32-63 turned yellowish) with BITS=6
    HUB75_CLKDIV=0; the 12.5 MHz BITS=6 build shows them correctly.
2026-09-30 hub75: CLK_LOW_EXTRA (stretched CLK-low phase); dvi_hub75 16.7 MHz variant
    The far panels of the 4-panel chain lost B2 at 25 MHz: their data is
    re-driven by the upstream panel's driver ICs, so only a longer shift-clock
    period helps. CLK_LOW_EXTRA keeps the data set up with CLK low for 1+N
    ticks (high stays 1 tick); CLOCK_DIVIDER=0 CLK_LOW_EXTRA=1 gives 16.7 MHz
    (low 40 ns / high 20 ns), 234 Hz at 128x128 6-bit, shown correctly on the
    panels (make BITS=6 HUB75_CLKDIV=0 HUB75_CLKLOW=1). The testbench now
    checks CLK low / high widths and data setup while shifting.
    [top.sv]
2026-09-30 eda/dvi_hub75: default to 6-bit BCM with the 16.7 MHz shift clock
    The configuration verified on the 4-panel chain (234 Hz at 128x128);
    loopctl.py gamma now rounds to 6 displayed bits by default.
2026-09-30 HDMI audio: data-island packets, 2ch LPCM playback, delta-sigma DAC; dvi_hub75 plays it
    - dvi_in: o_island / o_island_first / o_terc4 / o_terc4_err (TERC4-decoded
    data-island words), passed through dvi_in_phy
    - rtl/hdmi_rx: hdmi_packet_rx (32-word packets, BCH checks), hdmi_audio_rx
    (ACR N / CTS, Audio Sample layout 0, AVI InfoFrame; FIFO + NCO at
    fs = f_TMDS * N / (128 * CTS) with linear interpolation), second-order
    1-bit delta_sigma_dac, rgb_range_expand (limited -> full range)
    - ddc_edid: EDID_HDMI serves edid_rom_hdmi (gen_edid.py --hdmi: CEA-861
    extension with 2ch LPCM, HDMI VSDB, QS = 1)
    - eda/dvi_hub75: HDMI_AUDIO (default 1), DAC on header pins 19 / 20
    (D1 / E3), audio st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
2026-10-02 eda/dvi_hub75: GAMMA build option (power-on colour tables) and an exhibit kit
    - make GAMMA=<g>: the colour tables start (and return on 'i') as gamma <g>
    rounded to the displayed bits (gen_lut_init.py -> lut_init_rom), so the
    board runs without the UART; checked in sim (128x128_b6_d0_l1_g22)
    - exhibit/: program.sh (SRAM / flash), prepare.sh (128x128 / 30 fps /
    48 kHz stereo, uniform for seamless looping), play.sh (finds the FPGA's
    output by its EDID name, 1280x720, full screen with the video in the
    top-left, HDMI audio routed to the same port), status.sh,
    install-autostart.sh, README
2026-10-02 eda/dvi_hub75/exhibit: show.sh mode switch, launchers and Ctrl+Alt+1..5
    show.sh hanshin / demos / all / pattern / stop stops only our player
    (ffplay with the dvi_hub75 window title) and starts play.sh detached;
    install-launchers.sh adds Activities entries and GNOME custom keybindings
    without touching existing ones.
2026-10-02 eda/dvi_hub75: exhibit flyer (A4 landscape, one page)
    Same layout and palette as the simple_matter flyers: what HUB75 is, the
    hard parts, key numbers, system and panel-chain diagrams, features and
    highlights, hardware / tools, repository QR code.
2026-10-02 eda/dvi_hub75: README: how the 6-bit BCM works (timing behind 234 Hz)
2026-10-02 eda/dvi_hub75: shift-clock waveform trials on the exhibit panels; flash written
    16.7 MHz (low 40 / high 20 ns) stays the best of 25 / 16.7 / 12.5 (60/20
    and 40/40) / 8.3 MHz; longer periods made the far panels worse, so it is
    not a plain timing margin. The default (16.7 MHz, gamma 2.2) is in the
    board's flash, written with the exhibit PC's openFPGALoader v0.12.1.
    Sim configs for low 60 / 80 ns with a 20 ns high phase.
2026-10-09 usb3: SuperSpeed link-layer primitives and Tang Console 60K target groundwork
    rtl/usb3 (Veryl): usb3_pkg (K-codes, link command encodings, CRC-5/16/32,
    scrambler LFSR), Usb3Scrambler (4 symbols/clock), Usb3RxFifo (SKP removal,
    8-symbol window), Usb3RxParser (HPSTART/LCSTART/COM detection at any
    alignment, header CRC check, DPP CRC-32/DPPEND, TS1/TS2, Logical Idle),
    Usb3TxFramer (link commands, header packets, aligned DPP tail, SKP OS
    scheduling). Tests: Python reference model vectors and a framing loopback
    with SKP insertion, re-alignment and corruption. doc/spec_notes.md is the
    implementation digest of USB 3.2 Rev 1.1 / PIPE 3.1 (device, Gen1 x1).
    eda/targets/tangconsole60k: Gowin IDE laun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
2026-10-09 usb3: LTSSM, link layer, device link top and PIPE host model
    Usb3Ltssm: Rx.Detect, Polling (LFPS handshake, TSEQ, TS1/TS2, Idle), U0,
    U3 with host wakeup, Recovery, Hot Reset, Warm Reset detection, PIPE
    power states / receiver detection / LFPS through TxElecIdle+TxDetectRx.
    Usb3Link: header sequence numbers, Rx buffer credits, LGOOD/LCRD, LBAD
    -> LRTY retransmission from a 4-entry Tx buffer, LUP keep-alive, U0
    timers, LXU for LGO_U1/U2, LAU/LPMA for LGO_U3, Port Capability /
    Configuration LMP exchange. Usb3Top ties the receive and transmit paths
    together on a 32-bit PIPE at 125 MHz.
    test/usb3_host_bfm.sv is a PIPE-level host model (PHY handshakes, LFPS,
    host LTSSM/link layer, bit-serial scr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
2026-10-09 usb3: protocol/device layer with SuperSpeed descriptors and EP1 byte streams
    Usb3Device: EP0 control transfers (standard requests incl. SET_SEL /
    SET_ISOCH_DELAY / U1-U2 enable, vendor 0x01/0x02 and the MS OS 2.0 set),
    word-wide descriptor ROM generated by gen_descriptor_rom.py (bcdUSB 3.10,
    EP companions, BOS with USB 2.0 ext / SS capability / MS OS 2.0), EP1
    bulk OUT into a packet buffer drained as a byte stream, EP1 bulk IN from
    a byte stream packed into two 1024-byte buffers with idle flush and ZLP,
    NRDY/ERDY flow control, PING response.
    The host model gained control / bulk transfer helpers; usb3_device runs
    enumeration, STALL, vendor requests and bulk traffic with flow control.
    Co-Aut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
2026-10-09 tangconsole60k: target definition and M1 bring-up build of the USB 3 device project
    eda/targets/tangconsole60k: GW5AT-LV60PG484AC1/I0 target (openFPGALoader
    --board tangconsole, needs a build from git master for the GW5AT-60
    idcode) and board notes from the Console schematic: USB3-A port 1 =
    SerDes Q0 Lane2 + USB 2.0 pair M15/M16, port 2 = Lane3 + H13/G13,
    REFCLK1 from the MS5351 CLK1/CLK0 pair, UART U15/V14, sys_clk V22.
    eda/usb3_device: project skeleton for the SuperSpeed device; M1=1 builds
    the bring-up top (UART status line, USR_CLK_IN frequency counter).
    Verified on the board: programming, UART on /dev/ttyUSB1, 27 MHz on
    usr_clk_in. The MS5351 is owned by the BL616 (its console sets CL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
2026-10-09 usb3_device: add the Console pin constraints (force-added past the global *.cst rule)
2026-10-11 slogic16u3_probe: JTAG pin investigation design for the Sipeed SLogic16U3
    Soft boundary scan through GW_JTAG ER1 (TCK/TDI oversampled by the internal
    oscillator), a pyusb host tool for CMSIS-DAP v2 / FT2232 probes (IEEE 1149.1
    SAMPLE on the factory firmware, ER1 read/drive, classify, blink-scan, map-bsr),
    an iverilog co-simulation and the slogic16u3 target definition.
    Findings recorded in README.md / pins.csv: the LA inputs are divided by ~1/2
    and compared by the FPGA itself (SSTL33_I with the bank 1 external VREF on M8,
    fed by the RC-filtered J12 PWM; Vth ~ 6.7 V x duty), the CK inputs are not
    divided, LEDs, MODE/reconfiguration behaviour and the SAMPLE cell map.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
2026-10-11 slogic16u3_probe: LA threshold, USB2 / oscillator pins and a SerDes Q0 probe
    - LA_IO / LA_VREF / LA_EXTRA: the LA inputs are divided ~1/2 and compared by
    the FPGA itself (SSTL33_I, bank 1 external VREF on M8 = RC-filtered J12 PWM,
    Vth ~ 6.7 V x duty); the CK inputs are not divided. 1/128 PWM duty (v5).
    - pins.csv: C14 = USB2 D+ 1.5k pull-up, D+ = H3/K3/P2, D- = M2/K2/P1
    (SoftPHY Single LVDS layout), D14 = enable of the 125 MHz oscillator on
    SerDes Q0 REFCLK0.
    - SERDES=1: bare GTR12_QUADB (quad_probe.v) or a GUI-generated Customized PHY
    (SERDES_IP=, targets/slogic16u3/ip_trial) with reference-clock detect and
    frequency counters on ER2 (host: serdes). The GW5AT-15 quad needs its CS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
2026-10-11 slogic16u3_usb2: full-speed USB 2.0 device on the SLogic16U3 with rtl/usb
    D14 enables the 125 MHz oscillator on SerDes Q0 REFCLK0; the lane 0
    tx_pcs_clkout of a GUI-generated Customized PHY feeds a PLLA (VCO 1200 MHz)
    for 60 MHz. UsbDevice + UsbPhy (HS_CAPABLE=0) drive the dx pair (K3/K2 or
    P2/P1, DX=K|P) as two LVCMOS33 pads at one sample per 60 MHz clock; the
    comparator pairs H3/H2 and M2/M1 must be declared (as unused pins their weak
    pull-ups held the line in SE1). Status over JTAG ER1 (jtag_status.v,
    host/usb2_status.py). Enumerates and passes the 8..2048 B bulk loopback with
    either pair.
2026-10-11 slogic16u3_usb2: high-speed USB 2.0 on the SLogic16U3 (IDES16 at 960 MHz)
    usb_phy_gowin_sl.v is a UsbPhy front end for boards wired in Gowin's SoftPHY
    "Single LVDS" arrangement: one emulated-differential dx pair carries both
    the transmitter and the receiver. OSIDES32 cannot take an IOBUF output
    (CK3001), so the receiver uses an IDES16 at twice Gowin's FCLK (960 MHz DDR =
    4 samples per HS bit, OsCdr OSR 4). The transmitter is an OSER16 sending each
    bit 4 times, with a fabric OEN delayed to match the serialiser. pclk is
    960 / 8, clk60 is 480 / 8 from the same VCO (pll_hs960).
    The two CLKDIVs can start ~1 ns apart. Sampling a pclk toggle with clk60
    was then a hold race, and on 2 loads out of 8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
2026-10-11 slogic16u3_usb3: SuperSpeed USB 3.0 device on the SLogic16U3 (enumerates, not stable yet)
    The USB-C SuperSpeed pairs reach SerDes Q0 lane 0 through the VL162 mux,
    which switches the plug orientation by itself. To find the lane, all four
    Q0 lanes were set to receive at 5 Gb/s and checked for the host's LFPS
    (top_lanes.v). The device is the Gowin USB 3.0 PHY IP (Q0 Lane0, QPLL0,
    REFCLK0 125 MHz) with rtl/usb3. Status and debug go over JTAG: ER1 holds
    the LTSSM history and receive statistics, ER2 (now writable) holds a
    1024-word PIPE trace and a header packet log.
    REF=1 runs Gowin's reference controller on the same PHY. It reached
    SuperSpeed, which showed the board and PHY were fine, so the re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
2026-10-11 slogic16u3_usb3: stable SuperSpeed link, real rtl/usb3 tests, PRBS IN throughput test
    Fixes in rtl/usb3 found on the SLogic16U3:
    - Ltssm: the registered timeout flags still held the previous state's value in
    the first clock of a new state. Recovery.Active, entered after a long stay
    in U0, timed out at once and dropped to eSS.Inactive on every Hot Reset.
    The flags are now masked in that clock.
    - RxFifo / RxParser: the Gowin PHY clears RxValid for single words anywhere,
    also inside packets. The FIFO shifted an empty word into the window, which
    the parser read as payload, so good DPPs failed their CRC. The window now
    holds on a gap and the parser stalls (o_adv / i_adv). Only gaps lo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
2026-10-11 usb3: EP1 IN bursts and a 32-bit input, 362 MB/s to the host on the SLogic16U3
    Usb3Device:
    - A 32-bit EP1 IN input (i_txw_*, 4 bytes per clock) next to the byte stream.
    - EP1 IN is a ring of 8 packet buffers with bMaxBurst 7. Data packets go out
    back to back up to the NumP the host allows, stay until acknowledged, and
    are resent from SeqNum on a retry.
    - Responses that find the link slot busy wait in a 2-entry queue instead of
    being dropped (lost EP1 OUT ACKs had failed transfers).
    - NRDY clears the burst credit, so nothing goes out between ERDY and the
    host's ACK.
    - After a short packet / ZLP no more packets go out until it is
    acknowledged (the host ends the transfer and drops lat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
2026-10-11 usb3: EP1 IN bMaxBurst 15 (16 packet buffers), 446 MB/s to the host
    The xHC hands out IN credits one burst at a time. NumP in its ACKs only
    counts down, and the next ACK with NumP = bMaxBurst + 1 comes after the
    last packet of the burst. That leaves the link idle for about 1.9 us per
    burst. With 8 packets per burst this capped the rate at 426 MB/s; with 16
    packets it reaches 446 MB/s.
    - Usb3Device: IN_BUFS 16 with wider buffer indices, and o_dbg_state
    widened to 64 bits.
    - The framer read address (DPP base/address) is 13 bits through Usb3Link,
    Usb3TxFramer and Usb3Top. The map is now: IN buffers 0x0000-0x0FFF,
    descriptor ROM 0x1000, small buffer 0x1800.
    - Test: a 16-packet burst read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
2026-10-11 slogic16u3_la: logic analyzer on the SLogic16U3, 800 MS/s x 4 / 400 x 8 / 200 x 16 at 400 MB/s
    rtl/la (Veryl):
    - LaFront: picks the samples of one group of 8 channels from 8 samples per
    100 MHz clock. The internal clock divides 800 MHz by 1/2/4 or by 8 and
    up. External clocks use edges seen in the clock input's own 800 MS/s
    samples (rise/fall/both, skew 0..7). A test mode replaces the pins with
    PRBS15/17 and the clock input with a square wave.
    - LaPacker: packs 1/2/4/8 channels into 64-bit words and sends START/END
    control beats (END carries the sample count and the overflow /
    unsupported-timing flags).
    - LaAfifo: an asynchronous FIFO. Its write-side "empty" follows the words
    a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
2026-10-11 slogic16u3_la: checked with real signals from a Tang Primer 25K pattern source
    eda/la_pattern_gen (Tang Primer 25K) drives jumper wires into the
    SLogic16U3:
    - PMOD0 -> CH0..7: an 8-bit counter advancing at 25 MHz.
    - PMOD2 -> CH8..15: the same counter in Gray code.
    - PMOD1 pin 1 -> CK0: a clock that rises in the middle of each step.
    STATIC=1 drives fixed levels instead, as a wiring check.
    host/la_check.py checks a capture of that pattern:
    - internal clock: every change must be +1, and each value must last about
    rate / 25 MHz samples;
    - edge clock: every sample must be the previous one + 1.
    la_stream -o now keeps the samples in memory, preallocated and touched
    before the capture, and write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
2026-10-12 slogic16u3_la: capture server and browser GUI in serial-bridge, waveform view shared with the trace viewer
    serial-bridge now also runs SLogic16U3 captures (src/la.rs, nusb): the
    stream is parsed into per-group rings, a software trigger looks at one
    group's samples (armed once the pre-trigger samples are in), and the
    capture is kept with OR/AND summaries per 256 samples and their pyramid,
    so that /la asks only for what the screen shows (view / find / vcd API).
    4 ch x 800 MS/s for 3 s: 400.6 MB/s, no overflow, viewable 4 s after the
    request, 0.5-3.4 ms per screen.
    The waveform view, signal map and condition expressions are in
    eda/easycdr_trace/host/web/wave.js, used by both la.html and the Ea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
2026-10-12 slogic16u3_la: prebuilt flash bitstream, DFU backup script and the update / restore procedure
    bitstream/ holds the build that met timing (sources of 672caf5,
    PLACE_OPT=3 TAG=base: pclk 125.1 MHz, sclk 104.3 MHz) with the next
    multiboot address set to the DFU image: slogic16u3_la.bin for the
    official DFU tool, slogic16u3_la.fs (the same bits) for a JTAG SRAM load,
    and their SHA256SUMS. It is the image flashed and checked on the board.
    host/dfu_backup.py reads the application (0x0, 1 MiB) and DFU (0x800000)
    regions through the official DFU USB-SPI bridge, twice each, and keeps
    them only when the reads agree. Read only. On the board: the DFU region
    matches the earlier backup, and the applicati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
2026-10-12 slogic16u3_la: hardware trigger (pattern + one edge at 800 MS/s, holdoff, auto stop, TRIG block)
    LaTrig checks every raw sample against a 16-channel mask/value pattern and
    an optional rise/fall/either edge on one channel, armed after the pre-trigger
    holdoff and stopping the capture after the post count. The trigger position
    and each group's sample count before it go to the host in a TRIG block
    (type 6). Version byte 2; the server uses it when present and falls back to
    the software trigger otherwise, and the GUI allows cross-group conditions.
    Timing: pclk best 124.2 MHz (-0.05 ns) so far, not closed at 125 MHz; the
    prebuilt flash bitstream stays at the v1 design. Register slices between
    the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
2026-10-12 slogic16u3_la: timing closed with the hardware trigger, prebuilt bitstream v2
    USB3 core paths cut by one register stage each: the receive parser's CRC-32
    runs one clock behind the data (DPP end / CRC result and link command check
    one clock later), the device's EP1 IN issue uses the ready flag / length of
    the next buffer registered a clock early, and the LTSSM clears t_us /
    tseq_cnt / det_fail from the registered state instead of the next state.
    LaFront keeps the one-hot sample select registered with rem, LaPacker takes
    k from tkeep without a popcount. Worst slack -1.1 -> about -0.45 ns.
    bitstream/: PLACE_OPT=4 ROUTE_OPT=2 LA_TIMEOUT=2600, pclk 125.039 MHz /
    sclk 104.821 MHz, rebuilt bit-ide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
2026-10-12 usb_phy_gowin_sl: 7-pin variant without the D- comparator (CMP1), one-Pmod board study
    CMP1=1 drops the D- comparator: squelch from D+ alone over a 3-word window, FS SE0 / line
    state from the term pins' LVCMOS33 inputs, SE0 suppressed during the chirp. Checked at HS on
    the SLogic16U3 (make HS=1 CMP1=1): bulk loopback, 10/10 reloads, 10/10 port resets.
    eda/pmod_usb_hs/SINGLE_PMOD.md: study for a one-Pmod HS device board using it.
2026-10-13 usb3_device: Tang Console 60K port of the USB 3.0 device with bring-up diagnostics (link not up yet)
    Port of the SLogic16U3 USB 3.0 device (rtl/usb3 + top.v) to the Tang Console 60K: SerDes Q0
    Lane2 (USB-A port 1P) / Lane3 (2P) with the Gowin USB 3.0 PHY IP, REFCLK1 from the MS5351,
    JTAG ER1 status over the Sipeed debugger (usb3_status.py --cable ftdi), UART status line.
    The IP netlists / CSR are regenerated from the 1.9.12.03 templates on the command line
    (GowinSynthesis on the IP's temp project, serdes_toml_to_csr_60k.bin); the Lane3 and two-lane
    wrappers are derived from the Lane2 one.
    The link does not come up yet: the host sees the receiver termination (hub port goes to Polling)
    but th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
2026-10-18 csi2 / csi_capture: Raspberry Pi camera (MIPI CSI-2) on one Pmod with a soft D-PHY
    rtl/csi2 (Veryl): 2-lane CSI-2 receiver on oversampled D-PHY lanes. The
    clock lane is oversampled like the data lanes (OSIDES32, ~4 Gsps) and its
    edges pick the data samples, so the non-continuous clock of the Pi
    cameras needs no PLL. SoT search with re-sync until a clean header
    (LP-01 + LP-00 noise produces false syncs), lane merge, header ECC,
    payload CRC. Tests: D-PHY model at 456 / 912 Mbps with LP chatter,
    ppm, jitter, lane skew (veryl test: 8 passed).
    eda/csi_capture: Tang Primer 25K top (pmod0, bank 1), IMX219 init ROM
    (640x480 binned, 2 x 456 Mbps), UART host interface (register access,
    counters, pack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
2026-10-18 displayport/sw-rs: rename the aux module to dp_aux (AUX is a reserved file name on Windows)
    src/aux.rs could not be checked out on Windows. Pure rename plus the
    module path updates; builds as before (default and `board` features).
2026-10-18 csi_capture / Pmod_RPiCamera: board and schematic adjustments (rev A)
2026-10-18 Pmod_RPiCamera: regenerate fab outputs from the rev A board; build.sh exports only by default
    The Gerbers, drill files and images were still from the generated board
    and lacked the KiCad edits of 8c5e363 (P-side length-tuning meanders,
    teardrops). build.sh now checks (ERC, DRC with schematic parity and a
    zone refill) and exports the KiCad files as they are; `--regen` rebuilds
    them from tools/gen_*.py and discards KiCad edits. BOM and placement are
    unchanged.
2026-10-18 Pmod_RPiCamera: logo, board name / revision / date / author on the back silkscreen
    As on the other TangFPGAExtensions boards: the local:logo footprint
    (board only, excluded from BOM / placement) and "Pmod RPi Camera / Rev.A /
    2026-10-18" plus "Kenta Ida (@ciniml)" (1.0 mm, 0.15 mm) on B.Silkscreen,
    in the free area behind the FFC connector. The old title line of the
    back legend is dropped. No copper change; fab outputs regenerated.
2026-10-18 Pmod_RPiCamera: J2 -> Amphenol SFW15R-1STE1LF (JLC stock), LCSC numbers, JLC BOM / CPL
    TE 1-84952-5 had a single unit in JLCPCB stock. SFW15R-1STE1LF (C3168538,
    9k in stock) is the connector of the Raspberry Pi Camera Module 2 itself:
    bottom contact with the same pin-1 convention, so with the standard RPi
    cable (contacts on opposite faces at the two ends, RP-008146) pin n meets
    pin n. Footprint drawn from FCI JSA95855 rev AE / JSA95854 (contacts
    0.6 x 2.0 @ 1.0, mounting tabs 0.7 x 4.2 at +-8.0, housing 19.6 mm); the
    contact row sits exactly where the TE one was, so no track changed.
    LCSC / MPN fields on all SMD parts (J1 hand soldered), build.sh writes
    JLC BOM / CPL (fab/jlc/, placement or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
2026-10-18 Pmod_RPiCamera: LCSC parts order list for 5 boards
    fab/lcsc/Pmod_RPiCamera_lcsc_5pcs.csv (LCSC BOM tool columns "LCSC Part
    Number" / "Quantity" first): 5 x per board + one spare FFC connector and
    header, rounded up to LCSC's minimum order (0402: 100, 0805 C: 20, PTC: 10).
    About $6.17 at today's prices; all lines in stock. tools/lcsc_order.py N
    regenerates it for N boards from the schematic's LCSC fields (queries LCSC
    for minimum order, price break and stock).
2026-10-18 pmod_usb_hs: KiCad board for the one-Pmod Single LVDS USB HS (CMP1) variant
    Pmod_USB_HS_Single: 22.86 x 27.94 mm, 2 layers, HRO TYPE-C-31-M-12,
    TN710 Arora-V network values, generated by gen_sch.py / gen_pcb.py and
    checked by build.sh (ERC / DRC with schematic parity) like Pmod_RPiCamera.
    The dx pair (R6 / R7 -> Pmod 1 / 7) stays coupled into the header and
    splits symmetrically between the rows. VBUS divider 100k / 150k in the
    study document (100k / 22k does not reach the LVCMOS33 VIH).
2026-10-18 pmod_usb_hs / Pmod_USB_HS_Single: +3V3 pours on F.Cu and routing adjustments
    Add three +3V3 copper zones on the top layer, with 4 more vias and a
    few more track segments.
2026-10-19 pmod_100base_tx: transformerless 100BASE-TX PHY on one Pmod (RTL, Gowin top, KiCad boards)
    rtl/eth100_phy (Veryl): two LVDS comparators at +-th, c = A ^ B is the
    NRZI waveform of MLT-3, so one OsCdr (IDES4 500 MS/s, OSR 4) recovers the
    125 Mbaud stream. 4B5B / scrambler / MLT-3 TX from two LVCMOS33 pins and a
    resistor network, descrambler lock, FLP autonegotiation with parallel
    detection. veryl test: 8 tests (+-100..1000 ppm, ISI, offset, AN, PD) pass.
    rtl/oscdr: FRAC parameter (default 0 = unchanged) so the integer IIR does
    not saturate at one symbol per word; README notes tracking assumes OSR 4.
    eda/pmod_100base_tx: design notes (README), Tang Primer 25K top (PLLA
    250 MHz, CLKDIV 125 MHz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
2026-10-19 pmod_100base_tx: logo, board name / revision / date / author on the back silkscreen
    As on the other boards (modretro_chromatic, Pmod_RPiCamera): the ciniml
    logo footprint (lib/pmod_100base_tx.pretty/logo, board only, excluded from
    BOM / placement) and "Pmod 100BASE-TX / MagJack (PHY) Rev.A / 2026-10-19 /
    Kenta Ida (@ciniml)" on B.Silkscreen, 0.9 mm so the block clears the Pmod
    header pads. The old title line is dropped and the notes moved to make
    room for the 6 mm logo.
    tools/silk.py on both boards owns the back silk: gen_pcb.py calls it, and
    run stand-alone it redoes the silk of the routed board in place (copper
    untouched; tools/drc.sh refills the zones). No copper change; ERC / DRC /
    pari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
2026-10-19 pmod_usb_hs / Pmod_USB_HS_Single: fab outputs from the KiCad-edited board
    build.sh no longer regenerates the schematic / board by default (REGEN=1
    does, overwriting the GUI edits); README updated accordingly.
2026-10-19 pmod_usb_hs / Pmod_USB_HS_Single: logo, board name / revision / date / author on the back silkscreen
    As on the other boards (Pmod_RPiCamera, pmod_100base_tx): the local:logo
    footprint (board only, excluded from BOM / placement) and "Pmod USB HS /
    Single Rev.A / 2026-10-20 / Kenta Ida (@ciniml)" on B.Silkscreen, the
    pinout lines below. tools/silk.py owns the back silk: gen_pcb.py calls it,
    and run stand-alone it redoes the silk of the KiCad-edited board in place
    (copper untouched, CRLF line endings of the GUI save kept). No copper
    change; ERC / DRC / parity clean, fab outputs regenerated.
2026-10-19 Pmod_RPiCamera: LCSC order list falls back to an equivalent when LCSC is out of stock
    C25744 (UNI-ROYAL 0402WGF1002TCE, 10k 0402) has no LCSC stock, while JLC
    has 19M of it as a basic part: JLC and LCSC stock are separate. The
    schematic keeps C25744 for JLC assembly; lcsc_order.py now buys the first
    in-stock equivalent from ALT instead (here YAGEO RC0402FR-0710KL, C60490,
    10k 1% 100ppm 62.5mW) and says so in the line's note. 5-board list
    regenerated (about $7.13 at today's prices).
2026-10-19 pmod_usb_hs / Pmod_USB_HS_Single: LCSC numbers, LCSC parts order list for 5 boards
    LCSC / MPN fields on every part but J1 (gen_sch.py PARTS, JLC basic parts
    where there is one; D1/D2 the TI original C436349, not the same-named
    clones with different clamp ratings). tools/update_fields.py pushes the
    schematic fields into the KiCad-edited board without touching copper
    (zones / tracks compared identical), keeping the CRLF of the GUI save.
    The BOM gets an LCSC column.
    fab/lcsc/Pmod_USB_HS_Single_lcsc_5pcs.csv (LCSC BOM tool columns first),
    from tools/lcsc_order.py as on Pmod_RPiCamera: about $5.84 at today's
    prices, all lines in stock; C52923 (1 uF) has no LCSC stock and is ordered
    as YAGEO CC04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
2026-10-19 pmod_100base_tx: LCSC parts order list for 5 MagJack boards
    kicad_magjack/tools/lcsc_order.py (as on Pmod_RPiCamera) writes
    out/lcsc/pmod_100base_tx_magjack_lcsc_5pcs.csv from the schematic's LCSC
    numbers plus J1: about $20.39 at today's prices ($12 of it the HR911105A),
    all lines in stock; C52923 (1 uF 25 V) has no LCSC stock and is ordered as
    YAGEO CC0402KRX5R8BB105 (C326568). Noted in the README.
2026-10-19 dvi_hub75 / Pmod_StereoDAC: Pmod line output for the delta-sigma DAC (3.5 mm jack + 3-pin header)
    KiCad 10 project eda/dvi_hub75/hw/Pmod_StereoDAC (generated by tools/,
    same flow as Pmod_RPiCamera): Pmod pin 1 / 2 = DSM L / R -> per channel
    the LPF of eda/dvi_hub75/README.md (1k / 3.3n C0G, 10k / 330p C0G),
    1 uF X7R DC block, 100k bleeder -> SHOU HAN PJ-313D stereo jack (tip L,
    ring R, sleeve GND; footprint drawn from the maker's drawing) and in
    parallel a 1x3 2.54 mm header (1 L, 2 GND, 3 R). 20.32 x 33.6 mm, 2
    layers, solid ground on B.Cu; logo / name / Rev.A / date / author on the
    back. ERC / DRC / parity clean; Gerbers, BOM, JLC BOM / CPL and a
    5-board LCSC order list (LCSC-only stock ga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
2026-10-19 DE0Header_PmodAdapter: Tang Primer 25K Dock 40-pin header to 4 Pmod + EXT (KiCad)
    Coupled LVDS pairs header -> Pmod columns, AMS1117 3V3 from the header's 5V,
    JLC BOM/CPL, LCSC order list for 5 boards, FPGA port CSV.
2026-10-19 DE0Header_PmodAdapter: M2.5 mounting holes matching the Dock's holes beside the header
    H1 / H2 (2.7 mm NPTH, ISO 7380 button-head keepout) at the same offsets
    from J1 pin 1 as the Dock's own holes on both sides of its 40-pin header
    (Dock iBOM J9 / J11: (-4.865, -1.575) and (+53.125, -1.575) from pin 1,
    57.99 mm apart), for two ~11 mm M2.5 standoffs. C2 moves above U1's tab
    (its old place is H1's). Board-only footprints: not in the BOM / CPL.
    ERC / DRC / parity clean.
2026-10-24 ethernet_hub75: Ethernet/UDP video to HUB75 in Veryl (Tang Primer 20K)
    - rtl/eth_mac: PHY-independent EthRxMac / EthTxMac with dual-clock
    PktFifo (crc32 / pkt_fifo copied from riscv-veryl, RX/TX engines split
    out of its EthMac) and RMII adapters RmiiRx / RmiiTx
    - rtl/hub75: Hub75Lanes, the Hub75 BCM engine with N lanes and a
    dual-clock double-buffered frame buffer (flip by toggle handshake)
    - eda/ethernet_hub75: EthService (ARP, ICMP echo, UDP 10004 video in the
    udpvideosend format with the 0xdeadbeef ack, UDP 10005 colour tables),
    UdpVideoWriter (RGB565 -> lanes, colour tables), core and the Tang
    Primer 20K top (RTL8201F RMII, 2 x HUB75 = 128x128, 49.5 MHz)
    - test: RMII host + H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
2026-10-24 ethernet_hub75: DK_LED-RXCARD (GW3A-20) top, soft and GMT HUB75 stages
    - rtl/eth_mac: RGMII adapters (10/100/1000, 125 MHz TX at all speeds),
    RXC speed meter, MDIO master; 125 MHz register stages in PktFifo
    (pointer gray decode, remaining count) and lane counters in EthTxMac
    - rtl/hub75: Hub75Planes, bit-plane frame buffer variant of Hub75Lanes
    - GmtCornerTurn: pixels to plane words through the GW3A GMT_DB block;
    core parameter HUB75_IMPL (0 soft, 1 GMT)
    - DkLedRxcardTop: PLLB, IDDR/ODDR/IODELAY, RTL8211E RGMII delays set
    over MDIO, HUB75 J4/J6 (128x128)
    - EthService: CLASSIFY stage, registered TX room, pipelined ack checksum
    - Verilator testbench for both stages (MDIO, 1000M line ra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
2026-10-25 ethernet_hub75: RGMII bring-up build options for DK_LED-RXCARD
    PHY_DLY (on/strap/off/hex), TXC_SHIFTED and RX_DELAY make variables go
    into the generated ethernet_hub75_cfg package. TXC_SHIFTED now moves
    TXD/TX_CTL to a 270 deg PLL output instead of re-timing TXC into a 90 deg
    clock: GW3A has no falling-edge FF and the 90 deg capture left 2 ns
    (-1.3 ns slack). clk270 is constrained only in TXC_SHIFTED builds.
    Testbench: TXS=1 runs the PHY model without TX delay.
2026-10-27 pmod_usb_hs / Pmod_USB_HS_Single: reference designators on the front silk, JLC BOM/CPL
    - Show the references (placed with circuitpnr `cpnr labels`; `cpnr label-check`
    reports no overlap / pad / ambiguity violations). Copper unchanged.
    - tools/jlc_files.py: JLC assembly BOM / CPL in fab/jlc (run by build.sh).
    - lcsc_order.py: C307331 (100 nF) is out of stock at LCSC; order C1525 instead.
    - Regenerated the fab outputs.
2026-10-28 pmod_usb_hs / Pmod_USB_HS_Single: JLC basic resistors for R2/R3 and R8/R9
    - R2/R3 36R -> 33R (C25105), R8/R9 1.8k/75R -> 4.7k/200R (C25900/C25087,
    VREF 132 -> 135 mV): same 0402 footprints, fewer JLC extended parts
    (left: D1/D2, J2). Board fields updated in place, copper unchanged.
    - lcsc_order.py: 33R alternative for LCSC (C138002).
    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
2026-10-31 ethernet_hub75: DK_LED-RXCARD with one 64x64 panel per connector (J4..J9, 128x192)
    Panels are 2 across and PANEL_ROWS (3, or 2 for the top four) down, row
    major from the top left on J4..J9. UdpVideoWriter / EthernetHub75Core get
    LANE_WIDTH: the display is cut into row-major lanes of LANE_WIDTH x
    SCAN_ROWS (LANE_WIDTH = WIDTH keeps the old one-chain layout of the Tang
    Primer 20K). Soft 6 panels uses all 120 BSRAMs; GMT fits 4 panels only
    (768-word plane memories round up to 4 BSRAMs), so make rejects GMT with
    6 panels. play_video.sh takes VIDEO_WIDTH / VIDEO_HEIGHT.
2026-10-31 ethernet_hub75: DK_LED-RXCARD works on hardware (6 and 4 panels, 1000M)
    Soft build, one 64x64 panel per connector on J4..J9: 1000M full duplex
    with the default PHY_DLY=on, ping/ARP ok, udpvideosend 489 fps (= panel
    refresh) for 128x128 and 128x192, test cards show the right layout,
    orientation and colours. CONN_ID=1 build shows a colour per connector on
    J4..J11 (used to find a cable mix-up); J10/J11 pins added.
    tools/testcards.py: panel numbers, colour bars and grey ramp, grid,
    bouncing ball. README: results and the ftdi_sio note for programming.
2026-10-31 rtl/ddr2: DDR2 controller (x16, BL8, one open row, read auto-calibration), GW3A IOLOGIC PHY, slot-level model and unit test
2026-10-31 ethernet_hub75: frame buffer in the DK_LED-RXCARD DDR2 (HUB75_IMPL=ddr)
    DdrFb (16-byte words through an async FIFO, flip marker in order with
    the writes, row fetch through the colour tables, start-up memory test
    and clear), Hub75RowLanes (row buffers instead of a whole frame), the
    DDR2 controller / PHY in the RXCARD top (PLL 333.3 MHz fclk, CLKDIV 4),
    a UDP status port (10006, tools/fbstat.py). Ddr2Ctrl: 24-slot read
    window (half the LUTs), power-up wait safe from the all-zero state.
    Simulation (DDR2 model) and PnR clean; not yet tried on the board.
2026-10-31 SLogic16U3, Pmod boards: BSL-1.0 SPDX license headers
    Add the SPDX-License-Identifier / Copyright header to the self-written sources of
    eda/slogic16u3_* , eda/targets/slogic16u3 and the Pmod boards (pmod_100base_tx,
    Pmod_RPiCamera, Pmod_StereoDAC, DE0Header_PmodAdapter). Gowin IP outputs and
    files derived from them are left as they are.
2026-10-31 ethernet_hub75: DDR2 frame buffer works on the DK_LED-RXCARD (read slot tuning)
    On the board the calibrated (first) sample of each read beat sat next to
    the data transition: hundreds of wrong words per 32 MB test, read side.
    Added a control port (UDP 10007: read capture override, memory test
    rerun), a 48-byte status (errors per pass, wrong-bit mask, tuning),
    tools/ddr2sweep.py, and DdrReadTune, which reruns the start-up test one
    slot later and keeps the better slot per beat parity. Tuned 1/3: 20 x
    32 MB clean; test cards and udpvideosend (488.8 fps) as the BSRAM build.
    Memory-test compare pipelined (mclk 112 MHz), Ddr2Ctrl read slot select
    registered. Model: +ddr_marginal (test MARG=1) to ex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
2026-10-31 ethernet_hub75: DDR2 + GMT variant (HUB75_IMPL=ddrgmt) for comparison
    Fetched rows go through GmtCornerTurn into bit-plane row buffers
    (Hub75RowPlanes). Same parameters as the DDR2 build: +734 LUT, +168 FF,
    +24 BSRAM (36 shallow plane memories), display Fmax 133.6 -> 110.9 MHz
    (32:1 bit select per output); simulation PASS, not tried on the board.
2026-10-31 ethernet_hub75: 8-bit gradation builds (COLOR_BITS) for all four frame buffers
    COLOR_BITS=6..8 with the OE unit scaled (16 >> (n-6)) so that refresh
    stays near (432.8 Hz at 8 bits). Simulation PASS for soft / GMT (4
    panels) and DDR2 / DDR2+GMT (6 panels); PnR clean. Status payload now
    sent from i_status at emit time (hdr back to 46 bytes), which removed
    the system-clock violations.
2026-10-31 Hub75RowLanes: two lanes per block RAM (18-bit write, 36-bit read) when they fit
    DDR2 build: row buffers 12 -> 6 BSRAM (26 in total); verified on the
    board (memory test, test cards, udpvideosend).
2026-10-31 slogic16u3_usb3: TAP=1 boundary observation of the USB 3.0 PHY soft IP
    project.tcl copies the IP's serdes.v with its plaintext internal nets brought
    out on SerDes_Top (TAP_o / TAP_clk_o); phy_tap.v logs the IP's DRP accesses and
    lane / PIPE status changes (optional LTSSM start state) and keeps a window of
    the transmit data written into the GTR12 quad; host/usb3_phytap.py reads both
    over ER2. README: what the hardware showed (LFPS = square wave in the data +
    DRP 0x8003a4 driver enable, Rx.Detect via 0x80033f / rxdet_result / 0x808b34,
    P-state DRP writes, clocks).
2026-10-31 usb3: our own USB 3.0 PHY on the GW5AT GTR12 quad (OWNPHY=1), SuperSpeed on the SLogic16U3
    rtl/usb3 usb3_phy_*: 8b/10b with the running disparity chained over four
    symbols a clock, LFPS as a square wave in the data, comma alignment, decoding,
    SKP removal, an elastic buffer to pclk, PhyStatus / receiver detection and the
    DRP writes seen on Gowin's PHY with TAP=1. eda/slogic16u3_usb3 usb3_softphy.v
    has the ports of Gowin's USB3_0_PHY_Top; project.tcl swaps it in a copy of the
    IP's serdes.v (quad, CSR and upar arbiter unchanged). RxElecIdle stays 1 in
    P0 while proper symbols come in (the LTSSM takes 20 ms of 0 for a Warm Reset).
    Verilator tests: rtl/usb3/test/run_phy.sh. On the board: enumerat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
2026-10-31 ethernet_hub75: bit-plane frame buffer in DDR2, no row buffer (HUB75_IMPL=ddrplane)
    Pixels are corner-turned (GMT, plane-major column order) on the way in
    and stored as bursts of {R, G, B} plane words per scan row / lane / word
    / plane; Hub75PlaneStream fetches one plane of a scan row at a time into
    a distributed-RAM ping-pong buffer. BSRAM 26 -> 19 (6 bit) / 32 -> 19
    (8 bit) with about the same logic; ddrplanesoft (fabric transpose):
    +1184 / +1568 FF. Works on the board (6 bit, GMT). Column index in the
    corner turn now counted (no DSP).
2026-10-31 slogic16u3_usb3: OWNPHY without TAP (place 4), hot reset test
    project.tcl: no SDC rename for OWNPHY (the receive clock net keeps its name).
    README: OWNPHY=1 alone needs PLACE_OPT=4 for pclk (124.1 MHz); on the board it
    enumerates, PRBS 379.5 MB/s with no error, 1 GiB loopback identical, 20 of 20
    hot resets come back.
2026-10-31 slogic16u3_usb3: OWNPHY closes 125 MHz with place 4 + serdesRetiming, same board tests pass
2026-10-31 slogic16u3_usb3: no upar arbiter either (NOARB=1), no encrypted Gowin block left
    TAP_UPAR=1 logs the quad side of the upar arbiter: the same addresses, data and
    handshake as the IP's channel, and the arbiter's plaintext wrapper ties upar_rst
    and upar_bus_width to 0. NOARB=1 (with OWNPHY=1) drops the arbiter from the copy
    of serdes.v and connects our PHY's register port to GTR12_UPARA directly.
    usb3_softphy registers its receive outputs. On the board (place 3 +
    serdesRetiming, pclk 125.9 MHz): enumerates at 5 Gb/s, PRBS 379.7 MB/s with no
    error, 1 GiB loopback identical, 20 of 20 hot resets come back.
2026-11-01 ethernet_hub75: up to 16 panels on the RXCARD (J4..J19, PANEL_COLS x PANEL_ROWS)
    - top: J12..J19 and the second group's CLK / LAT / OE / A..E, panels row
    major in connector order, PANEL_COLS (2 or 4); 4 x 4 = 256x256
    - frames over 64 KB: packet offsets in 2-byte units (UdpVideoWriter,
    DdrFb, udpvideosend, testcards.py)
    - DdrPlaneFb: read FIFO holds a whole plane, unpacker 2 nibbles per clock
    (Hub75PlaneStream FILL_NIBS) so that a 64-burst plane fetch fits the
    3.84 us shift
    - testbench: PCOLS, all 16 connectors, group 2 control checks
2026-11-01 ethernet_hub75: demo16.py frame-rate and GMT comparison scenes
2026-11-01 rtl/usb3: close 125 MHz on the GW5AT-15 without picking a PnR seed
    LTSSM: entry actions (Polling burst counters, RxPolarity / scrambling reset,
    the from-Recovery qualifier) no longer hang off the next-state decision, and
    the PowerDown change is made in the clock after the state change. Parser: the
    first ordered set per read position is found a clock early, CRC-16 and the TS
    checks run on a registered word. Device: transmit requests are registered
    before the hand-off to the link.
    slogic16u3_usb3 OWNPHY NOARB: every placement tried (default included) meets
    125 MHz (125.0 - 129.9 MHz); board tests pass, 447.4 MB/s IN.
2026-11-01 slogic16u3_usb3: own CSR generator, host quad register access, quad configured from the fabric (QCSR=1)
    csr/gw5at15_csr.py writes the quad's static configuration (CSR: 256 upar
    writes) from a base list and the fields found by changing one toml key at a
    time; csr/check_csr.py: byte-identical to Gowin's tool for 19 settings.
    NOARB builds put quad_drp_mux.v in place of the arbiter: our PHY plus host
    access through vendor requests 0x03 / 0x04 (host/quad_reg.py).
    QCSR=1 writes the CSR list from a ROM right after configuration; with
    QCSR_STATIC=none (empty CSR file) the board enumerates at 5 Gb/s and passes
    PRBS, 1 GiB loopback, Hot Reset x20, 447.4 MB/s, also after a power cycle.
    The PHY starts ~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
2026-11-01 util/hub75_stg: vertical scrolling shooter for the ethernet_hub75 panels (128x192)
    Rust, 60 fps, terminal keys (kitty protocol releases or auto-repeat), attract
    mode bot (--auto), frames into the top-left of the 256x256 / 128x192 display.
2026-11-01 slogic16u3_usb3: QCSR=1 (empty CSR file) boots from flash and passes the board tests
2026-11-01 slogic16u3_usb3, slogic16u3_la: our USB 3.0 PHY by default
    ownphy.tcl (shared): OWNPHY / NOARB / QCSR on unless set to 0 - our PHY,
    no upar arbiter, the quad configured from the fabric with an empty CSR file;
    no encrypted Gowin block in either design. OWNPHY=0 builds Gowin's IP as
    before (TAP=1 defaults to it). slogic16u3_la: la_stream -T passes all 15
    configurations, 400.7 MB/s at 800 MS/s x 4; at that rate the device FIFO
    overflows in more 10 s runs than with Gowin's PHY (5 / 24 vs 1 / 24, no
    Recovery, data intact) - not yet understood.
2026-11-01 hub75_games: games of about 3 minutes
    blocks / bricks: 3:00 time limit (clock, red in the last 10 s, TIME UP).
    stg: 3 stages of 32 s waves, the boss leaves after 25 s, ALL CLEAR with
    a bonus for ships and bombs. invaders: 3 waves then ALL CLEAR, the last
    aliens at most 1 px a tick. Bots: bricks aims at the last bricks,
    invaders leads the formation and avoids the shields; attract mode keeps
    the end screen up for 5 s.
2026-11-01 slogic16u3_usb3: REF=1 on our PHY too (PhyStatus held through reset, trace pins dropped)
    Gowin's reference controller waits for PhyStatus to fall after reset (PIPE: PHY ready); our PHY now
    holds it while in reset. top_ref.v gets the QCSR start delay and the XDRP ports; its constraints lose
    the trace pins it does not have (the build had failed on them). Both PHYs reach U0 with it and stop
    at the same place (descriptor read -71 on the host).
2026-11-01 hub75_games: fireworks and flame demos
    fireworks: rockets and eight shell types over a skyline, streaks from a
    fading glow buffer, sky flashes, a finale every 45 s.
    flame: a bonfire (heat field torn into tongues by a rising cooling map,
    embers, glowing logs) and three candles (procedural teardrop flames with
    halos and gusts), 30 s each. Demos run without a terminal (needs_keys).
2026-11-01 hub75_games: waterfall, aurora, storm and hourglass demos, showcase
    waterfall: a sheet textured by fall time, foam, mist, spray, moonlit pool.
    aurora: folding curtains with rays and running waves, bursts, meteors,
    a lake mirroring the sky. storm: drifting clouds, slanting rain with
    splashes, branched lightning with return strokes lighting clouds and
    ground, cloud flashes. hourglass: grain-by-grain sand in coloured
    layers, turns over when empty. showcase cycles all demos (40 s each).
    fx.rs: noise / blending helpers shared by the demos.
2026-11-01 hub75_games: matrix, lavalamp, fireflies, life, fractal, fountain and aquarium demos
    matrix: digital rain of made-up 3x5 glyphs with words now and then.
    lavalamp: metaball wax heated at the bottom and cooled at the top.
    fireflies: pulse-coupled flashing that drifts into synchrony.
    life: 64x96 Game of Life coloured by age with afterglow, reseeds.
    fractal: Mandelbrot dives into five spots, threaded rows, cardioid /
    periodicity checks (60 fps at the deepest zoom).
    fountain: seven nozzles, six programmes, underwater lights.
    aquarium: procedural fish (clownfish, a neon school, angelfish, tangs),
    light rays, caustics, seaweed, bubbles. showcase cycles all 13 demos.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
2026-11-01 hub75_games: clock and ELEKI EXPO 2026 demos, Japanese glyphs
    clock: analog, nixie-tube and 7-segment faces of the local time.
    expo: boot log, glowing title over a circuit board, the booth (匠の電子
    工作館 W40 ふがふが), oscilloscope motto, the seven halls, countdown
    to the close (EXPO_NOW pretends a time for a rehearsal).
    tools/gen_jpfont.py cuts the needed glyphs from installed fonts into
    src/jpfont.rs (no fonts needed to build); jp.rs draws them. fx: line
    and segment distance helpers. chrono for the local time.
2026-11-02 hub75_games explain: BCM scene speeds the cycle up until the blinking becomes brightness
    Four LEDs (63/45/20/7) share the cursor; each is drawn as bright as the
    share of the tick it was on, smoothed like the eye, as the scan scene does.
2026-11-02 hub75_games: output gamma moves to the board's colour table (--board-gamma 1.5)
    The tables get 8-bit values at start, demos apply only the rest of their
    gamma, games send the inverse so their colours stay as drawn; snapshots
    show the panel (board gamma applied). --board-gamma 1 = as before.
2026-11-02 ethernet_hub75: 8-bit gradation is the default for the DDR2 builds (works on the board)
    send_lut.py --bits defaults to 8 too.
2026-11-02 dk_led_rxcard_gw3a20: make deploy writes the external SPI flash (op 9); 8-bit build in flash measures 431.8 fps
2026-11-02 ethernet_hub75: UDP 10002 audio to I2S on J19 (NS4168 / Atom SPK base)
    AudioI2s: 2048-frame FIFO, start at 1024, 48 kHz Philips I2S with BCLK
    64 fs from a phase accumulator, (L+R)/2 in both slots. EthService
    answers the audio sender with the Chisel back-pressure reply
    {5, level, 2048} after each packet and every 256 frames played.
    DK_LED-RXCARD AUDIO=1 by default (J19 pins 1..3 = BCLK/LRCK/DATA).
    Sim: audio frames in order through an I2S receiver model; TP20K, soft,
    16-panel 8-bit regressions pass. PnR 16p 8-bit: LUT 7524, BSRAM 27, no
    violations. play_video.sh resamples audio to 48 kHz stereo.
2026-11-02 ethernet_hub75: I2S audio plays on the board (Atom SPK base wiring per its schematic, 3.3 V from J23)
2026-11-02 hub75_games: sound over the board's audio (UDP 10002); storm plays rain and thunder
2026-11-02 storm: thunder louder in the mids, rain sound off; ethernet_hub75: J19 needs a level shifter to the 3.3 V NS4168
2026-11-02 hub75_games: --record FILE writes the sound sent to the board to a WAV
2026-11-02 ethernet_hub75: I2S at 32 fs with 16-bit slots (like an ESP32 drives the NS4168); works on the board
2026-11-02 ethernet_hub75: the audio build is in the board's flash
2026-11-02 fireworks: the launch whistle and hiss fall in pitch as the rocket climbs
2026-11-02 hub75_games sfx: own jingles for the extra life, stage clear and all clear (the old ones were too close to well-known game tunes)
2026-11-02 hub75_games: game controller (DualSense via evdev) and the booth arcade (demos until a button, then a game menu)
2026-11-02 arcade: the PS button leaves a game for the menu (and the menu for the demos)
2026-11-02 arcade: a game runs to its own end (3 minutes / stages), no idle cut; d-pad and stick count as activity in the menus
2026-11-03 hub75_games: deploy.sh builds for the host's CPU (x86_64 / aarch64 for a Raspberry Pi 4) and installs the arcade service
